cmu-argus-2/Avionics-JetsonCarrier/jetson-orin-baseboard.kicad_pcb

## KiCad design jetson-orin-baseboard.kicad_pcb (2026-10-01)

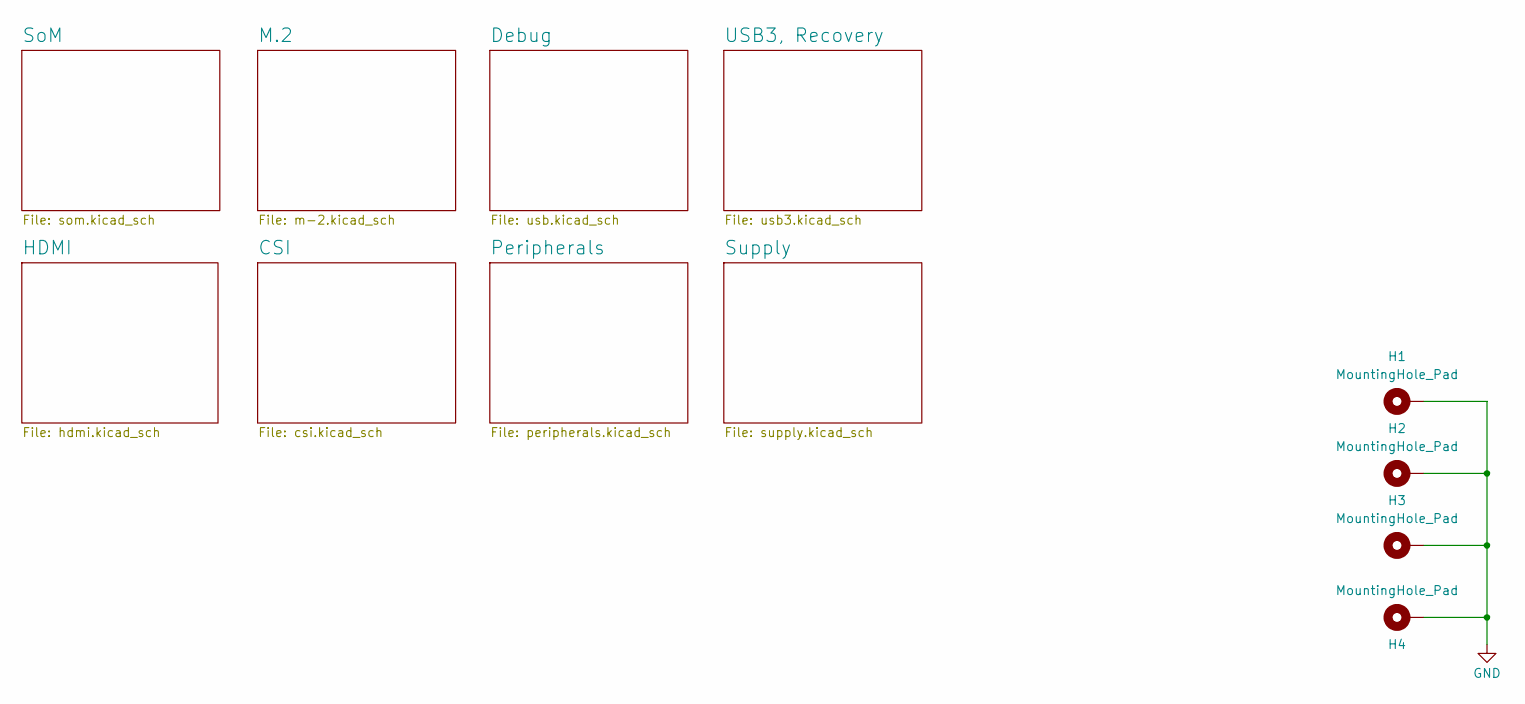
[picture p1: schematic jetson-orin-baseboard.kicad_sch, Argus Carrierboard]

Parts:
H1, H2, H3, H4: MountingHole_Pad; MountingHole_3.2mm_M3_Pad_Via

Connections:
GND: H1.1 (1_1), H2.1 (1_1), H3.1 (1_1), H4.1 (1_1); also elsewhere on the board

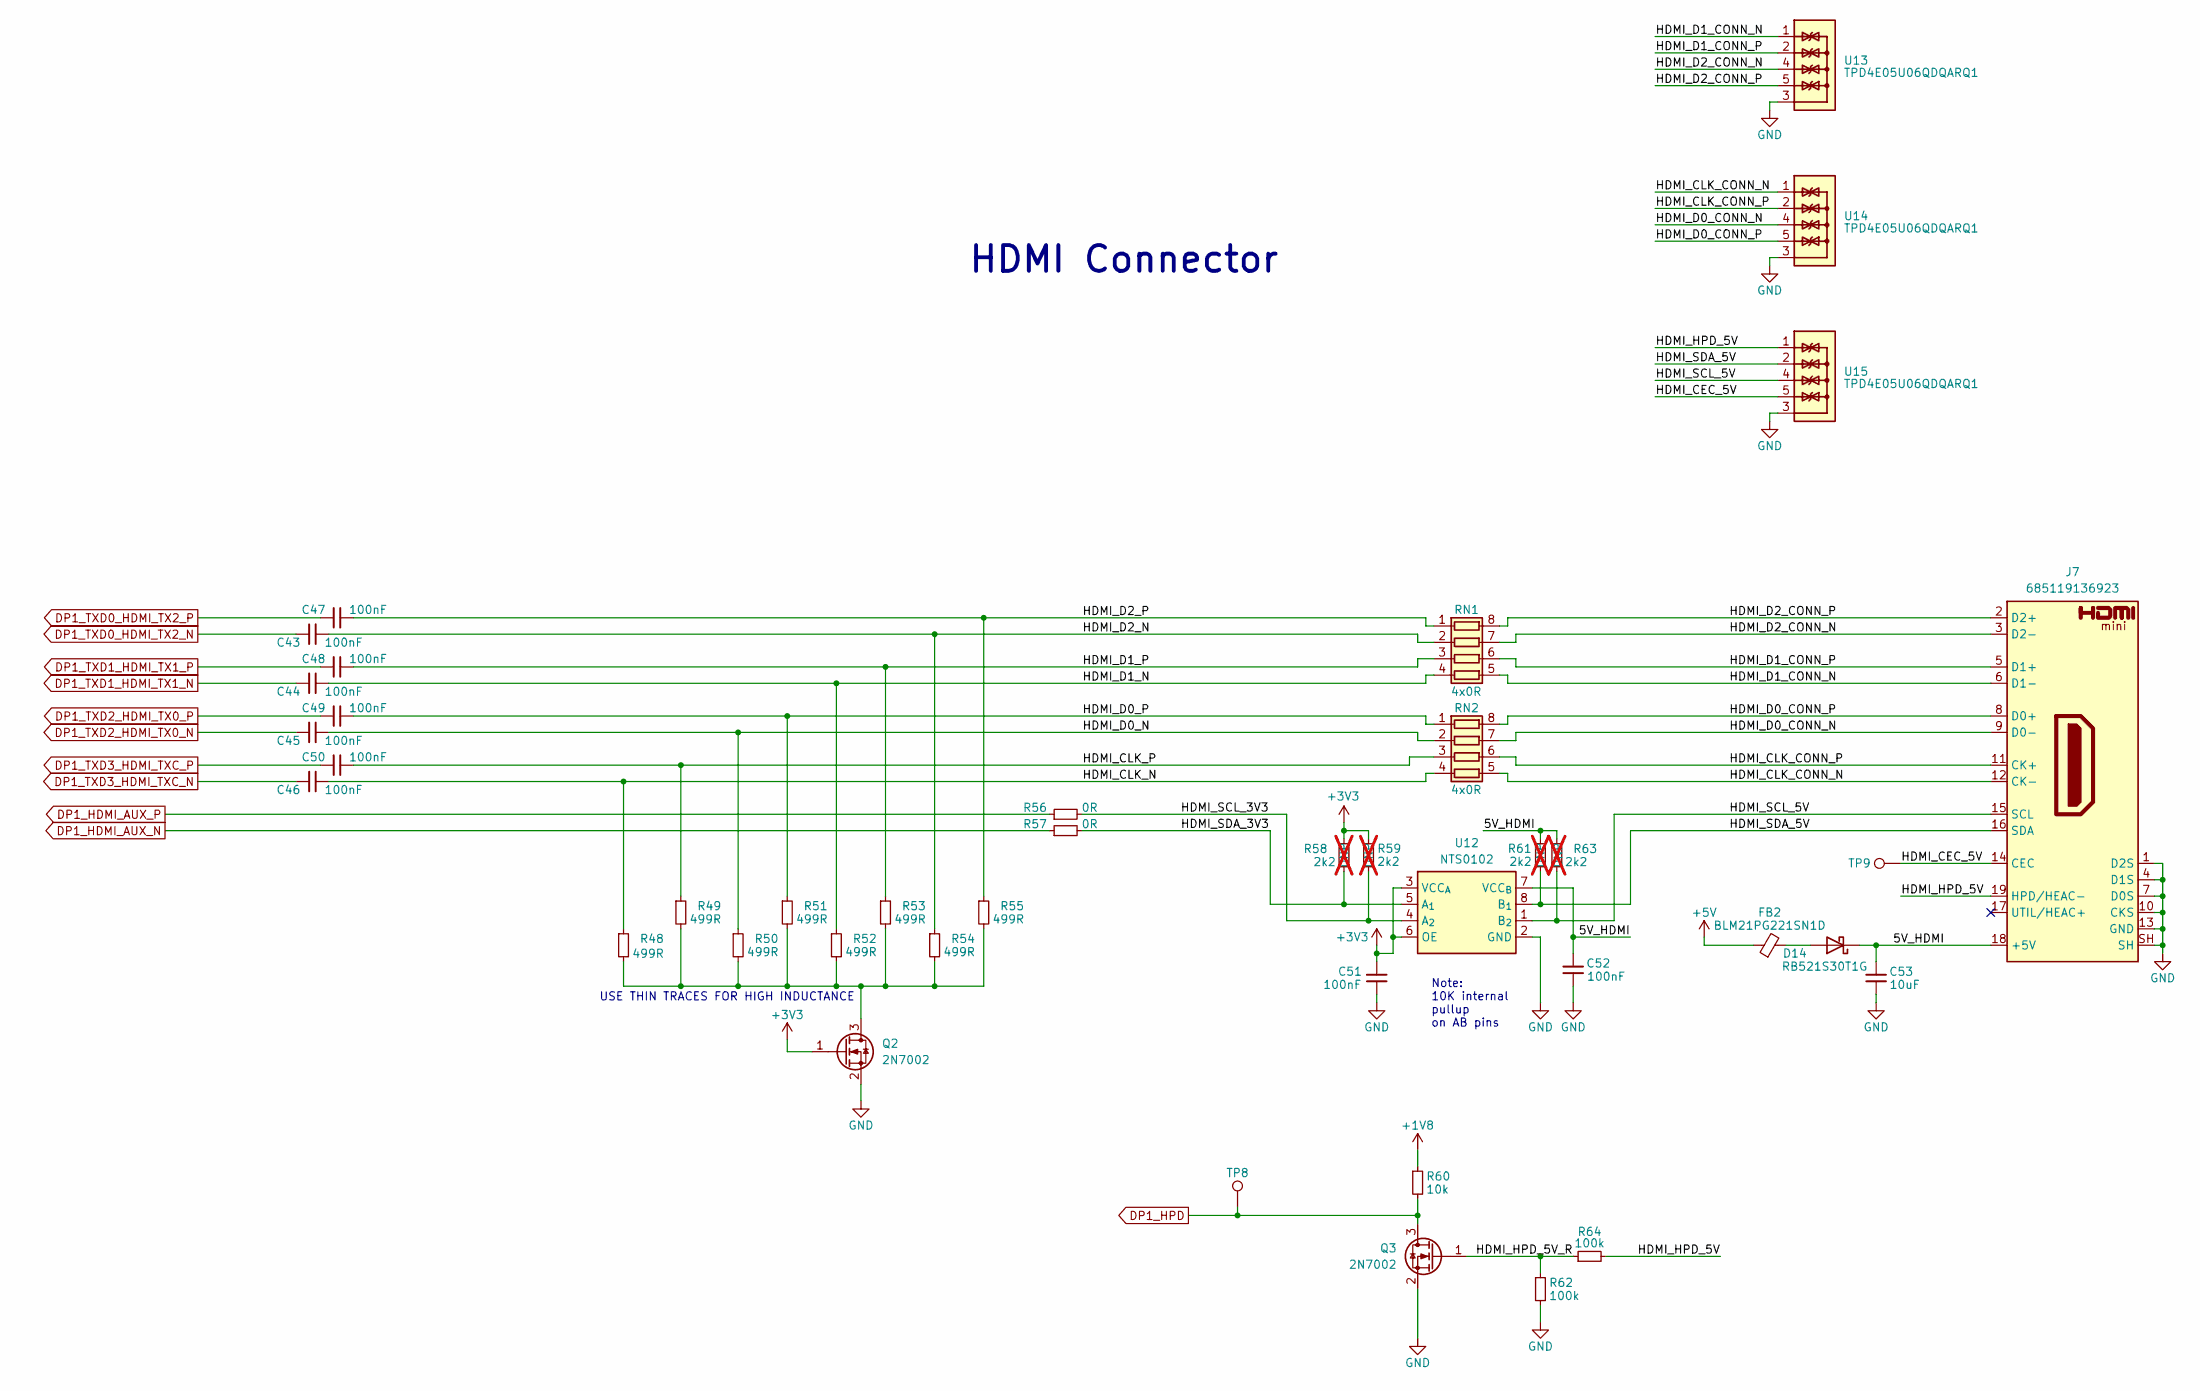
[picture p2: schematic hdmi.kicad_sch, Argus Carrierboard]

Parts:
C43, C44, C45, C46, C47, C48, C49, C50: 100nF; C_0402_1005Metric; MPN C85858; LCSC C307331
C51, C52: 100nF; C_0603_1608Metric; MPN C307348; LCSC C14663
C53: 10uF; C_0603_1608Metric; MPN C697423; LCSC C96446
D14: RB521S30T1G; D_SOD-523; MPN RB521S30T1G; LCSC C145179
FB2: BLM21PG221SN1D; L_0805_2012Metric; MPN C85840; LCSC C85840
J7: 685119136923; HDMI-Mini-C_Receptacle_WE_685119136923; MPN 685119136923; LCSC C2961651
Q2, Q3: 2N7002; SOT-23; LCSC C8545
R48, R49, R50, R51, R52, R53, R54, R55: 499R; R_0402_1005Metric; MPN C2076754; LCSC C4125
R56, R57: 0R; R_0402_1005Metric; MPN C190119; LCSC C17168
R58, R59, R61, R63: 2k2; R_0402_1005Metric; Tolerance 1%; MPN CR0402-FX-2201GLF; LCSC C25879; not fitted
R60: 10k; R_0603_1608Metric; MPN C2479067; LCSC C25804
R62, R64: 100k; R_0603_1608Metric; MPN C237792; LCSC C25803
RN1, RN2: 4x0R; R_Array_Concave_4x0402; MPN EXB-18VR000X; LCSC C2001
TP8, TP9: TP_0.75mm_SMD; TestPoint_Pad_D1.0mm
U12: NTS0102; NXP_XSON-8; MPN NTS0102GT; LCSC C2687851
U13, U14, U15: TPD4E05U06QDQARQ1; USON-10_TEX; MPN C81353; LCSC C81353

Connections:
+1V8: R60.1; also elsewhere on the board
+3V3: C51.1, Q2.1 (G), R58.1, R59.2, U12.3 (VCC_{A}), U12.6 (OE); also elsewhere on the board
+5V: FB2.1; also elsewhere on the board
/HDMI/5V_HDMI: C52.1, C53.1, D14.1 (K), J7.18 (+5V), R61.2, R63.1, U12.7 (VCC_{B})
/HDMI/HDMI_CEC_5V: J7.14 (CEC), TP9.1 (1_1), U15.5, U15.6
/HDMI/HDMI_CLK_CONN_N: J7.12 (CK-), RN2.5 (R4.2), U14.1, U14.10
/HDMI/HDMI_CLK_CONN_P: J7.11 (CK+), RN2.6 (R3.2), U14.2, U14.9
/HDMI/HDMI_CLK_N: C46.2, R48.1, RN2.4 (R4.1)
/HDMI/HDMI_CLK_P: C50.2, R49.1, RN2.3 (R3.1)
/HDMI/HDMI_D0_CONN_N: J7.9 (D0-), RN2.7 (R2.2), U14.4, U14.7
/HDMI/HDMI_D0_CONN_P: J7.8 (D0+), RN2.8 (R1.2), U14.5, U14.6
/HDMI/HDMI_D0_N: C45.2, R50.1, RN2.2 (R2.1)
/HDMI/HDMI_D0_P: C49.2, R51.1, RN2.1 (R1.1)
/HDMI/HDMI_D1_CONN_N: J7.6 (D1-), RN1.5 (R4.2), U13.1, U13.10
/HDMI/HDMI_D1_CONN_P: J7.5 (D1+), RN1.6 (R3.2), U13.2, U13.9
/HDMI/HDMI_D1_N: C44.2, R52.1, RN1.4 (R4.1)
/HDMI/HDMI_D1_P: C48.2, R53.1, RN1.3 (R3.1)
/HDMI/HDMI_D2_CONN_N: J7.3 (D2-), RN1.7 (R2.2), U13.4, U13.7
/HDMI/HDMI_D2_CONN_P: J7.2 (D2+), RN1.8 (R1.2), U13.5, U13.6
/HDMI/HDMI_D2_N: C43.2, R54.1, RN1.2 (R2.1)
/HDMI/HDMI_D2_P: C47.2, R55.1, RN1.1 (R1.1)
/HDMI/HDMI_HPD_5V: J7.19 (HPD/HEAC-), R64.2, U15.1, U15.10
/HDMI/HDMI_HPD_5V_R: Q3.1 (G), R62.1, R64.1
/HDMI/HDMI_SCL_3V3: R56.2, R59.1, U12.4 (A_{2})
/HDMI/HDMI_SCL_5V: J7.15 (SCL), R63.2, U12.1 (B_{2}), U15.4, U15.7
/HDMI/HDMI_SDA_3V3: R57.2, R58.2, U12.5 (A_{1})
/HDMI/HDMI_SDA_5V: J7.16 (SDA), R61.1, U12.8 (B_{1}), U15.2, U15.9
DP1_HDMI_AUX_N: R57.1; also elsewhere on the board
DP1_HDMI_AUX_P: R56.1; also elsewhere on the board
DP1_HPD: Q3.3 (D), R60.2, TP8.1 (1_1); also elsewhere on the board
DP1_TXD0_HDMI_TX2_N: C43.1; also elsewhere on the board
DP1_TXD0_HDMI_TX2_P: C47.1; also elsewhere on the board
DP1_TXD1_HDMI_TX1_N: C44.1; also elsewhere on the board
DP1_TXD1_HDMI_TX1_P: C48.1; also elsewhere on the board
DP1_TXD2_HDMI_TX0_N: C45.1; also elsewhere on the board
DP1_TXD2_HDMI_TX0_P: C49.1; also elsewhere on the board
DP1_TXD3_HDMI_TXC_N: C46.1; also elsewhere on the board
DP1_TXD3_HDMI_TXC_P: C50.1; also elsewhere on the board
GND: C51.2, C52.2, C53.2, J7.1 (D2S), J7.4 (D1S), J7.7 (D0S), J7.10 (CKS), J7.13 (GND), J7.SH, Q2.2 (S), Q3.2 (S), R62.2, U12.2 (GND), U13.3, U13.8, U14.3, U14.8, U15.3, U15.8; also elsewhere on the board
unnamed: D14.2 (A), FB2.2
unnamed: Q2.3 (D), R48.2, R49.2, R50.2, R51.2, R52.2, R53.2, R54.2, R55.2

Notes on the sheet:
USE THIN TRACES FOR HIGH INDUCTANCE
Note: 10K internal pullup on AB pins
HDMI Connector

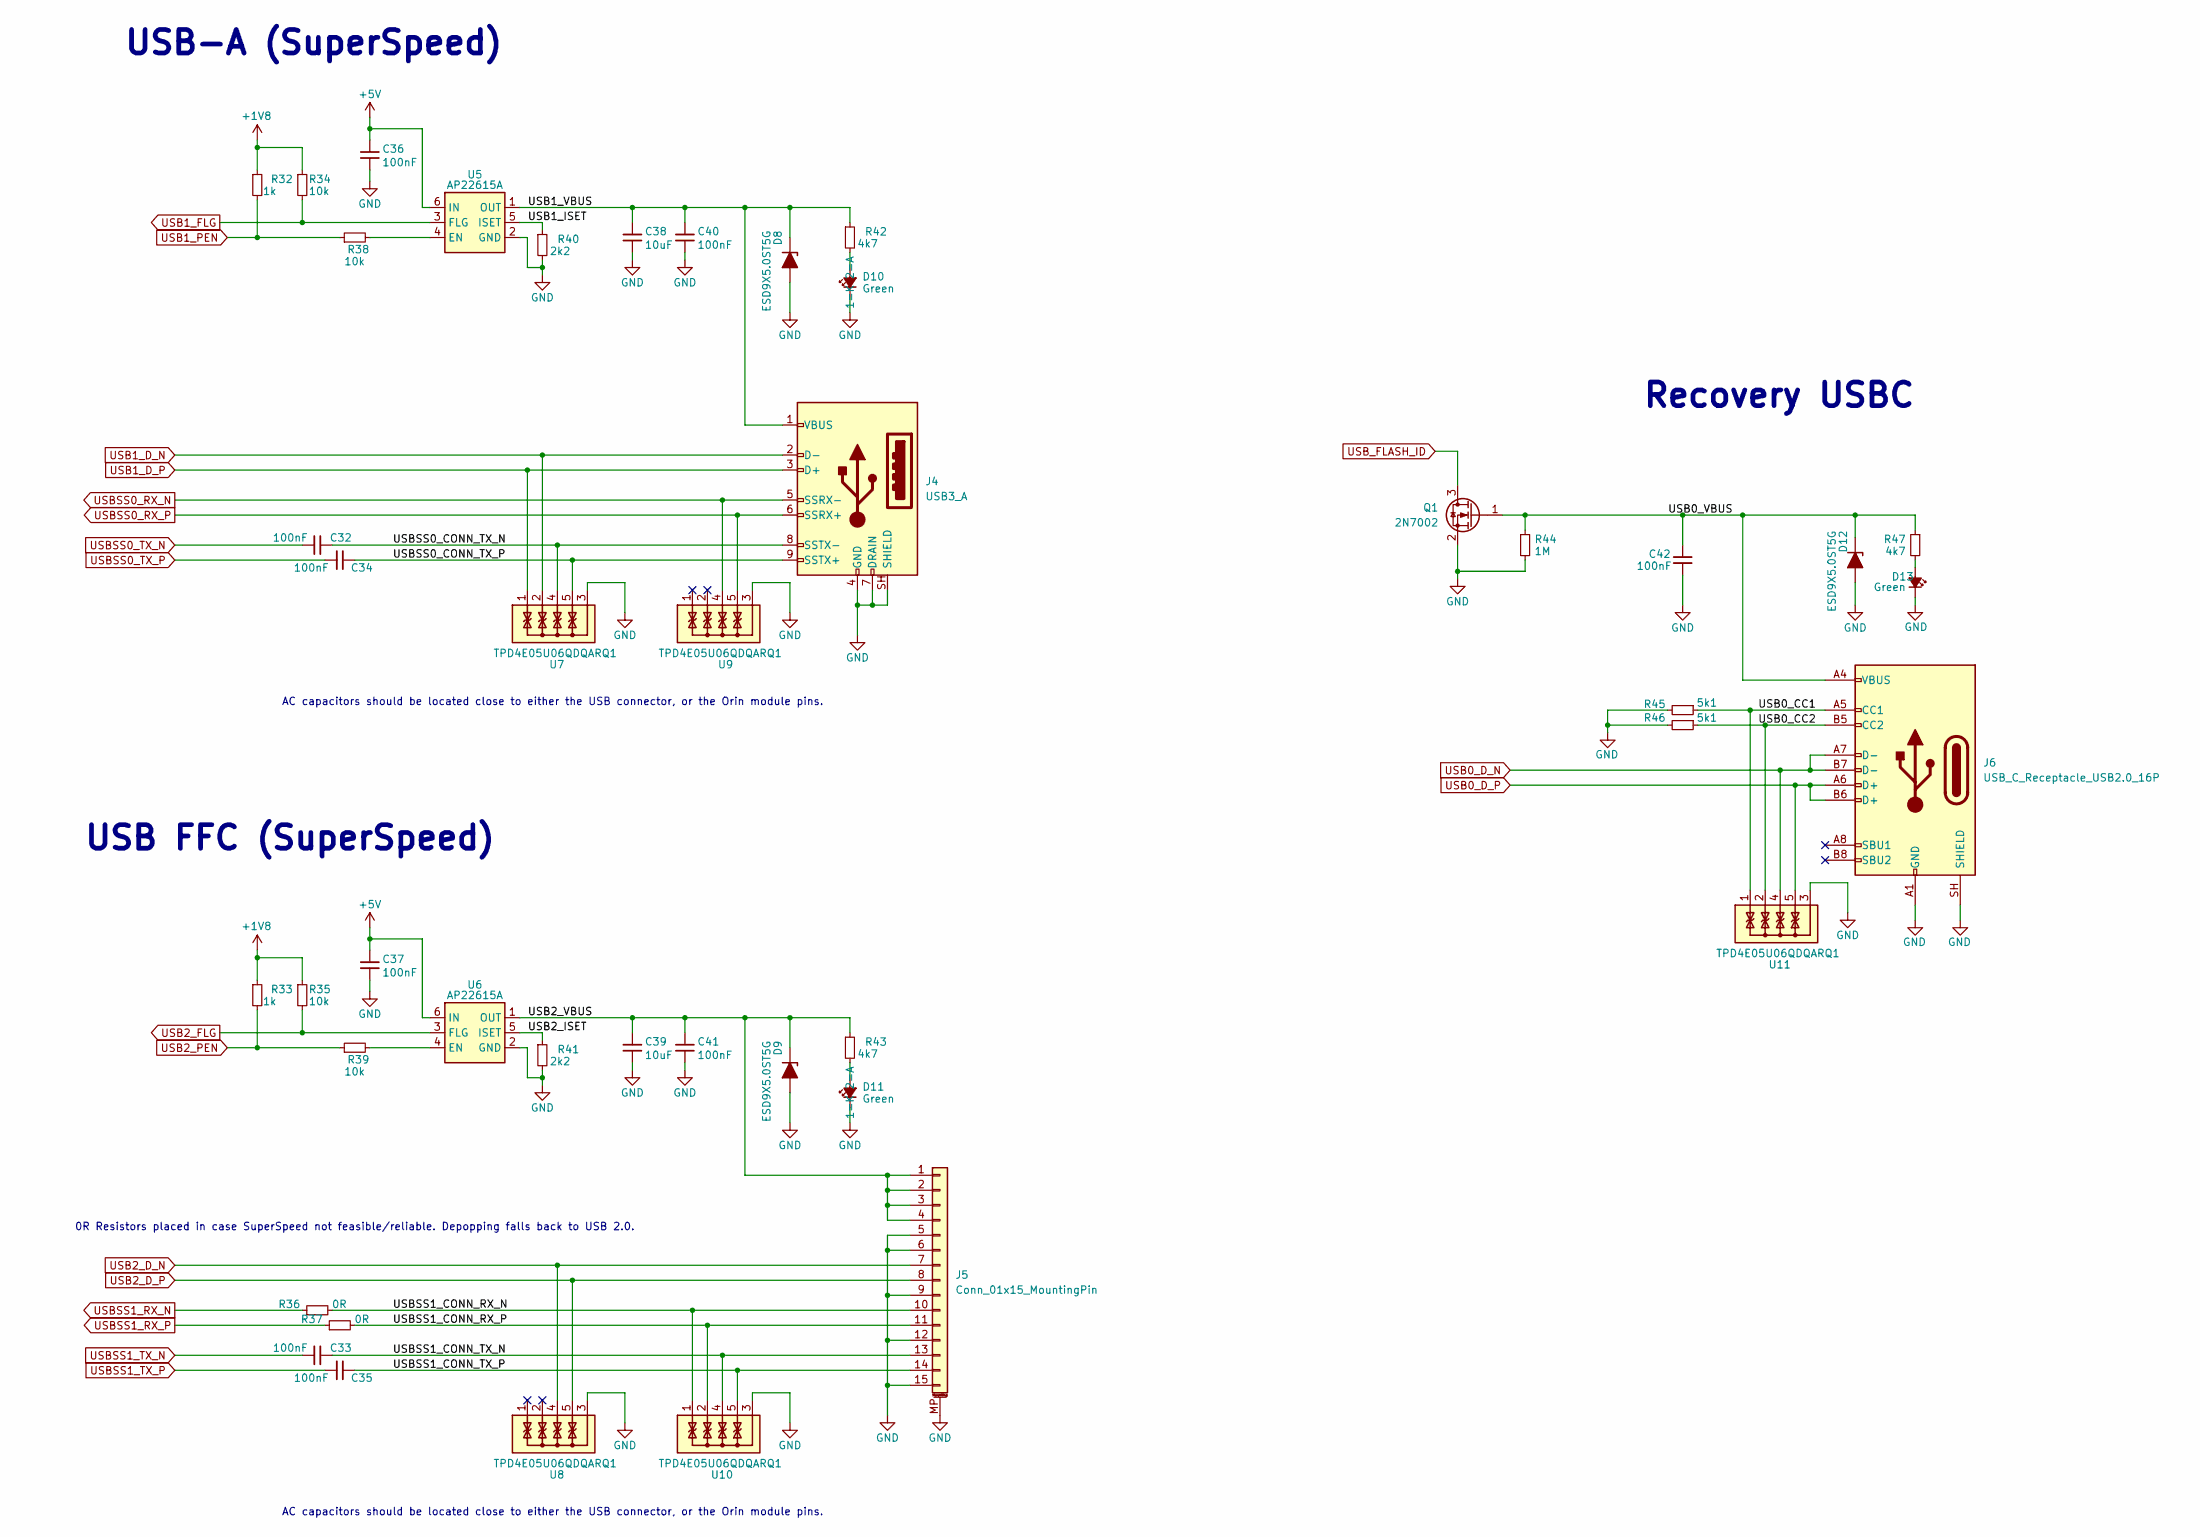
[picture p3: schematic usb3.kicad_sch, Argus Carrierboard]

Parts:
C32, C33, C34, C35: 100nF; C_0402_1005Metric; MPN C85858; LCSC C307331
C36, C37, C40, C41, C42: 100nF; C_0603_1608Metric; MPN C307348; LCSC C14663
C38, C39: 10uF; C_0603_1608Metric; MPN C697423; LCSC C96446
D8, D9, D12: ESD9X5.0ST5G; D_SOD-923; MPN C87910; LCSC C87910
D10, D11, D13: LED_G_0603_LTST-C190GKT; LED_0603_1608Metric; MPN C2909774; LCSC C12065
J4: USB3_A; USB-A_3.0_GSB311131HR; LCSC C473057
J5: Conn_01x15_MountingPin; Amphenol_F32Q-1A7x1-11015_1x15-1MP_P0.5mm_Horizontal
J6: USB_C_Receptacle_USB2.0_16P; USB_C_Receptacle_GCT_USB4105-xx-A_16P_TopMnt_Horizontal; LCSC C3020560
Q1: 2N7002; SOT-23; LCSC C8545
R32, R33: 1k; R_0603_1608Metric; MPN C71623; LCSC C21190
R34, R35, R38, R39: 10k; R_0603_1608Metric; MPN C71617; LCSC C25804
R36, R37: 0R; R_0402_1005Metric; MPN C190119; LCSC C17168
R40, R41: 2k2; R_0603_1608Metric; MPN C2076947; LCSC C4190
R42, R43: 4k7; R_0603_1608Metric; MPN C482193; LCSC C23162
R44: 1M; R_0603_1608Metric; MPN C844931; LCSC C22935
R45, R46: 5k1; R_0603_1608Metric; MPN C490833; LCSC C23186
R47: 4k7; R_0603_1608Metric; MPN C844931; LCSC C23162
U5, U6: AP22615A; TSOT-23-6; MPN C2680357; LCSC C2680357
U7, U8, U9, U10, U11: TPD4E05U06QDQARQ1; USON-10_TEX; MPN C81353; LCSC C81353

Connections:
+1V8: R32.1, R33.1, R34.1, R35.1; also elsewhere on the board
+5V: C36.2, C37.2, U5.6 (IN), U6.6 (IN); also elsewhere on the board
/USB3, Recovery/USB0_CC1: J6.A5 (CC1), R45.1, U11.1, U11.10
/USB3, Recovery/USB0_CC2: J6.B5 (CC2), R46.1, U11.2, U11.9
/USB3, Recovery/USB0_VBUS: C42.2, D12.1 (K), J6.A4 (VBUS), J6.A9 (VBUS), J6.B4 (VBUS), J6.B9 (VBUS), Q1.1 (G), R44.1, R47.1
/USB3, Recovery/USB1_ISET: R40.1, U5.5 (ISET)
/USB3, Recovery/USB1_VBUS: C38.2, C40.2, D8.1 (K), J4.1 (VBUS), R42.1, U5.1 (OUT)
/USB3, Recovery/USB2_ISET: R41.1, U6.5 (ISET)
/USB3, Recovery/USB2_VBUS: C39.2, C41.2, D9.1 (K), J5.1, J5.2, J5.3, J5.4, R43.1, U6.1 (OUT)
/USB3, Recovery/USBSS0_CONN_TX_N: C32.1, J4.8 (SSTX-), U7.4, U7.7
/USB3, Recovery/USBSS0_CONN_TX_P: C34.1, J4.9 (SSTX+), U7.5, U7.6
/USB3, Recovery/USBSS1_CONN_RX_N: J5.10, R36.2, U10.1, U10.10
/USB3, Recovery/USBSS1_CONN_RX_P: J5.11, R37.2, U10.2, U10.9
/USB3, Recovery/USBSS1_CONN_TX_N: C33.1, J5.13, U10.4, U10.7
/USB3, Recovery/USBSS1_CONN_TX_P: C35.1, J5.14, U10.5, U10.6
GND: C36.1, C37.1, C38.1, C39.1, C40.1, C41.1, C42.1, D8.2 (A), D9.2 (A), D10.1 (K), D11.1 (K), D12.2 (A), D13.1 (K), J4.4 (GND), J4.7 (DRAIN), J4.SH (SHIELD), J5.5, J5.6, J5.9, J5.12, J5.15, J5.MP (MountPin), J6.A1 (GND), J6.A12 (GND), J6.B1 (GND), J6.B12 (GND), J6.SH (SHIELD), Q1.2 (S), R40.2, R41.2, R44.2, R45.2, R46.2, U5.2 (GND), U6.2 (GND), U7.3, U7.8, U8.3, U8.8, U9.3, U9.8, U10.3, U10.8, U11.3, U11.8; also elsewhere on the board
unnamed: D10.2 (A), R42.2
unnamed: D11.2 (A), R43.2
unnamed: D13.2 (A), R47.2
unnamed: R38.2, U5.4 (EN)
unnamed: R39.2, U6.4 (EN)
USB0_D_N: J6.A7 (D-), J6.B7 (D-), U11.4, U11.7; also elsewhere on the board
USB0_D_P: J6.A6 (D+), J6.B6 (D+), U11.5, U11.6; also elsewhere on the board
USB1_D_N: J4.2 (D-), U7.2, U7.9; also elsewhere on the board
USB1_D_P: J4.3 (D+), U7.1, U7.10; also elsewhere on the board
USB1_FLG: R34.2, U5.3 (FLG); also elsewhere on the board
USB1_PEN: R32.2, R38.1; also elsewhere on the board
USB2_D_N: J5.7, U8.4, U8.7; also elsewhere on the board
USB2_D_P: J5.8, U8.5, U8.6; also elsewhere on the board
USB2_FLG: R35.2, U6.3 (FLG); also elsewhere on the board
USB2_PEN: R33.2, R39.1; also elsewhere on the board
USBSS0_RX_N: J4.5 (SSRX-), U9.4, U9.7; also elsewhere on the board
USBSS0_RX_P: J4.6 (SSRX+), U9.5, U9.6; also elsewhere on the board
USBSS0_TX_N: C32.2; also elsewhere on the board
USBSS0_TX_P: C34.2; also elsewhere on the board
USBSS1_RX_N: R36.1; also elsewhere on the board
USBSS1_RX_P: R37.1; also elsewhere on the board
USBSS1_TX_N: C33.2; also elsewhere on the board
USBSS1_TX_P: C35.2; also elsewhere on the board
USB_FLASH_ID: Q1.3 (D); also elsewhere on the board

Notes on the sheet:
0R Resistors placed in case SuperSpeed not feasible/reliable. Depopping falls back to USB 2.0.
USB-A (SuperSpeed)
AC capacitors should be located close to either the USB connector, or the Orin module pins.
USB FFC (SuperSpeed)
Recovery USBC

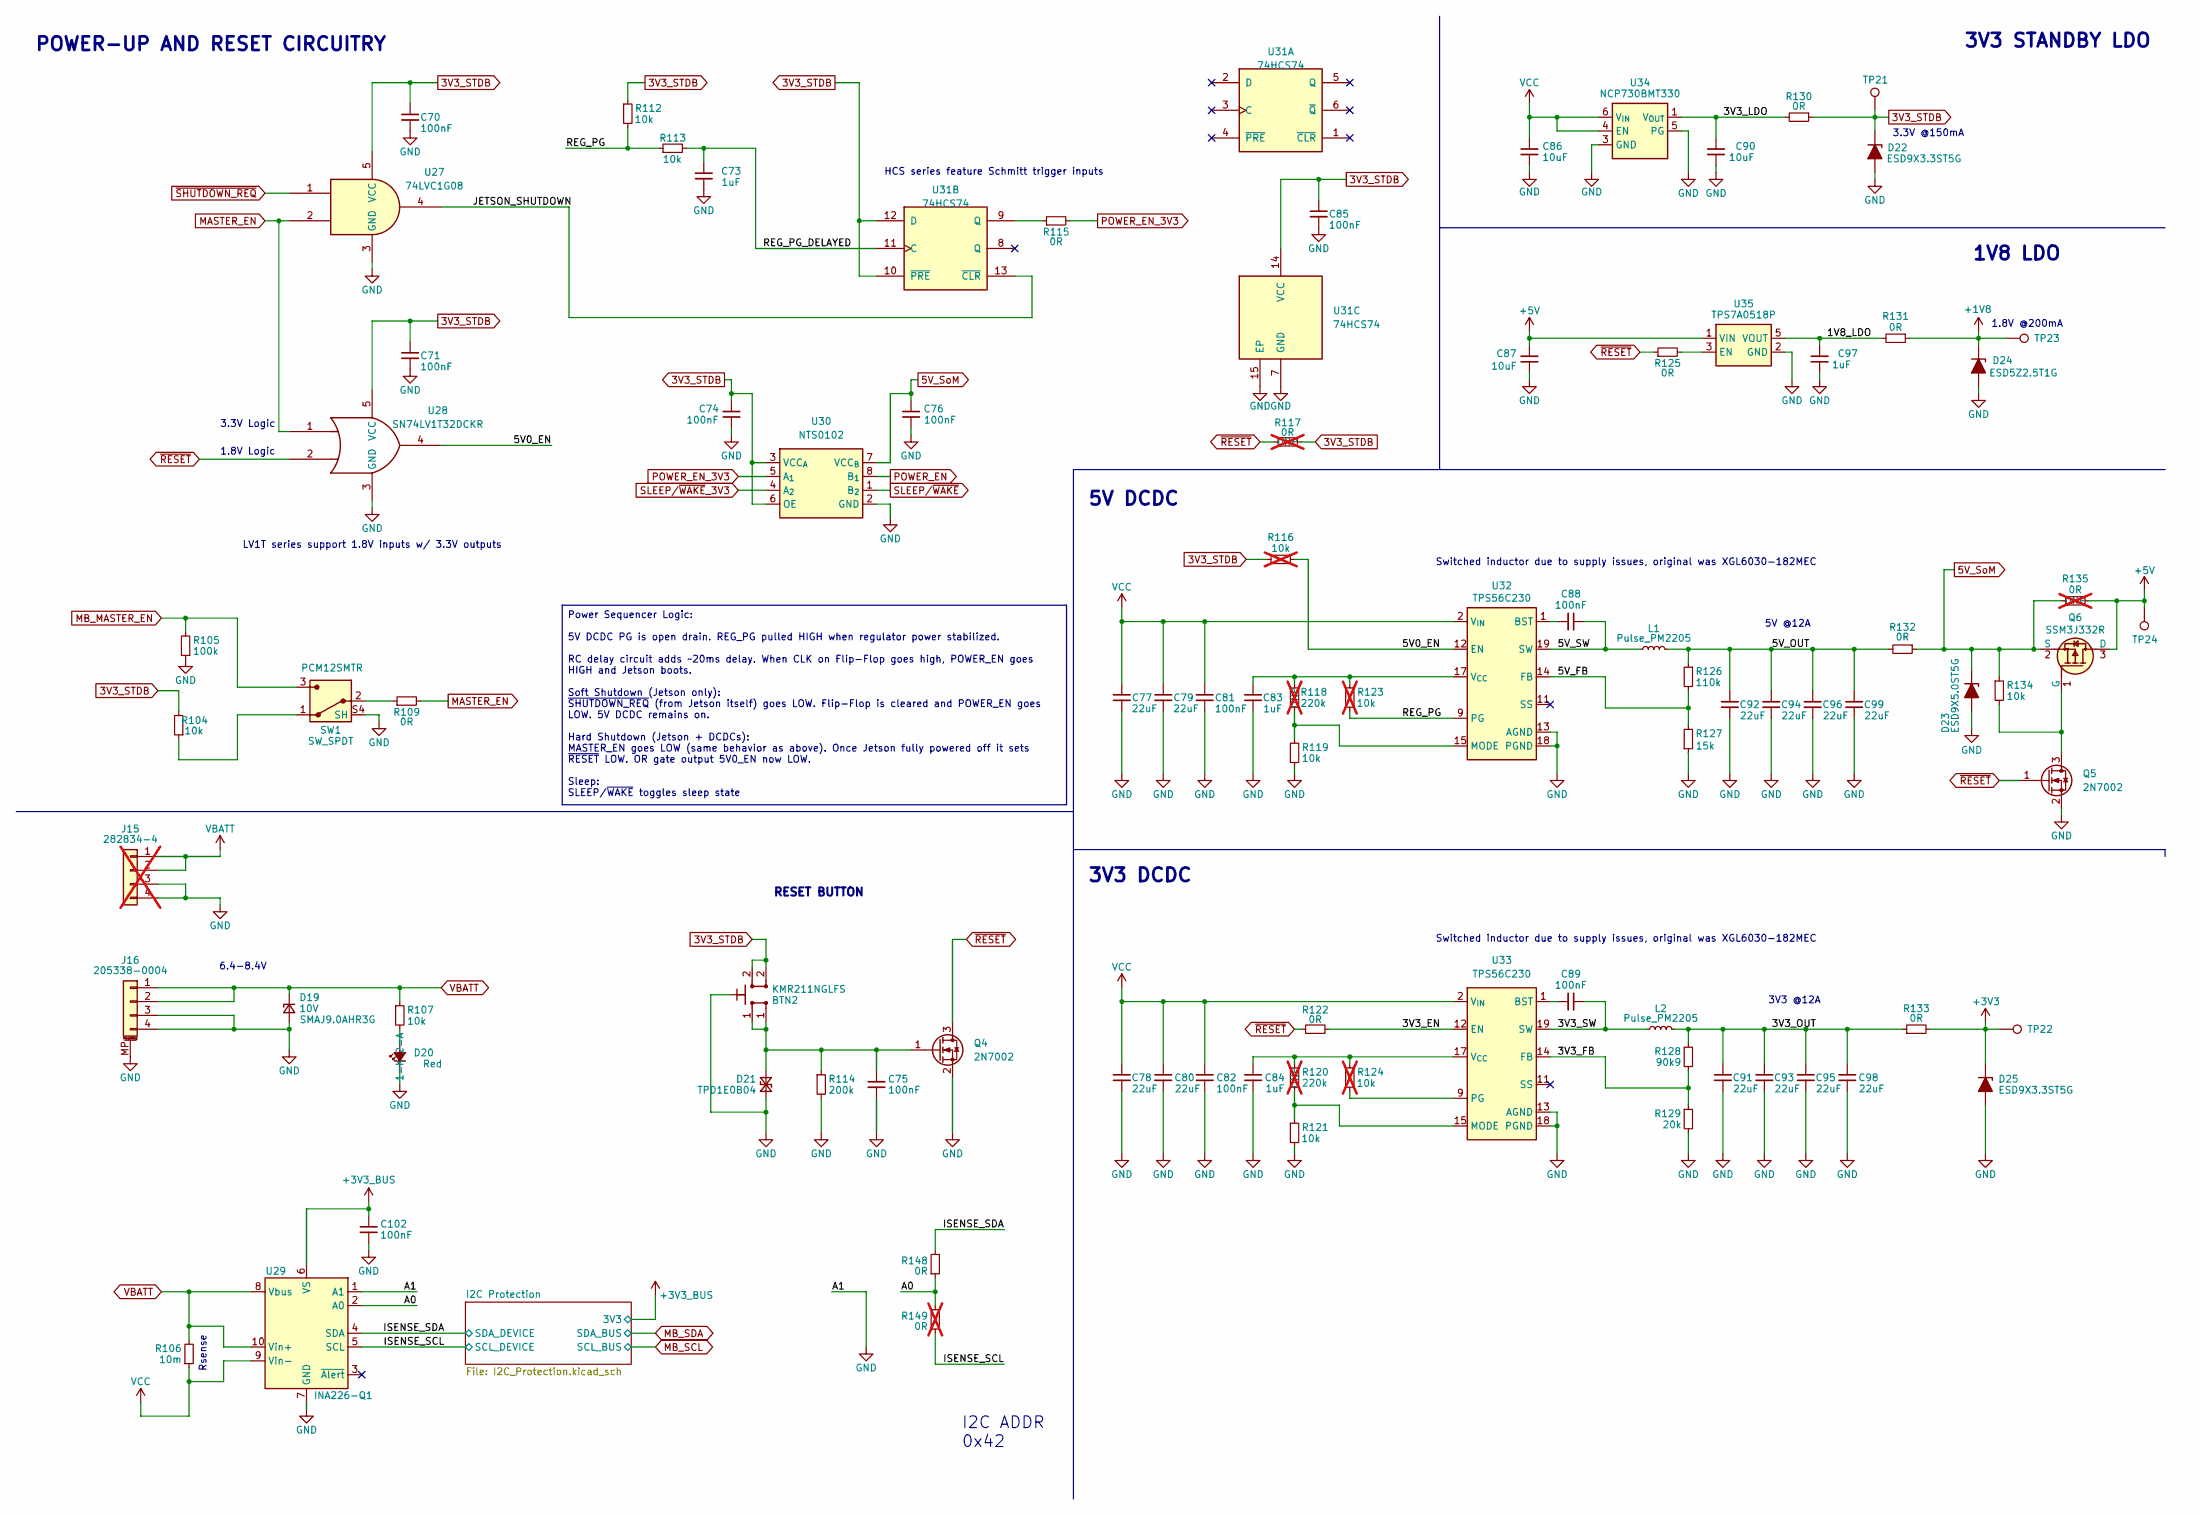
[picture p4: schematic supply.kicad_sch, Argus Carrierboard]

Parts:
BTN2: KMR211NGLFS; SW_Push_1P1T-SH_NO_CK_KMR2xxG; MPN C221676; LCSC C221676
C70, C71, C74, C75, C76, C81, C82, C85, C88, C89: 100nF; C_0603_1608Metric; MPN C307348; LCSC C14663
C73, C83, C84, C97: 1uF; C_0603_1608Metric; MPN C2214844; LCSC C15849
C77, C78, C79, C80: 22uF; C_0805_2012Metric; Voltage 25V; MPN CL21A226MAYNNNE; LCSC C45783
C86, C87, C90: 10uF; C_0603_1608Metric; MPN C697423; LCSC C96446
C91, C92, C93, C94, C95, C96, C98, C99: 22uF; C_0603_1608Metric; MPN C2762594; LCSC C84419
C102: 100nF; C_0603_1608Metric; MPN C2803395; LCSC C14663
D19: 10V; D_SMA; Part SMAJ9.0AHR3G; LCSC C3720382
D20: LED_G_0603_LTST-C190GKT; LED_0603_1608Metric; MPN C2909774; LCSC C2286
D21: TPD1E0B04; Texas_DPY0002A_0.6x1mm_P0.65mm; MPN C1975594; LCSC C1975594
D22, D25: ESD9X3.3ST5G; D_SOD-923; MPN C130456; LCSC C130456
D23: ESD9X5.0ST5G; D_SOD-923; MPN C87910; LCSC C87910
D24: ESD5Z2.5T1G; D_SOD-523; MPN ESD9X5.0ST5G; LCSC C890620
J15: 282834-4; TE_282834-4; not fitted
J16: 205338-0004; Molex_Pico-Lock_205338-0004_1x04-1MP_P2.00mm_Horizontal; MPN C916325; LCSC C916325
L1, L2: Pulse_PM2205; MPN XAL6030-182MEC; LCSC C2638799
Q4, Q5: 2N7002; SOT-23; LCSC C8545
Q6: SSM3J332R; SOT-23-3; MPN SSM3J332R,LF; LCSC C146367
R104, R107, R112, R113, R119, R121, R134: 10k; R_0603_1608Metric; MPN C2479067; LCSC C25804
R105: 100k; R_0603_1608Metric; MPN C2479067; LCSC C25803
R106: 10m; R_2512_6332Metric; MPN C840621; LCSC C108943
R109, R115: 0R; R_0603_1608Metric; MPN C190119; LCSC C21189
R114: 200k; R_0603_1608Metric; MPN C118142; LCSC C25811
R116, R123, R124: 10k; R_0603_1608Metric; MPN C2479067; LCSC C25804; not fitted
R117: 0R; R_0402_1005Metric; MPN ERJ2GE0R00X; LCSC C17168; not fitted
R118, R120: 220k; R_0603_1608Metric; Tolerance 1%; MPN CR0402-FX-2203GLF; LCSC C22961; not fitted
R122, R125, R130, R131, R148: 0R; R_0603_1608Metric; MPN C844915; LCSC C21189
R126: 110k; R_0603_1608Metric; MPN C473255; LCSC C25574
R127: 15k; R_0603_1608Metric; MPN C844742; LCSC C22809
R128: 90k9; R_0603_1608Metric; MPN C403390; LCSC C23129
R129: 20k; R_0603_1608Metric; MPN C844923; LCSC C4184
R132, R133: 0R; R_0805_2012Metric; MPN C844934; LCSC C17477
R135: 0R; R_0805_2012Metric; MPN PMR03EZPJ000; LCSC C17477; not fitted
R149: 0R; R_0603_1608Metric; MPN C844915; LCSC C21189; not fitted
SW1: SW_SPDT; SW_SPDT_PCM12; MPN PCM12SMTR; LCSC C221841
TP21, TP22, TP23, TP24: TP_0.75mm_SMD; TestPoint_Pad_D1.0mm
U27: 74LVC1G08; SOT-353_SC-70-5; LCSC C7832
U28: SN74LV1T32DCKR; SOT-353_SC-70-5; LCSC C470953
U29: INA226-Q1; TSSOP-10_3x3mm_P0.5mm; LCSC C2653835
U30: NTS0102; NXP_XSON-8; MPN NTS0102GT; LCSC C2687851
U31: 74HCS74; DHWQFN-14-1EP_2.5x3mm_P0.5mm_EP1x1.5mm; LCSC C2916506
U32, U33: TPS56C230; QFN-20-1EP_3x3mm_P0.45mm; MPN C1849534; LCSC C1849534
U34: NCP730BMT330; WSON-6-1EP_2x2mm_P0.65mm; MPN C892821; LCSC C892821
U35: TPS7A0518P; SOT-23-5; MPN C2862322; LCSC C2862322

Connections:
3V3_STDB: BTN2.2, C70.1, C71.1, C74.1, C85.1, D22.1 (K), R104.2, R112.1, R116.2, R117.2, R130.1, TP21.1 (1_1), U27.5 (VCC), U28.5 (VCC), U30.3 (VCC_{A}), U30.6 (OE), U31.10 (~PRE), U31.12 (D), U31.14 (VCC); also elsewhere on the board
5V_SoM: C76.1, D23.1 (K), Q6.2 (S), R132.1, R134.1, R135.1, U30.7 (VCC_{B}); also elsewhere on the board
+1V8: D24.1 (K), R131.1, TP23.1 (1_1); also elsewhere on the board
+3V3: D25.1 (K), R133.2, TP22.1 (1_1); also elsewhere on the board
+3V3_BUS: C102.2, U29.6 (VS); also elsewhere on the board
+5V: C87.1, Q6.3 (D), R135.2, TP24.1 (1_1), U35.1 (VIN); also elsewhere on the board
/Supply/1V8_LDO: C97.1, R131.2, U35.5 (VOUT)
/Supply/3V3_EN: R122.2, U33.12 (EN)
/Supply/3V3_FB: R128.1, R129.1, U33.14 (FB)
/Supply/3V3_LDO: C90.1, R130.2, U34.1 (V_{OUT})
/Supply/3V3_OUT: C91.1, C93.1, C95.1, C98.1, L2.2, R128.2, R133.1
/Supply/3V3_SW: C89.1, L2.1, U33.6 (SW), U33.19 (SW), U33.20 (SW)
/Supply/5V0_EN: R116.1, U28.4, U32.12 (EN)
/Supply/5V_FB: R126.2, R127.2, U32.14 (FB)
/Supply/5V_OUT: C92.1, C94.1, C96.1, C99.1, L1.2, R126.1, R132.2
/Supply/5V_SW: C88.1, L1.1, U32.6 (SW), U32.19 (SW), U32.20 (SW)
/Supply/A0: R148.1, R149.2, U29.2 (A0)
/Supply/ISENSE_SCL: R149.1, U29.5 (SCL); also elsewhere on the board
/Supply/ISENSE_SDA: R148.2, U29.4 (SDA); also elsewhere on the board
/Supply/JETSON_SHUTDOWN: U27.4, U31.13 (~CLR)
/Supply/REG_PG: R112.2, R113.1, R123.2, U32.9 (PG)
/Supply/REG_PG_DELAYED: C73.1, R113.2, U31.11 (C)
GND: BTN2.SH, C70.2, C71.2, C73.2, C74.2, C75.1, C76.2, C77.1, C78.2, C79.1, C80.2, C81.2, C82.2, C83.2, C84.1, C85.2, C86.2, C87.2, C90.2, C91.2, C92.2, C93.2, C94.2, C95.2, C96.2, C97.2, C98.2, C99.2, C102.1, D19.2 (A), D20.1 (K), D21.1 (A1), D22.2 (A), D23.2 (A), D24.2 (A), D25.2 (A), J15.3, J15.4, J16.3, J16.4, J16.MP (MountPin), Q4.2 (S), Q5.2 (S), R105.1, R114.2, R119.1, R121.2, R127.1, R129.2, SW1.S1 (SH), SW1.S2 (SH), SW1.S3 (SH), SW1.S4 (SH_S4), U27.3 (GND), U28.3 (GND), U29.1 (A1), U29.7 (GND), U30.2 (GND), U31.7 (GND), U31.15 (EP), U32.7 (PGND), U32.8 (PGND), U32.13 (AGND), U32.18 (PGND), U32.21 (PGND), U33.7 (PGND), U33.8 (PGND), U33.13 (AGND), U33.18 (PGND), U33.21 (PGND), U34.3 (GND), U34.5 (PG), U34.7 (GND), U35.2 (GND); also elsewhere on the board
MASTER_EN: R109.2, U27.2, U28.1
MB_MASTER_EN: R105.2, SW1.3; also elsewhere on the board
unnamed: D20.2 (A), R107.2
unnamed: BTN2.1, C75.2, D21.2 (A2), Q4.1 (G), R114.1
unnamed: Q5.3 (D), Q6.1 (G), R134.2
unnamed: R104.1, SW1.1
unnamed: R109.1, SW1.2
unnamed: R115.1, U31.9 (Q)
unnamed: C88.2, U32.1 (BST)
unnamed: R118.2, R119.2, U32.15 (MODE)
unnamed: C83.1, R118.1, R123.1, U32.17 (V_{CC})
unnamed: C89.2, U33.1 (BST)
unnamed: R120.1, R121.1, U33.15 (MODE)
unnamed: R124.2, U33.9 (PG)
unnamed: C84.2, R120.2, R124.1, U33.17 (V_{CC})
unnamed: R125.2, U35.3 (EN)
POWER_EN: U30.8 (B_{1}); also elsewhere on the board
POWER_EN_3V3: R115.2, U30.5 (A_{1})
SLEEP/~WAKE: U30.1 (B_{2}); also elsewhere on the board
SLEEP/~WAKE_3V3: U30.4 (A_{2}); also elsewhere on the board
VBATT: D19.1 (K), J15.1, J15.2, J16.1, J16.2, R106.2, R107.1, U29.8 (Vbus), U29.10 (Vin+); also elsewhere on the board
VCC: C77.2, C78.1, C79.2, C80.1, C81.1, C82.1, C86.1, R106.1, U29.9 (Vin-), U32.2 (V_{IN}), U32.3 (V_{IN}), U32.4 (V_{IN}), U32.5 (V_{IN}), U33.2 (V_{IN}), U33.3 (V_{IN}), U33.4 (V_{IN}), U33.5 (V_{IN}), U34.4 (EN), U34.6 (V_{IN})
~RESET: Q4.3 (D), Q5.1 (G), R117.1, R122.1, R125.1, U28.2; also elsewhere on the board
~SHUTDOWN_REQ: U27.1; also elsewhere on the board

Notes on the sheet:
5V @12A
Switched inductor due to supply issues, original was XGL6030-182MEC
3.3V Logic
3V3 STANDBY LDO
3.3V @150mA
LV1T series support 1.8V inputs w/ 3.3V outputs
1V8 LDO
5V DCDC
POWER-UP AND RESET CIRCUITRY
3V3 @12A
6.4-8.4V
3V3 DCDC
1.8V Logic
1.8V @200mA
HCS series feature Schmitt trigger inputs
Rsense
RESET BUTTON
I2C ADDR 0x42
Power Sequencer Logic: 5V DCDC PG is open drain. REG_PG pulled HIGH when regulator power stabilized. RC delay circuit adds ~20ms delay. When CLK on Flip-Flop goes high, POWER_EN goes HIGH and Jetson boots. Soft Shutdown (Jetson only): ~{SHUTDOWN_REQ} (from Jetson itself) goes LOW. Flip-Flop is clea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
