cmu-argus-2/Avionics-JetsonCarrier/jetson-orin-baseboard.kicad_pcb

## KiCad design jetson-orin-baseboard.kicad_pcb (continued)

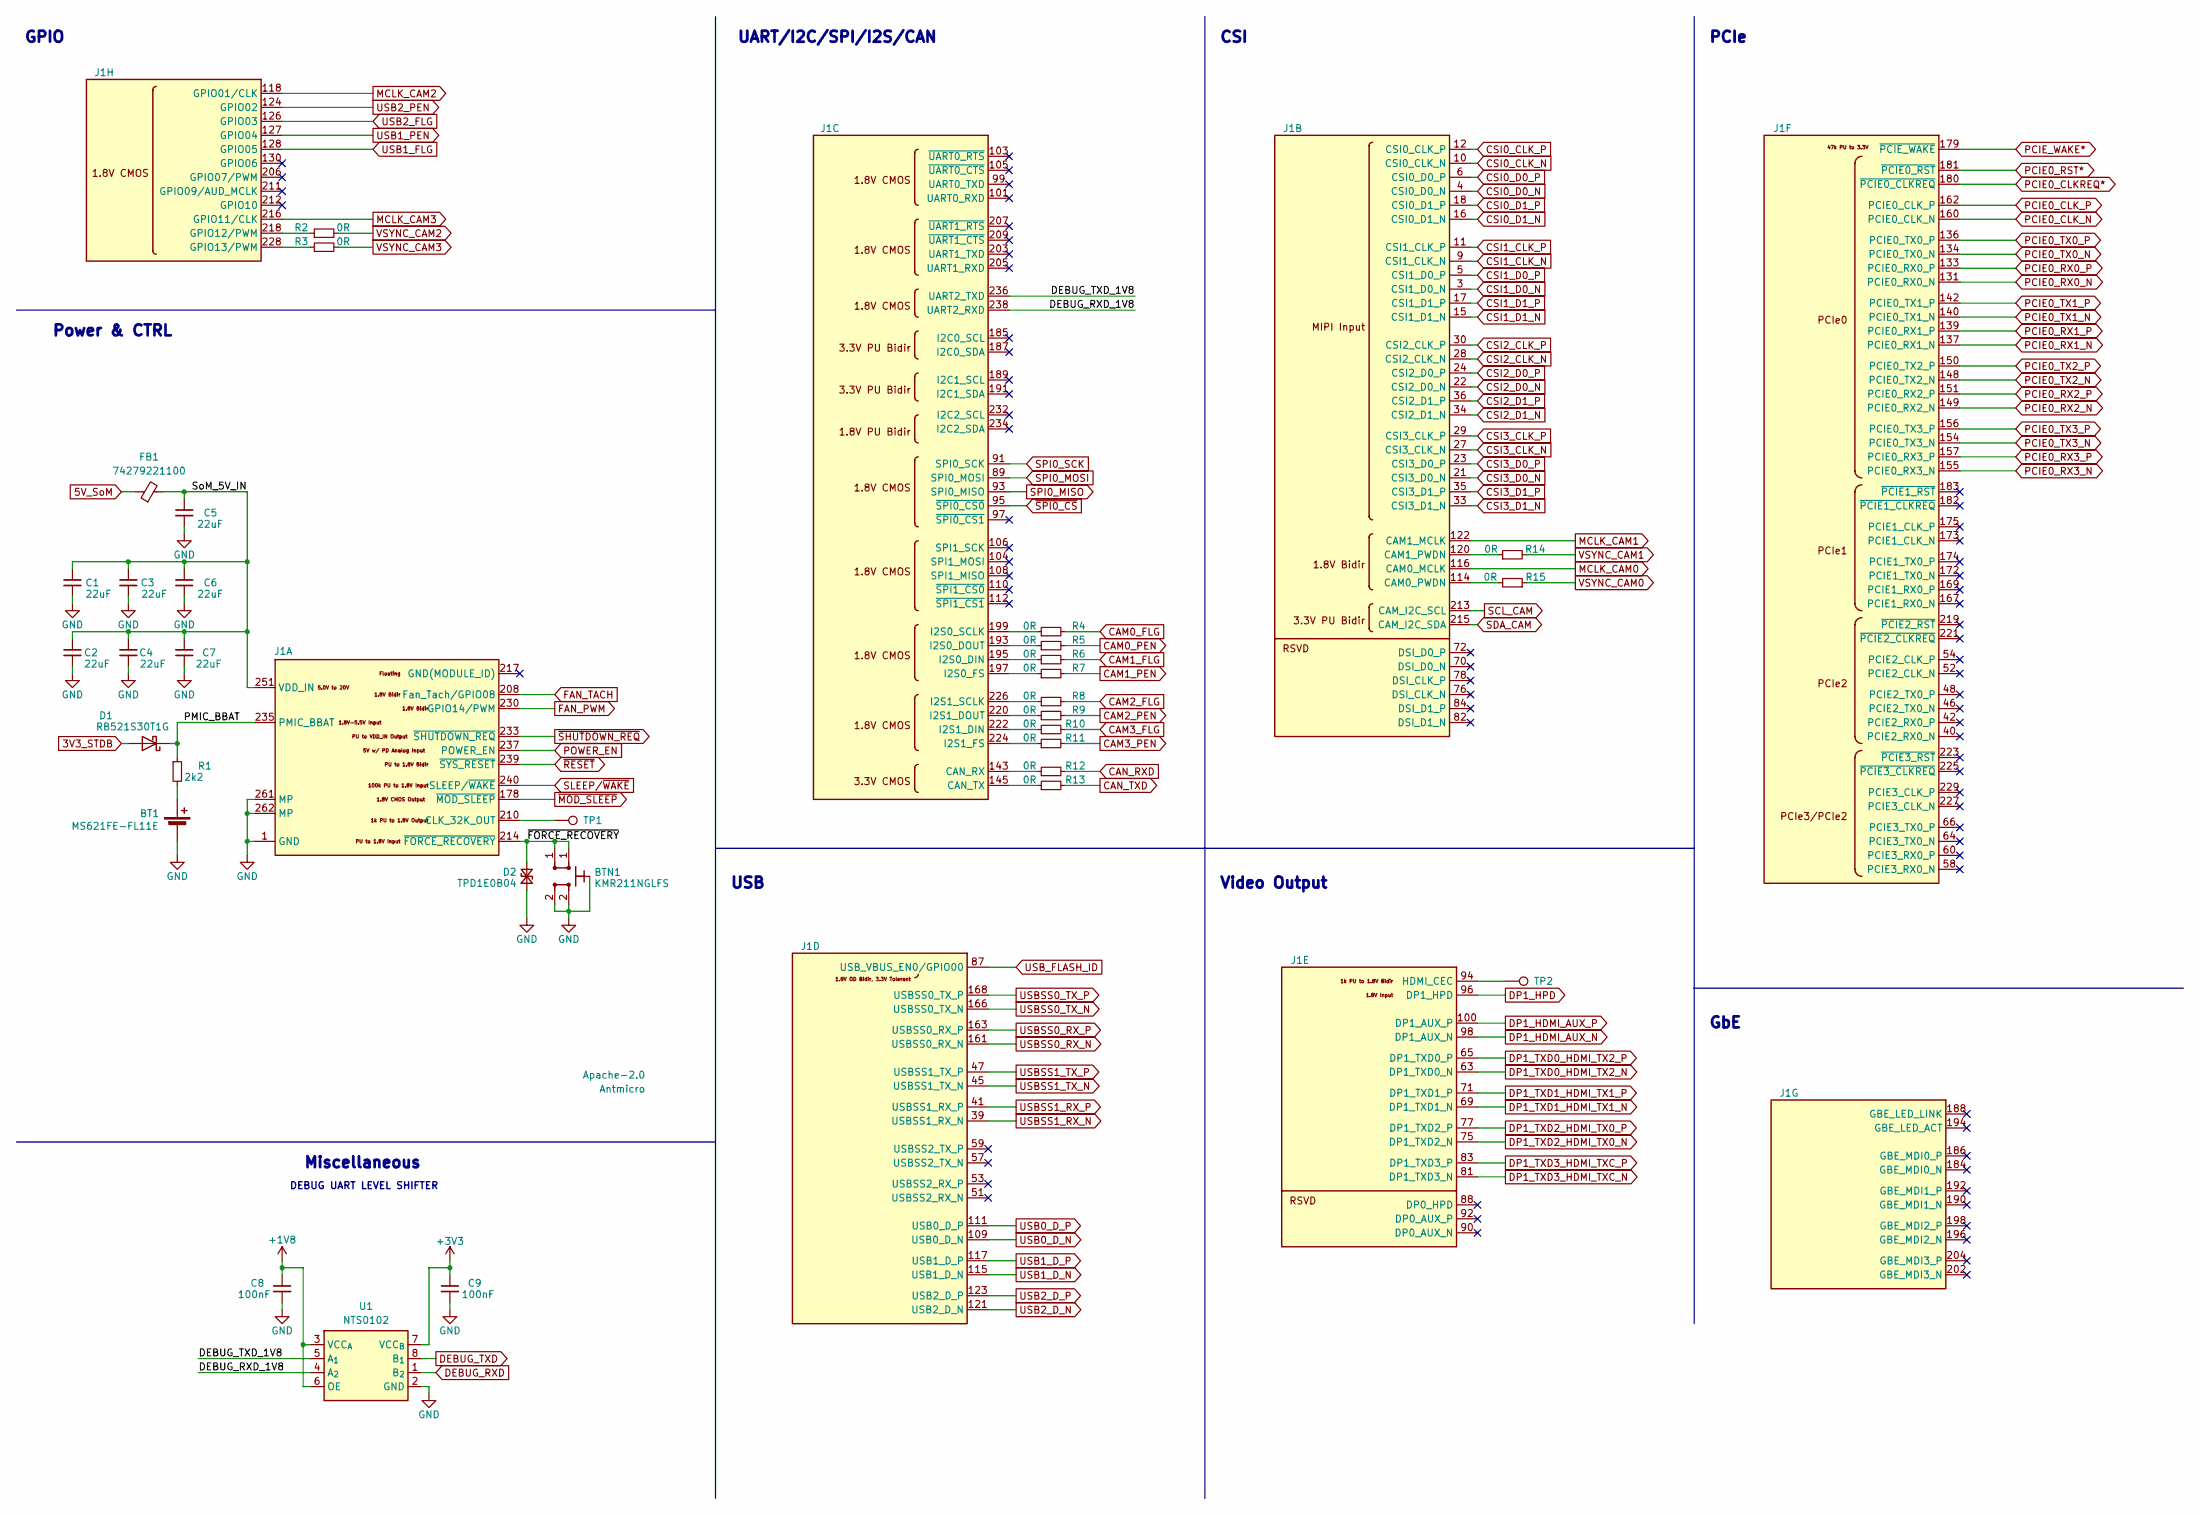
[picture p5: schematic som.kicad_sch, Argus Carrierboard]

Parts:
BT1: MS621FE-FL11E; MPN MS621FE-FL11E
BTN1: KMR211NGLFS; SW_Push_1P1T-SH_NO_CK_KMR2xxG; MPN C221676; LCSC C221676
C1, C2, C3, C4, C5, C6, C7: 22uF; C_0603_1608Metric; MPN C2762594; LCSC C84419
C8, C9: 100nF; C_0603_1608Metric; MPN C307348; LCSC C14663
D1: RB521S30T1G; D_SOD-523; MPN RB521S30T1G; LCSC C145179
D2: TPD1E0B04; Texas_DPY0002A_0.6x1mm_P0.65mm; MPN C1975594; LCSC C1975594
FB1: 74279221100; L_1206_3216Metric; MPN C5355985; LCSC C5355985
J1: Bus_DDR4_SODIMM_CUSTOM_Jetson-Orin-H9.2mm-socket; Jetson_Module_TE_2309409-1; MPN 2309413-1; LCSC C5164025
R1: 2k2; R_0603_1608Metric; MPN C2076947; LCSC C4190
R2, R3, R4, R5, R6, R7, R8, R9, R10, R11, R12, R13, R14, R15: 0R; R_0402_1005Metric; MPN C190119; LCSC C17168
TP1, TP2: TP_0.75mm_SMD; TestPoint_Pad_D1.0mm
U1: NTS0102; NXP_XSON-8; MPN NTS0102GT; LCSC C2687851

Connections:
3V3_STDB: D1.2 (A); also elsewhere on the board
5V_SoM: FB1.1; also elsewhere on the board
+1V8: C8.1, U1.3 (VCC_{A}), U1.6 (OE); also elsewhere on the board
+3V3: C9.1, U1.7 (VCC_{B}); also elsewhere on the board
/SoM/DEBUG_RXD_1V8: J1.238 (UART2_RXD), U1.4 (A_{2})
/SoM/DEBUG_TXD_1V8: J1.236 (UART2_TXD), U1.5 (A_{1})
/SoM/PMIC_BBAT: D1.1 (K), J1.235 (PMIC_BBAT), R1.1
/SoM/SoM_5V_IN: C1.1, C2.1, C3.1, C4.1, C5.1, C6.1, C7.1, FB1.2, J1.251 (VDD_IN), J1.252 (VDD_IN), J1.253 (VDD_IN), J1.254 (VDD_IN), J1.255 (VDD_IN), J1.256 (VDD_IN), J1.257 (VDD_IN), J1.258 (VDD_IN), J1.259 (VDD_IN), J1.260 (VDD_IN)
/SoM/~FORCE_RECOVERY: BTN1.1, D2.2 (A2), J1.214 (~FORCE_RECOVERY)
CAM0_FLG: R4.2; also elsewhere on the board
CAM0_PEN: R5.2; also elsewhere on the board
CAM1_FLG: R6.2; also elsewhere on the board
CAM1_PEN: R7.2; also elsewhere on the board
CAM2_FLG: R8.2; also elsewhere on the board
CAM2_PEN: R9.2; also elsewhere on the board
CAM3_FLG: R10.2; also elsewhere on the board
CAM3_PEN: R11.2; also elsewhere on the board
CAN_RXD: R12.2; also elsewhere on the board
CAN_TXD: R13.2; also elsewhere on the board
CSI0_CLK_N: J1.10 (CSI0_CLK_N); also elsewhere on the board
CSI0_CLK_P: J1.12 (CSI0_CLK_P); also elsewhere on the board
CSI0_D0_N: J1.4 (CSI0_D0_N); also elsewhere on the board
CSI0_D0_P: J1.6 (CSI0_D0_P); also elsewhere on the board
CSI0_D1_N: J1.16 (CSI0_D1_N); also elsewhere on the board
CSI0_D1_P: J1.18 (CSI0_D1_P); also elsewhere on the board
CSI1_CLK_N: J1.9 (CSI1_CLK_N); also elsewhere on the board
CSI1_CLK_P: J1.11 (CSI1_CLK_P); also elsewhere on the board
CSI1_D0_N: J1.3 (CSI1_D0_N); also elsewhere on the board
CSI1_D0_P: J1.5 (CSI1_D0_P); also elsewhere on the board
CSI1_D1_N: J1.15 (CSI1_D1_N); also elsewhere on the board
CSI1_D1_P: J1.17 (CSI1_D1_P); also elsewhere on the board
CSI2_CLK_N: J1.28 (CSI2_CLK_N); also elsewhere on the board
CSI2_CLK_P: J1.30 (CSI2_CLK_P); also elsewhere on the board
CSI2_D0_N: J1.22 (CSI2_D0_N); also elsewhere on the board
CSI2_D0_P: J1.24 (CSI2_D0_P); also elsewhere on the board
CSI2_D1_N: J1.34 (CSI2_D1_N); also elsewhere on the board
CSI2_D1_P: J1.36 (CSI2_D1_P); also elsewhere on the board
CSI3_CLK_N: J1.27 (CSI3_CLK_N); also elsewhere on the board
CSI3_CLK_P: J1.29 (CSI3_CLK_P); also elsewhere on the board
CSI3_D0_N: J1.21 (CSI3_D0_N); also elsewhere on the board
CSI3_D0_P: J1.23 (CSI3_D0_P); also elsewhere on the board
CSI3_D1_N: J1.33 (CSI3_D1_N); also elsewhere on the board
CSI3_D1_P: J1.35 (CSI3_D1_P); also elsewhere on the board
DEBUG_RXD: U1.1 (B_{2}); also elsewhere on the board
DEBUG_TXD: U1.8 (B_{1}); also elsewhere on the board
DP1_HDMI_AUX_N: J1.98 (DP1_AUX_N); also elsewhere on the board
DP1_HDMI_AUX_P: J1.100 (DP1_AUX_P); also elsewhere on the board
DP1_HPD: J1.96 (DP1_HPD); also elsewhere on the board
DP1_TXD0_HDMI_TX2_N: J1.63 (DP1_TXD0_N); also elsewhere on the board
DP1_TXD0_HDMI_TX2_P: J1.65 (DP1_TXD0_P); also elsewhere on the board
DP1_TXD1_HDMI_TX1_N: J1.69 (DP1_TXD1_N); also elsewhere on the board
DP1_TXD1_HDMI_TX1_P: J1.71 (DP1_TXD1_P); also elsewhere on the board
DP1_TXD2_HDMI_TX0_N: J1.75 (DP1_TXD2_N); also elsewhere on the board
DP1_TXD2_HDMI_TX0_P: J1.77 (DP1_TXD2_P); also elsewhere on the board
DP1_TXD3_HDMI_TXC_N: J1.81 (DP1_TXD3_N); also elsewhere on the board
DP1_TXD3_HDMI_TXC_P: J1.83 (DP1_TXD3_P); also elsewhere on the board
FAN_PWM: J1.230 (GPIO14/PWM); also elsewhere on the board
FAN_TACH: J1.208 (Fan_Tach/GPIO08); also elsewhere on the board
GND: BT1.2 (-), BTN1.2, BTN1.SH, C1.2, C2.2, C3.2, C4.2, C5.2, C6.2, C7.2, C8.2, C9.2, D2.1 (A1), J1.1 (GND), J1.2 (GND), J1.7 (GND), J1.8 (GND), J1.13 (GND), J1.14 (GND), J1.19 (GND), J1.20 (GND), J1.25 (GND), J1.26 (GND), J1.31 (GND), J1.32 (GND), J1.37 (GND), J1.38 (GND), J1.43 (GND), J1.44 (GND), J1.49 (GND), J1.50 (GND), J1.55 (GND), J1.56 (GND), J1.61 (GND), J1.62 (GND), J1.67 (GND), J1.68 (GND), J1.73 (GND), J1.74 (GND), J1.79 (GND), J1.80 (GND), J1.85 (GND), J1.86 (GND), J1.102 (GND), J1.107 (GND), J1.113 (GND), J1.119 (GND), J1.125 (GND), J1.129 (GND), J1.132 (GND), J1.135 (GND), J1.138 (GND), J1.141 (GND), J1.144 (GND), J1.146 (GND), J1.147 (GND), J1.152 (GND), J1.153 (GND), J1.158 (GND), J1.159 (GND), J1.164 (GND), J1.165 (GND), J1.170 (GND), J1.171 (GND), J1.176 (GND), J1.177 (GND), J1.200 (GND), J1.201 (GND), J1.231 (GND), J1.241 (GND), J1.242 (GND), J1.243 (GND), J1.244 (GND), J1.245 (GND), J1.246 (GND), J1.247 (GND), J1.248 (GND), J1.249 (GND), J1.250 (GND), J1.261 (MP), J1.262 (MP), U1.2 (GND); also elsewhere on the board
MCLK_CAM0: J1.116 (CAM0_MCLK); also elsewhere on the board
MCLK_CAM1: J1.122 (CAM1_MCLK); also elsewhere on the board
MCLK_CAM2: J1.118 (GPIO01/CLK); also elsewhere on the board
MCLK_CAM3: J1.216 (GPIO11/CLK); also elsewhere on the board
unnamed: BT1.1 (+), R1.2
unnamed: J1.210 (CLK_32K_OUT), TP1.1 (1_1)
unnamed: J1.114 (CAM0_PWDN), R15.2
unnamed: J1.120 (CAM1_PWDN), R14.1
unnamed: J1.143 (CAN_RX), R12.1
unnamed: J1.145 (CAN_TX), R13.1
unnamed: J1.195 (I2S0_DIN), R6.1
unnamed: J1.193 (I2S0_DOUT), R5.1
unnamed: J1.197 (I2S0_FS), R7.1
unnamed: J1.199 (I2S0_SCLK), R4.1
unnamed: J1.222 (I2S1_DIN), R10.1
unnamed: J1.220 (I2S1_DOUT), R9.1
unnamed: J1.224 (I2S1_FS), R11.1
unnamed: J1.226 (I2S1_SCLK), R8.1
unnamed: J1.94 (HDMI_CEC), TP2.1 (1_1)
unnamed: J1.218 (GPIO12/PWM), R2.1
unnamed: J1.228 (GPIO13/PWM), R3.1
PCIE0_CLKREQ*: J1.180 (~PCIE0_CLKREQ); also elsewhere on the board
PCIE0_CLK_N: J1.160 (PCIE0_CLK_N); also elsewhere on the board
PCIE0_CLK_P: J1.162 (PCIE0_CLK_P); also elsewhere on the board
PCIE0_RST*: J1.181 (~PCIE0_RST); also elsewhere on the board
PCIE0_RX0_N: J1.131 (PCIE0_RX0_N); also elsewhere on the board
PCIE0_RX0_P: J1.133 (PCIE0_RX0_P); also elsewhere on the board
PCIE0_RX1_N: J1.137 (PCIE0_RX1_N); also elsewhere on the board
PCIE0_RX1_P: J1.139 (PCIE0_RX1_P); also elsewhere on the board
PCIE0_RX2_N: J1.149 (PCIE0_RX2_N); also elsewhere on the board
PCIE0_RX2_P: J1.151 (PCIE0_RX2_P); also elsewhere on the board
PCIE0_RX3_N: J1.155 (PCIE0_RX3_N); also elsewhere on the board
PCIE0_RX3_P: J1.157 (PCIE0_RX3_P); also elsewhere on the board
PCIE0_TX0_N: J1.134 (PCIE0_TX0_N); also elsewhere on the board
PCIE0_TX0_P: J1.136 (PCIE0_TX0_P); also elsewhere on the board
PCIE0_TX1_N: J1.140 (PCIE0_TX1_N); also elsewhere on the board
PCIE0_TX1_P: J1.142 (PCIE0_TX1_P); also elsewhere on the board
PCIE0_TX2_N: J1.148 (PCIE0_TX2_N); also elsewhere on the board
PCIE0_TX2_P: J1.150 (PCIE0_TX2_P); also elsewhere on the board
PCIE0_TX3_N: J1.154 (PCIE0_TX3_N); also elsewhere on the board
PCIE0_TX3_P: J1.156 (PCIE0_TX3_P); also elsewhere on the board
PCIE_WAKE*: J1.179 (~PCIE_WAKE); also elsewhere on the board
POWER_EN: J1.237 (POWER_EN); also elsewhere on the board
SCL_CAM: J1.213 (CAM_I2C_SCL); also elsewhere on the board
SDA_CAM: J1.215 (CAM_I2C_SDA); also elsewhere on the board
SLEEP/~WAKE: J1.240 (SLEEP/~WAKE); also elsewhere on the board
SPI0_MISO: J1.93 (SPI0_MISO); also elsewhere on the board
SPI0_MOSI: J1.89 (SPI0_MOSI); also elsewhere on the board
SPI0_SCK: J1.91 (SPI0_SCK); also elsewhere on the board
USB0_D_N: J1.109 (USB0_D_N); also elsewhere on the board
USB0_D_P: J1.111 (USB0_D_P); also elsewhere on the board
USB1_D_N: J1.115 (USB1_D_N); also elsewhere on the board
USB1_D_P: J1.117 (USB1_D_P); also elsewhere on the board
USB1_FLG: J1.128 (GPIO05); also elsewhere on the board
USB1_PEN: J1.127 (GPIO04); also elsewhere on the board
USB2_D_N: J1.121 (USB2_D_N); also elsewhere on the board
USB2_D_P: J1.123 (USB2_D_P); also elsewhere on the board
USB2_FLG: J1.126 (GPIO03); also elsewhere on the board
USB2_PEN: J1.124 (GPIO02); also elsewhere on the board
USBSS0_RX_N: J1.161 (USBSS0_RX_N); also elsewhere on the board
USBSS0_RX_P: J1.163 (USBSS0_RX_P); also elsewhere on the board
USBSS0_TX_N: J1.166 (USBSS0_TX_N); also elsewhere on the board
USBSS0_TX_P: J1.168 (USBSS0_TX_P); also elsewhere on the board
USBSS1_RX_N: J1.39 (USBSS1_RX_N); also elsewhere on the board
USBSS1_RX_P: J1.41 (USBSS1_RX_P); also elsewhere on the board
USBSS1_TX_N: J1.45 (USBSS1_TX_N); also elsewhere on the board
USBSS1_TX_P: J1.47 (USBSS1_TX_P); also elsewhere on the board
USB_FLASH_ID: J1.87 (USB_VBUS_EN0/GPIO00); also elsewhere on the board
VSYNC_CAM0: R15.1; also elsewhere on the board
VSYNC_CAM1: R14.2; also elsewhere on the board
VSYNC_CAM2: R2.2; also elsewhere on the board
VSYNC_CAM3: R3.2; also elsewhere on the board
~MOD_SLEEP: J1.178 (~MOD_SLEEP); also elsewhere on the board
~RESET: J1.239 (~SYS_RESET); also elsewhere on the board
~SHUTDOWN_REQ: J1.233 (~SHUTDOWN_REQ); also elsewhere on the board
~SPI0_CS: J1.95 (~SPI0_CS0); also elsewhere on the board

Notes on the sheet:
DEBUG UART LEVEL SHIFTER
CSI
Video Output
Power & CTRL
UART/I2C/SPI/I2S/CAN
PCIe
GbE
USB
GPIO
Miscellaneous

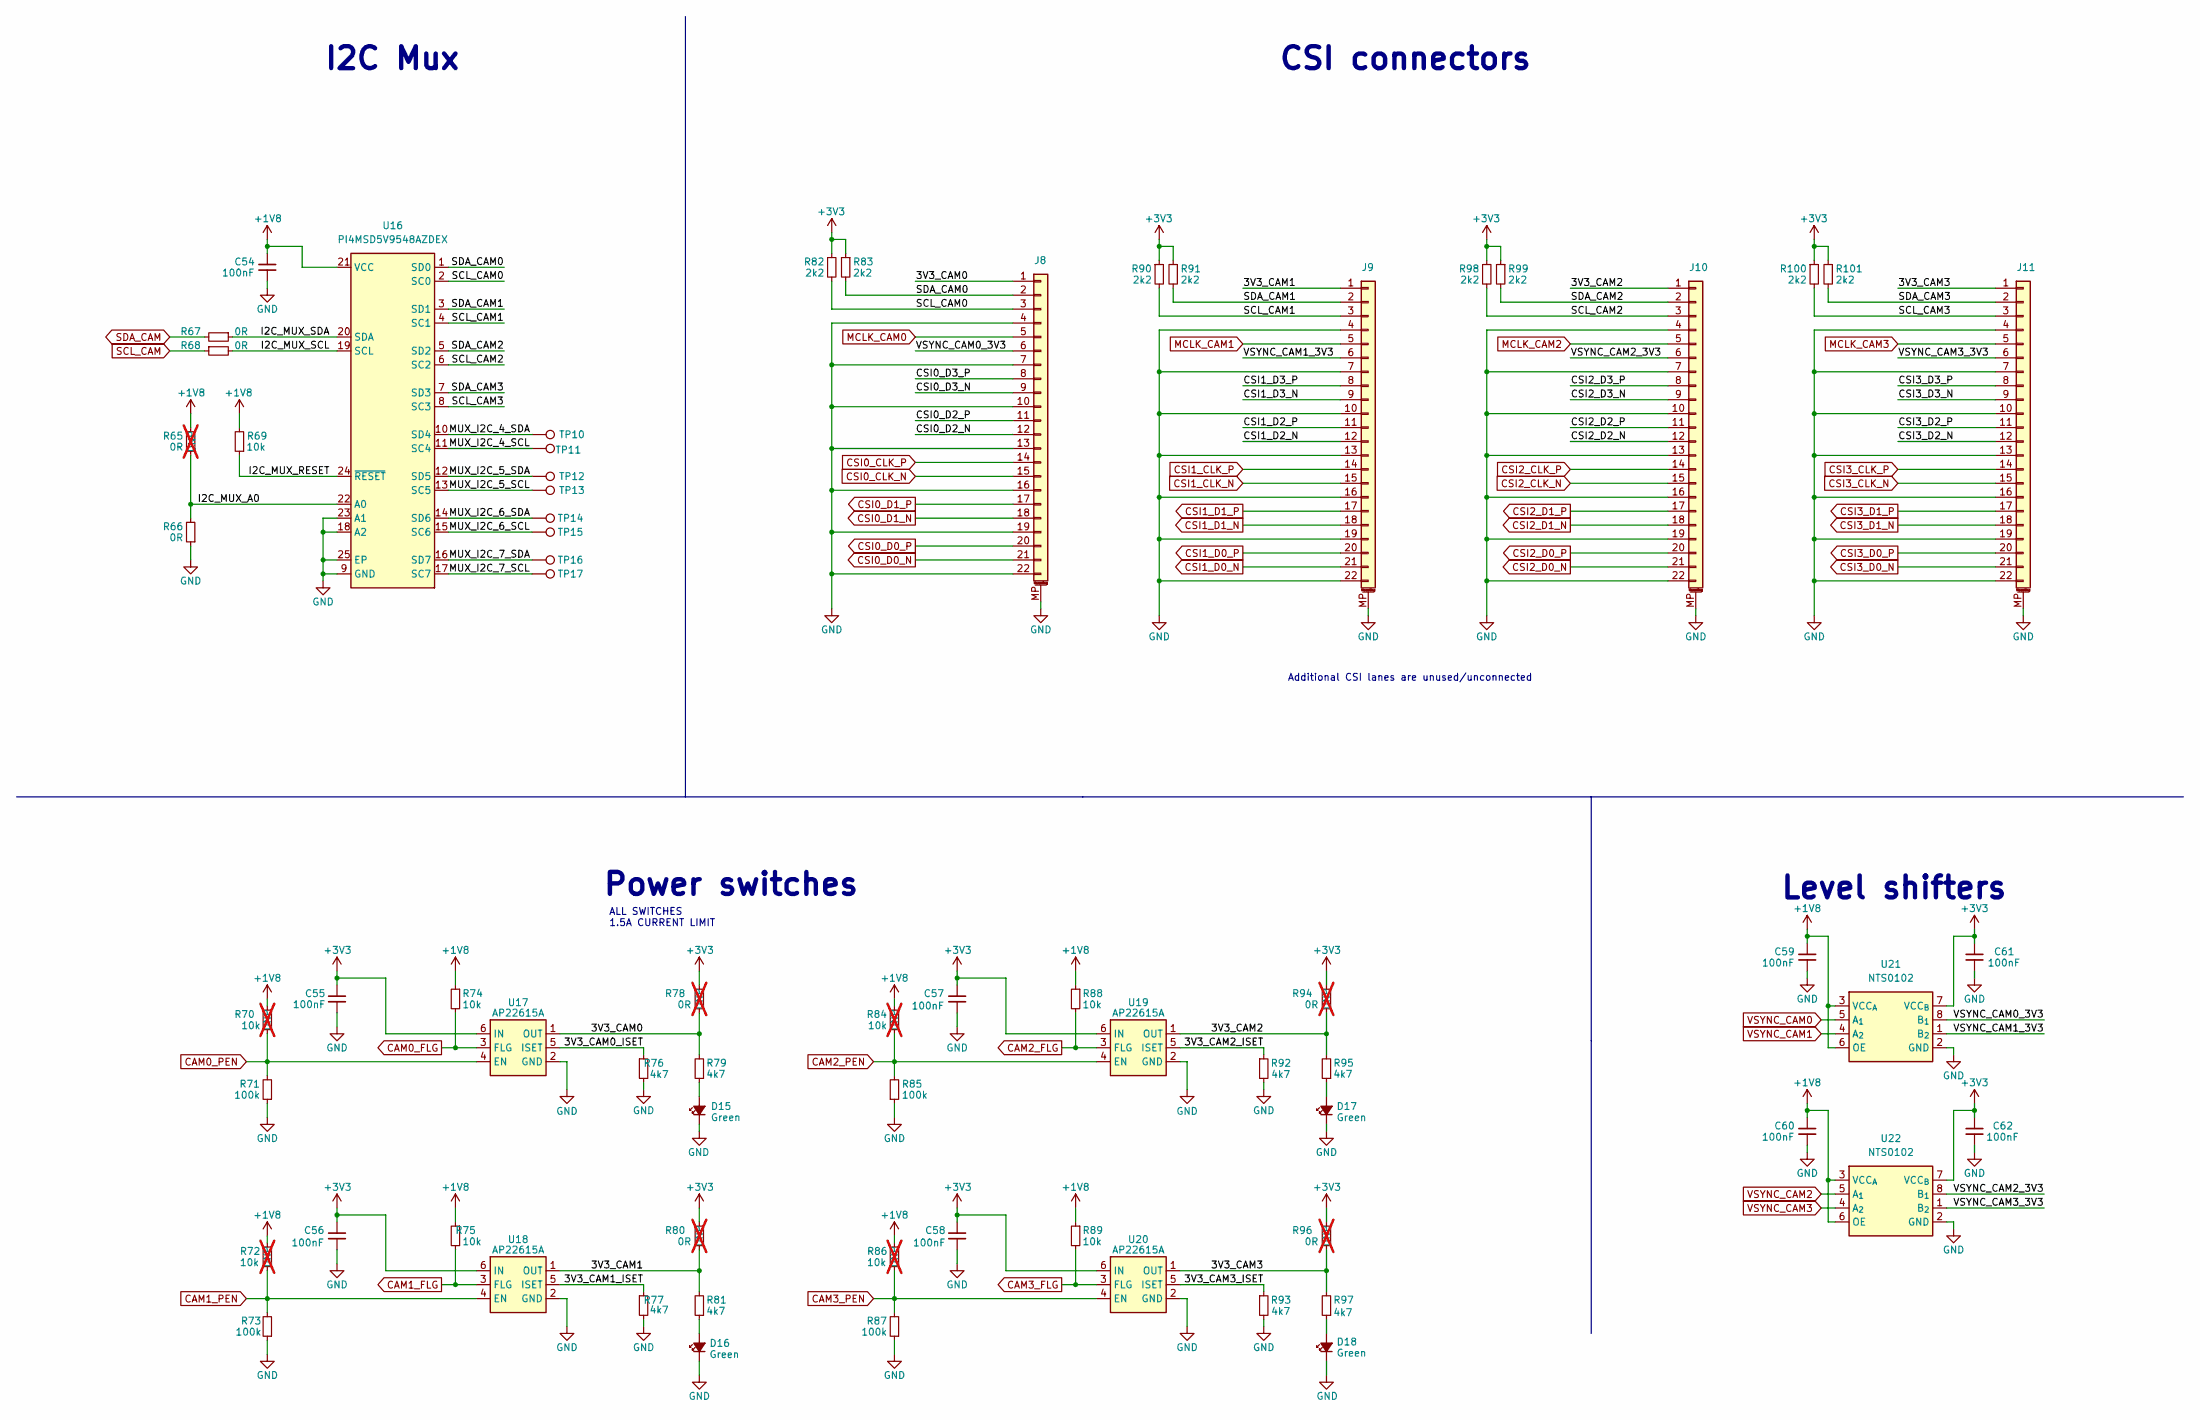
[picture p6: schematic csi.kicad_sch, Argus Carrierboard]

Parts:
C54, C55, C56, C57, C58, C59, C60, C61, C62: 100nF; C_0603_1608Metric; MPN C307348; LCSC C14663
D15, D16, D17, D18: LED_G_0603_LTST-C190GKT; LED_0603_1608Metric; MPN C2909774; LCSC C12065
J8, J9, J10, J11: Conn_01x22_MountingPin; Amphenol_F32Q-1A7x1-11022_1x22-1MP_P0.5mm_Horizontal
R65: 0R; R_0402_1005Metric; MPN ERJ2GE0R00X; LCSC C17168; not fitted
R66, R67, R68: 0R; R_0402_1005Metric; MPN C190119; LCSC C17168
R69, R74, R75, R88, R89: 10k; R_0603_1608Metric; MPN C2479067; LCSC C25804
R70, R72, R84, R86: 10k; R_0603_1608Metric; Tolerance 1%; MPN CR0402-FX-1002GLF; LCSC C25804; not fitted
R71, R73, R85, R87: 100k; R_0603_1608Metric; MPN C237792; LCSC C25803
R76, R77, R79, R81, R92, R93, R95, R97: 4k7; R_0603_1608Metric; MPN C844931; LCSC C23162
R78, R80, R94, R96: 0R; R_0603_1608Metric; Tolerance 1%; MPN CR0402-FX-1002GLF; LCSC C21189; not fitted
R82, R83, R90, R91, R98, R99, R100, R101: 2k2; R_0603_1608Metric; MPN C2076947; LCSC C4190
TP10, TP11, TP12, TP13, TP14, TP15, TP16, TP17: TP_0.75mm_SMD; TestPoint_Pad_D1.0mm
U16: PI4MSD5V9548AZDEX; TQFN-24-1EP_4x4mm_P0.5mm_EP2.3x2.3mm; MPN PI4MSD5V9548AZDEX; LCSC C2674581
U17, U18, U19, U20: AP22615A; TSOT-23-6; MPN C2680357; LCSC C2680357
U21, U22: NTS0102; NXP_XSON-8; MPN NTS0102GT; LCSC C2687851

Connections:
+1V8: C54.2, C59.1, C60.1, R65.2, R69.2, R70.1, R72.1, R74.1, R75.1, R84.1, R86.1, R88.1, R89.1, U16.21 (VCC), U21.3 (VCC_{A}), U21.6 (OE), U22.3 (VCC_{A}), U22.6 (OE); also elsewhere on the board
+3V3: C55.2, C56.2, C57.2, C58.2, C61.1, C62.1, R78.1, R80.1, R82.1, R83.1, R90.1, R91.1, R94.1, R96.1, R98.1, R99.1, R100.1, R101.1, U17.6 (IN), U18.6 (IN), U19.6 (IN), U20.6 (IN), U21.7 (VCC_{B}), U22.7 (VCC_{B}); also elsewhere on the board
/CSI/3V3_CAM0: J8.1, R78.2, R79.2, U17.1 (OUT)
/CSI/3V3_CAM0_ISET: R76.1, U17.5 (ISET)
/CSI/3V3_CAM1: J9.1, R80.2, R81.2, U18.1 (OUT)
/CSI/3V3_CAM1_ISET: R77.1, U18.5 (ISET)
/CSI/3V3_CAM2: J10.1, R94.2, R95.2, U19.1 (OUT)
/CSI/3V3_CAM2_ISET: R92.1, U19.5 (ISET)
/CSI/3V3_CAM3: J11.1, R96.2, R97.2, U20.1 (OUT)
/CSI/3V3_CAM3_ISET: R93.1, U20.5 (ISET)
/CSI/CSI0_D2_N: J8.12
/CSI/CSI0_D2_P: J8.11
/CSI/CSI0_D3_N: J8.9
/CSI/CSI0_D3_P: J8.8
/CSI/CSI1_D2_N: J9.12
/CSI/CSI1_D2_P: J9.11
/CSI/CSI1_D3_N: J9.9
/CSI/CSI1_D3_P: J9.8
/CSI/CSI2_D2_N: J10.12
/CSI/CSI2_D2_P: J10.11
/CSI/CSI2_D3_N: J10.9
/CSI/CSI2_D3_P: J10.8
/CSI/CSI3_D2_N: J11.12
/CSI/CSI3_D2_P: J11.11
/CSI/CSI3_D3_N: J11.9
/CSI/CSI3_D3_P: J11.8
/CSI/I2C_MUX_A0: R65.1, R66.2, U16.22 (A0)
/CSI/I2C_MUX_RESET: R69.1, U16.24 (~RESET)
/CSI/I2C_MUX_SCL: R68.2, U16.19 (SCL)
/CSI/I2C_MUX_SDA: R67.1, U16.20 (SDA)
/CSI/MUX_I2C_4_SCL: TP11.1 (1_1), U16.11 (SC4)
/CSI/MUX_I2C_4_SDA: TP10.1 (1_1), U16.10 (SD4)
/CSI/MUX_I2C_5_SCL: TP13.1 (1_1), U16.13 (SC5)
/CSI/MUX_I2C_5_SDA: TP12.1 (1_1), U16.12 (SD5)
/CSI/MUX_I2C_6_SCL: TP15.1 (1_1), U16.15 (SC6)
/CSI/MUX_I2C_6_SDA: TP14.1 (1_1), U16.14 (SD6)
/CSI/MUX_I2C_7_SCL: TP17.1 (1_1), U16.17 (SC7)
/CSI/MUX_I2C_7_SDA: TP16.1 (1_1), U16.16 (SD7)
/CSI/SCL_CAM0: J8.3, R82.2, U16.2 (SC0)
/CSI/SCL_CAM1: J9.3, R90.2, U16.4 (SC1)
/CSI/SCL_CAM2: J10.3, R98.2, U16.6 (SC2)
/CSI/SCL_CAM3: J11.3, R100.2, U16.8 (SC3)
/CSI/SDA_CAM0: J8.2, R83.2, U16.1 (SD0)
/CSI/SDA_CAM1: J9.2, R91.2, U16.3 (SD1)
/CSI/SDA_CAM2: J10.2, R99.2, U16.5 (SD2)
/CSI/SDA_CAM3: J11.2, R101.2, U16.7 (SD3)
/CSI/VSYNC_CAM0_3V3: J8.6, U21.8 (B_{1})
/CSI/VSYNC_CAM1_3V3: J9.6, U21.1 (B_{2})
/CSI/VSYNC_CAM2_3V3: J10.6, U22.8 (B_{1})
/CSI/VSYNC_CAM3_3V3: J11.6, U22.1 (B_{2})
CAM0_FLG: R74.2, U17.3 (FLG); also elsewhere on the board
CAM0_PEN: R70.2, R71.2, U17.4 (EN); also elsewhere on the board
CAM1_FLG: R75.2, U18.3 (FLG); also elsewhere on the board
CAM1_PEN: R72.2, R73.2, U18.4 (EN); also elsewhere on the board
CAM2_FLG: R88.2, U19.3 (FLG); also elsewhere on the board
CAM2_PEN: R84.2, R85.2, U19.4 (EN); also elsewhere on the board
CAM3_FLG: R89.2, U20.3 (FLG); also elsewhere on the board
CAM3_PEN: R86.2, R87.2, U20.4 (EN); also elsewhere on the board
CSI0_CLK_N: J8.15; also elsewhere on the board
CSI0_CLK_P: J8.14; also elsewhere on the board
CSI0_D0_N: J8.21; also elsewhere on the board
CSI0_D0_P: J8.20; also elsewhere on the board
CSI0_D1_N: J8.18; also elsewhere on the board
CSI0_D1_P: J8.17; also elsewhere on the board
CSI1_CLK_N: J9.15; also elsewhere on the board
CSI1_CLK_P: J9.14; also elsewhere on the board
CSI1_D0_N: J9.21; also elsewhere on the board
CSI1_D0_P: J9.20; also elsewhere on the board
CSI1_D1_N: J9.18; also elsewhere on the board
CSI1_D1_P: J9.17; also elsewhere on the board
CSI2_CLK_N: J10.15; also elsewhere on the board
CSI2_CLK_P: J10.14; also elsewhere on the board
CSI2_D0_N: J10.21; also elsewhere on the board
CSI2_D0_P: J10.20; also elsewhere on the board
CSI2_D1_N: J10.18; also elsewhere on the board
CSI2_D1_P: J10.17; also elsewhere on the board
CSI3_CLK_N: J11.15; also elsewhere on the board
CSI3_CLK_P: J11.14; also elsewhere on the board
CSI3_D0_N: J11.21; also elsewhere on the board
CSI3_D0_P: J11.20; also elsewhere on the board
CSI3_D1_N: J11.18; also elsewhere on the board
CSI3_D1_P: J11.17; also elsewhere on the board
GND: C54.1, C55.1, C56.1, C57.1, C58.1, C59.2, C60.2, C61.2, C62.2, D15.1 (K), D16.1 (K), D17.1 (K), D18.1 (K), J8.4, J8.7, J8.10, J8.13, J8.16, J8.19, J8.22, J8.MP (MountPin), J9.4, J9.7, J9.10, J9.13, J9.16, J9.19, J9.22, J9.MP (MountPin), J10.4, J10.7, J10.10, J10.13, J10.16, J10.19, J10.22, J10.MP (MountPin), J11.4, J11.7, J11.10, J11.13, J11.16, J11.19, J11.22, J11.MP (MountPin), R66.1, R71.1, R73.1, R76.2, R77.2, R85.1, R87.1, R92.2, R93.2, U16.9 (GND), U16.18 (A2), U16.23 (A1), U16.25 (EP), U17.2 (GND), U18.2 (GND), U19.2 (GND), U20.2 (GND), U21.2 (GND), U22.2 (GND); also elsewhere on the board
MCLK_CAM0: J8.5; also elsewhere on the board
MCLK_CAM1: J9.5; also elsewhere on the board
MCLK_CAM2: J10.5; also elsewhere on the board
MCLK_CAM3: J11.5; also elsewhere on the board
unnamed: D15.2 (A), R79.1
unnamed: D16.2 (A), R81.1
unnamed: D17.2 (A), R95.1
unnamed: D18.2 (A), R97.1
SCL_CAM: R68.1; also elsewhere on the board
SDA_CAM: R67.2; also elsewhere on the board
VSYNC_CAM0: U21.5 (A_{1}); also elsewhere on the board
VSYNC_CAM1: U21.4 (A_{2}); also elsewhere on the board
VSYNC_CAM2: U22.5 (A_{1}); also elsewhere on the board
VSYNC_CAM3: U22.4 (A_{2}); also elsewhere on the board

Notes on the sheet:
Power switches
CSI connectors
Additional CSI lanes are unused/unconnected
I2C Mux
ALL SWITCHES 1.5A CURRENT LIMIT
Level shifters

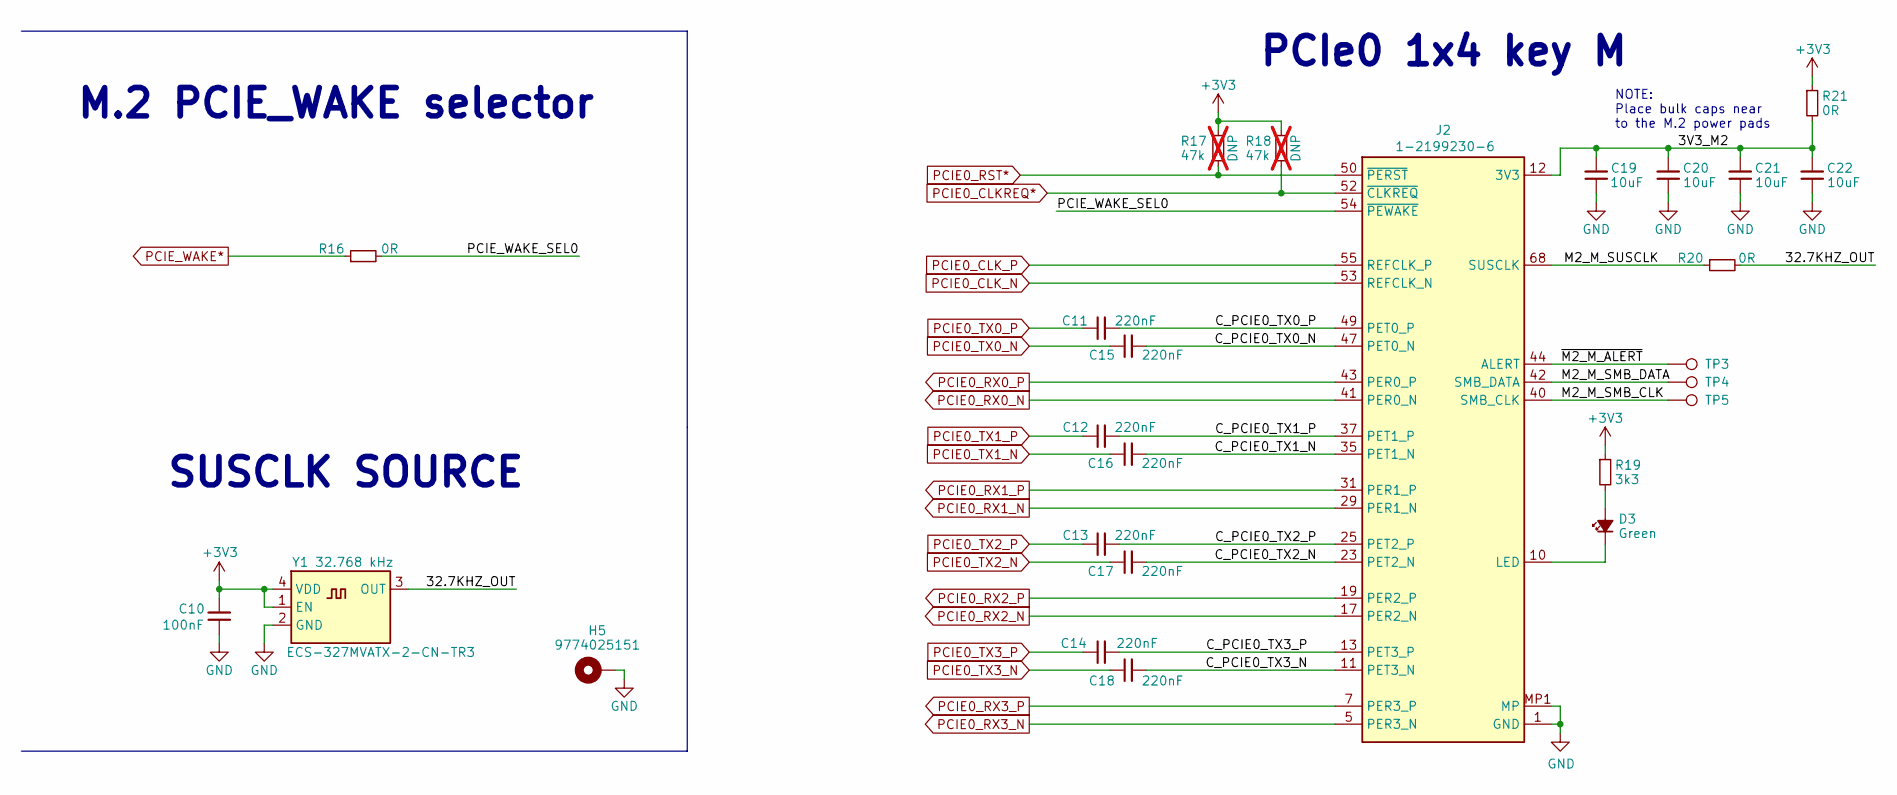
[picture p7: schematic m-2.kicad_sch, Argus Carrierboard]

Parts:
C10: 100nF; C_0603_1608Metric; MPN C307348; LCSC C14663
C11, C12, C13, C14, C15, C16, C17, C18: 220nF; C_0402_1005Metric; MPN C126623; LCSC C16772
C19, C20, C21, C22: 10uF; C_0603_1608Metric; MPN C697423; LCSC C96446
D3: LED_G_0603_LTST-C190GKT; LED_0603_1608Metric; MPN C2909774; LCSC C12065
H5: 9774025151; MountingHole_2.7mm_M2.5_DIN965_Pad_TopBottom; MPN 9774025151R
J2: 1-2199230-6; Bus_M.2_Socket_Key_M_TE_1-2199230-6; MPN C4710843; LCSC C4710843
R16, R20: 0R; R_0402_1005Metric; MPN C190119; LCSC C17168
R17, R18: 47k; R_0402_1005Metric; Tolerance 1%; MPN CR0402-FX-4702GLF; LCSC C25792; not fitted
R19: 3k3; R_0603_1608Metric; MPN C844928; LCSC C22978
R21: 0R; R_0603_1608Metric; MPN C844915; LCSC C21189
TP3, TP4, TP5: TP_0.75mm_SMD; TestPoint_Pad_D1.0mm
Y1: ECS-327MVATX-2-CN-TR3; Oscillator_SMD_ECS_2520MV_2.5x2mm; MPN ECS-327MVATX-2-CN-TR3; LCSC C5375606

Connections:
+3V3: C10.2, R17.1, R18.1, R19.1, R21.1, Y1.1 (EN), Y1.4 (VDD); also elsewhere on the board
/M.2/3V3_M2: C19.1, C20.1, C21.1, C22.1, J2.2 (3V3), J2.4 (3V3), J2.12 (3V3), J2.14 (3V3), J2.16 (3V3), J2.18 (3V3), J2.70 (3V3), J2.72 (3V3), J2.74 (3V3), R21.2
/M.2/32.7KHZ_OUT: R20.2, Y1.3 (OUT)
/M.2/C_PCIE0_TX0_N: C15.2, J2.47 (PET0_N)
/M.2/C_PCIE0_TX0_P: C11.2, J2.49 (PET0_P)
/M.2/C_PCIE0_TX1_N: C16.1, J2.35 (PET1_N)
/M.2/C_PCIE0_TX1_P: C12.1, J2.37 (PET1_P)
/M.2/C_PCIE0_TX2_N: C17.1, J2.23 (PET2_N)
/M.2/C_PCIE0_TX2_P: C13.1, J2.25 (PET2_P)
/M.2/C_PCIE0_TX3_N: C18.2, J2.11 (PET3_N)
/M.2/C_PCIE0_TX3_P: C14.1, J2.13 (PET3_P)
/M.2/M2_M_SMB_CLK: J2.40 (SMB_CLK), TP5.1 (1_1)
/M.2/M2_M_SMB_DATA: J2.42 (SMB_DATA), TP4.1 (1_1)
/M.2/M2_M_SUSCLK: J2.68 (SUSCLK), R20.1
/M.2/PCIE_WAKE_SEL0: J2.54 (~PEWAKE), R16.2
/M.2/~M2_M_ALERT: J2.44 (ALERT), TP3.1 (1_1)
GND: C10.1, C19.2, C20.2, C21.2, C22.2, H5.1 (1_1), J2.1 (GND), J2.3 (GND), J2.9 (GND), J2.15 (GND), J2.21 (GND), J2.27 (GND), J2.33 (GND), J2.39 (GND), J2.45 (GND), J2.51 (GND), J2.57 (GND), J2.71 (GND), J2.73 (GND), J2.75 (GND), J2.MP1 (MP), J2.MP2 (MP), Y1.2 (GND); also elsewhere on the board
unnamed: D3.2 (A), R19.2
unnamed: D3.1 (K), J2.10 (LED)
PCIE0_CLKREQ*: J2.52 (~CLKREQ), R18.2; also elsewhere on the board
PCIE0_CLK_N: J2.53 (REFCLK_N); also elsewhere on the board
PCIE0_CLK_P: J2.55 (REFCLK_P); also elsewhere on the board
PCIE0_RST*: J2.50 (~PERST), R17.2; also elsewhere on the board
PCIE0_RX0_N: J2.41 (PER0_N); also elsewhere on the board
PCIE0_RX0_P: J2.43 (PER0_P); also elsewhere on the board
PCIE0_RX1_N: J2.29 (PER1_N); also elsewhere on the board
PCIE0_RX1_P: J2.31 (PER1_P); also elsewhere on the board
PCIE0_RX2_N: J2.17 (PER2_N); also elsewhere on the board
PCIE0_RX2_P: J2.19 (PER2_P); also elsewhere on the board
PCIE0_RX3_N: J2.5 (PER3_N); also elsewhere on the board
PCIE0_RX3_P: J2.7 (PER3_P); also elsewhere on the board
PCIE0_TX0_N: C15.1; also elsewhere on the board
PCIE0_TX0_P: C11.1; also elsewhere on the board
PCIE0_TX1_N: C16.2; also elsewhere on the board
PCIE0_TX1_P: C12.2; also elsewhere on the board
PCIE0_TX2_N: C17.2; also elsewhere on the board
PCIE0_TX2_P: C13.2; also elsewhere on the board
PCIE0_TX3_N: C18.1; also elsewhere on the board
PCIE0_TX3_P: C14.2; also elsewhere on the board
PCIE_WAKE*: R16.1; also elsewhere on the board

Notes on the sheet:
M.2 PCIE_WAKE selector
PCIe0 1x4 key M
NOTE: Place bulk caps near to the M.2 power pads
SUSCLK SOURCE
