cmu-argus-2/Avionics-JetsonCarrier/jetson-orin-baseboard.kicad_pcb

## KiCad design jetson-orin-baseboard.kicad_pcb (continued)

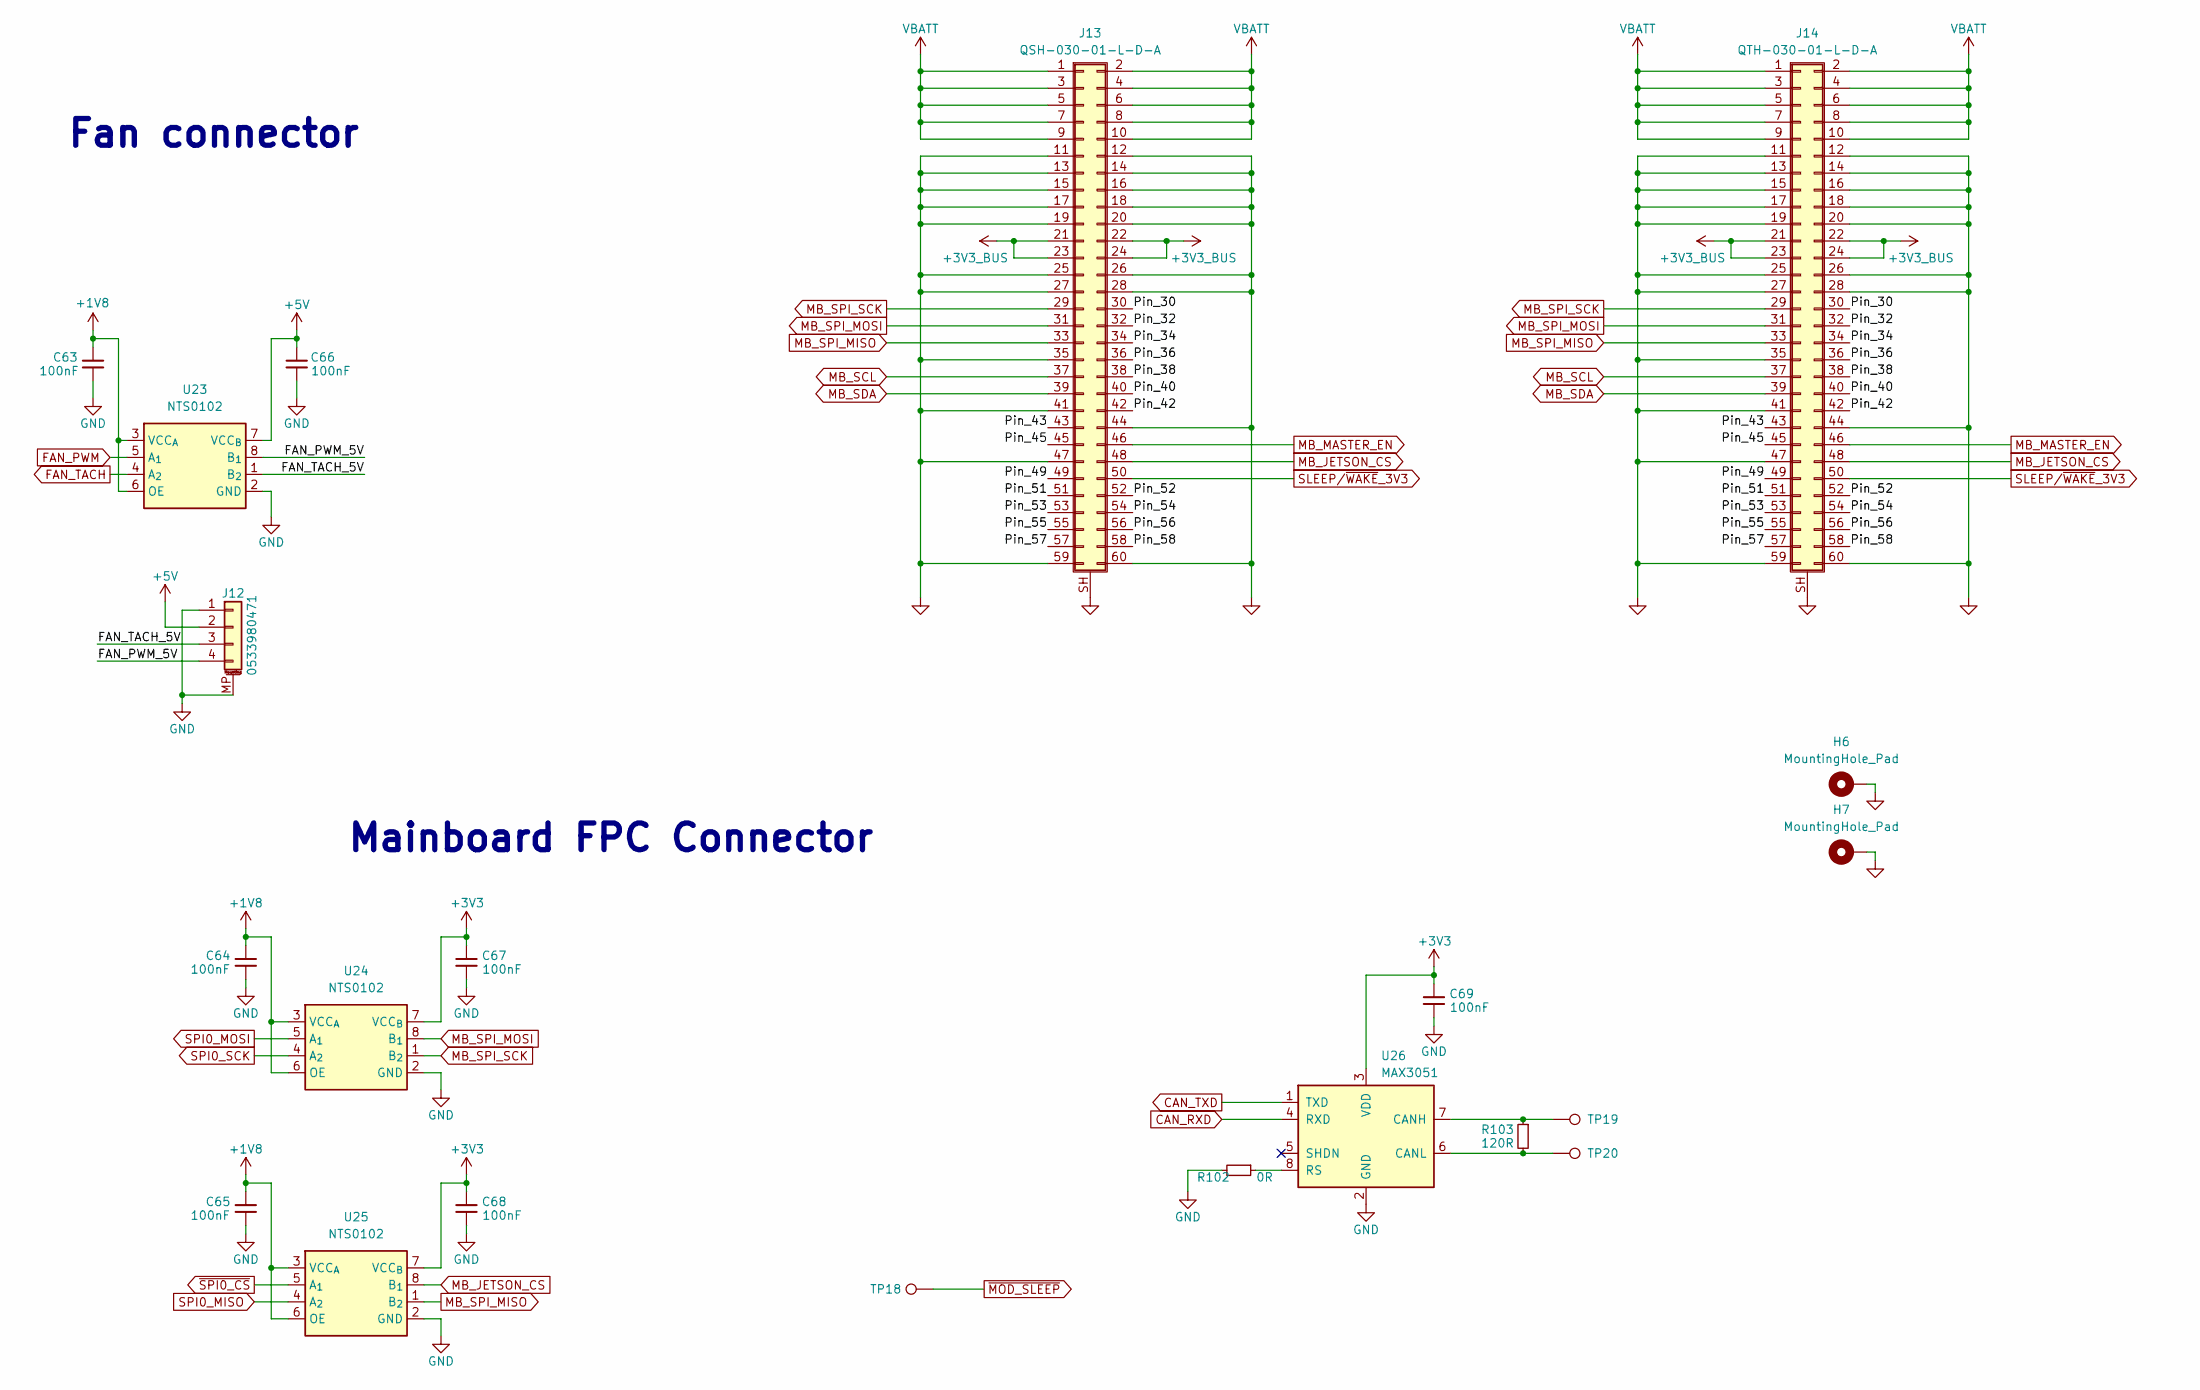
[picture p8: schematic peripherals.kicad_sch, Argus Carrierboard]

Parts:
C63, C64, C65, C66, C67, C68, C69: 100nF; C_0603_1608Metric; MPN C307348; LCSC C14663
H6, H7: MountingHole_Pad; MountingHole_2.5mm_Pad_Via
J12: 0533980471; Molex_PicoBlade_53398-0471_1x04-1MP_P1.25mm_Vertical; MPN C225106; LCSC C17617036
J13: QSH-030-01-L-D-A; SAMTEC_QSH-030-01-L-D-A; LCSC C2909821
J14: QTH-030-01-L-D-A; SAMTEC-QTH-030-01-X-D-A; LCSC C2843756
R102: 0R; R_0603_1608Metric; MPN C190119; LCSC C21189
R103: 120R; R_0603_1608Metric; MPN C71617; LCSC C22787
TP18, TP19, TP20: TP_0.75mm_SMD; TestPoint_Pad_D1.0mm
U23, U24, U25: NTS0102; NXP_XSON-8; MPN NTS0102GT; LCSC C2687851
U26: MAX3051; SOT-23-8; LCSC C112005

Connections:
+1V8: C63.1, C64.1, C65.1, U23.3 (VCC_{A}), U23.6 (OE), U24.3 (VCC_{A}), U24.6 (OE), U25.3 (VCC_{A}), U25.6 (OE); also elsewhere on the board
+3V3: C67.1, C68.1, C69.1, U24.7 (VCC_{B}), U25.7 (VCC_{B}), U26.3 (VDD); also elsewhere on the board
+3V3_BUS: J13.21, J13.22, J13.23, J13.24, J14.21, J14.22, J14.23, J14.24; also elsewhere on the board
+5V: C66.1, J12.2, U23.7 (VCC_{B}); also elsewhere on the board
/Peripherals/FAN_PWM_5V: J12.4, U23.8 (B_{1})
/Peripherals/FAN_TACH_5V: J12.3, U23.1 (B_{2})
/Peripherals/Pin_30: J13.30, J14.30
/Peripherals/Pin_32: J13.32, J14.32
/Peripherals/Pin_34: J13.34, J14.34
/Peripherals/Pin_36: J13.36, J14.36
/Peripherals/Pin_38: J13.38, J14.38
/Peripherals/Pin_40: J13.40, J14.40
/Peripherals/Pin_42: J13.42, J14.42
/Peripherals/Pin_43: J13.43, J14.43
/Peripherals/Pin_45: J13.45, J14.45
/Peripherals/Pin_49: J13.49, J14.49
/Peripherals/Pin_51: J13.51, J14.51
/Peripherals/Pin_52: J13.52, J14.52
/Peripherals/Pin_53: J13.53, J14.53
/Peripherals/Pin_54: J13.54, J14.54
/Peripherals/Pin_55: J13.55, J14.55
/Peripherals/Pin_56: J13.56, J14.56
/Peripherals/Pin_57: J13.57, J14.57
/Peripherals/Pin_58: J13.58, J14.58
CAN_RXD: U26.4 (RXD); also elsewhere on the board
CAN_TXD: U26.1 (TXD); also elsewhere on the board
FAN_PWM: U23.5 (A_{1}); also elsewhere on the board
FAN_TACH: U23.4 (A_{2}); also elsewhere on the board
GND: C63.2, C64.2, C65.2, C66.2, C67.2, C68.2, C69.2, H6.1 (1_1), H7.1 (1_1), J12.1, J12.MP (MountPin), J13.11, J13.12, J13.13, J13.14, J13.15, J13.16, J13.17, J13.18, J13.19, J13.20, J13.25, J13.26, J13.27, J13.28, J13.35, J13.41, J13.44, J13.47, J13.59, J13.60, J13.SH (Shield), J14.11, J14.12, J14.13, J14.14, J14.15, J14.16, J14.17, J14.18, J14.19, J14.20, J14.25, J14.26, J14.27, J14.28, J14.35, J14.41, J14.44, J14.47, J14.59, J14.60, J14.SH (Shield), R102.2, U23.2 (GND), U24.2 (GND), U25.2 (GND), U26.2 (GND); also elsewhere on the board
MB_JETSON_CS: J13.48, J14.48, U25.8 (B_{1})
MB_MASTER_EN: J13.46, J14.46; also elsewhere on the board
MB_SCL: J13.37, J14.37; also elsewhere on the board
MB_SDA: J13.39, J14.39; also elsewhere on the board
MB_SPI_MISO: J13.33, J14.33, U25.1 (B_{2})
MB_SPI_MOSI: J13.31, J14.31, U24.8 (B_{1})
MB_SPI_SCK: J13.29, J14.29, U24.1 (B_{2})
unnamed: R103.1, TP19.1 (1_1), U26.7 (CANH)
unnamed: R103.2, TP20.1 (1_1), U26.6 (CANL)
unnamed: R102.1, U26.8 (RS)
SLEEP/~WAKE_3V3: J13.50, J14.50; also elsewhere on the board
SPI0_MISO: U25.4 (A_{2}); also elsewhere on the board
SPI0_MOSI: U24.5 (A_{1}); also elsewhere on the board
SPI0_SCK: U24.4 (A_{2}); also elsewhere on the board
VBATT: J13.1, J13.2, J13.3, J13.4, J13.5, J13.6, J13.7, J13.8, J13.9, J13.10, J14.1, J14.2, J14.3, J14.4, J14.5, J14.6, J14.7, J14.8, J14.9, J14.10; also elsewhere on the board
~MOD_SLEEP: TP18.1 (1_1); also elsewhere on the board
~SPI0_CS: U25.5 (A_{1}); also elsewhere on the board

Notes on the sheet:
Fan connector
Mainboard FPC Connector

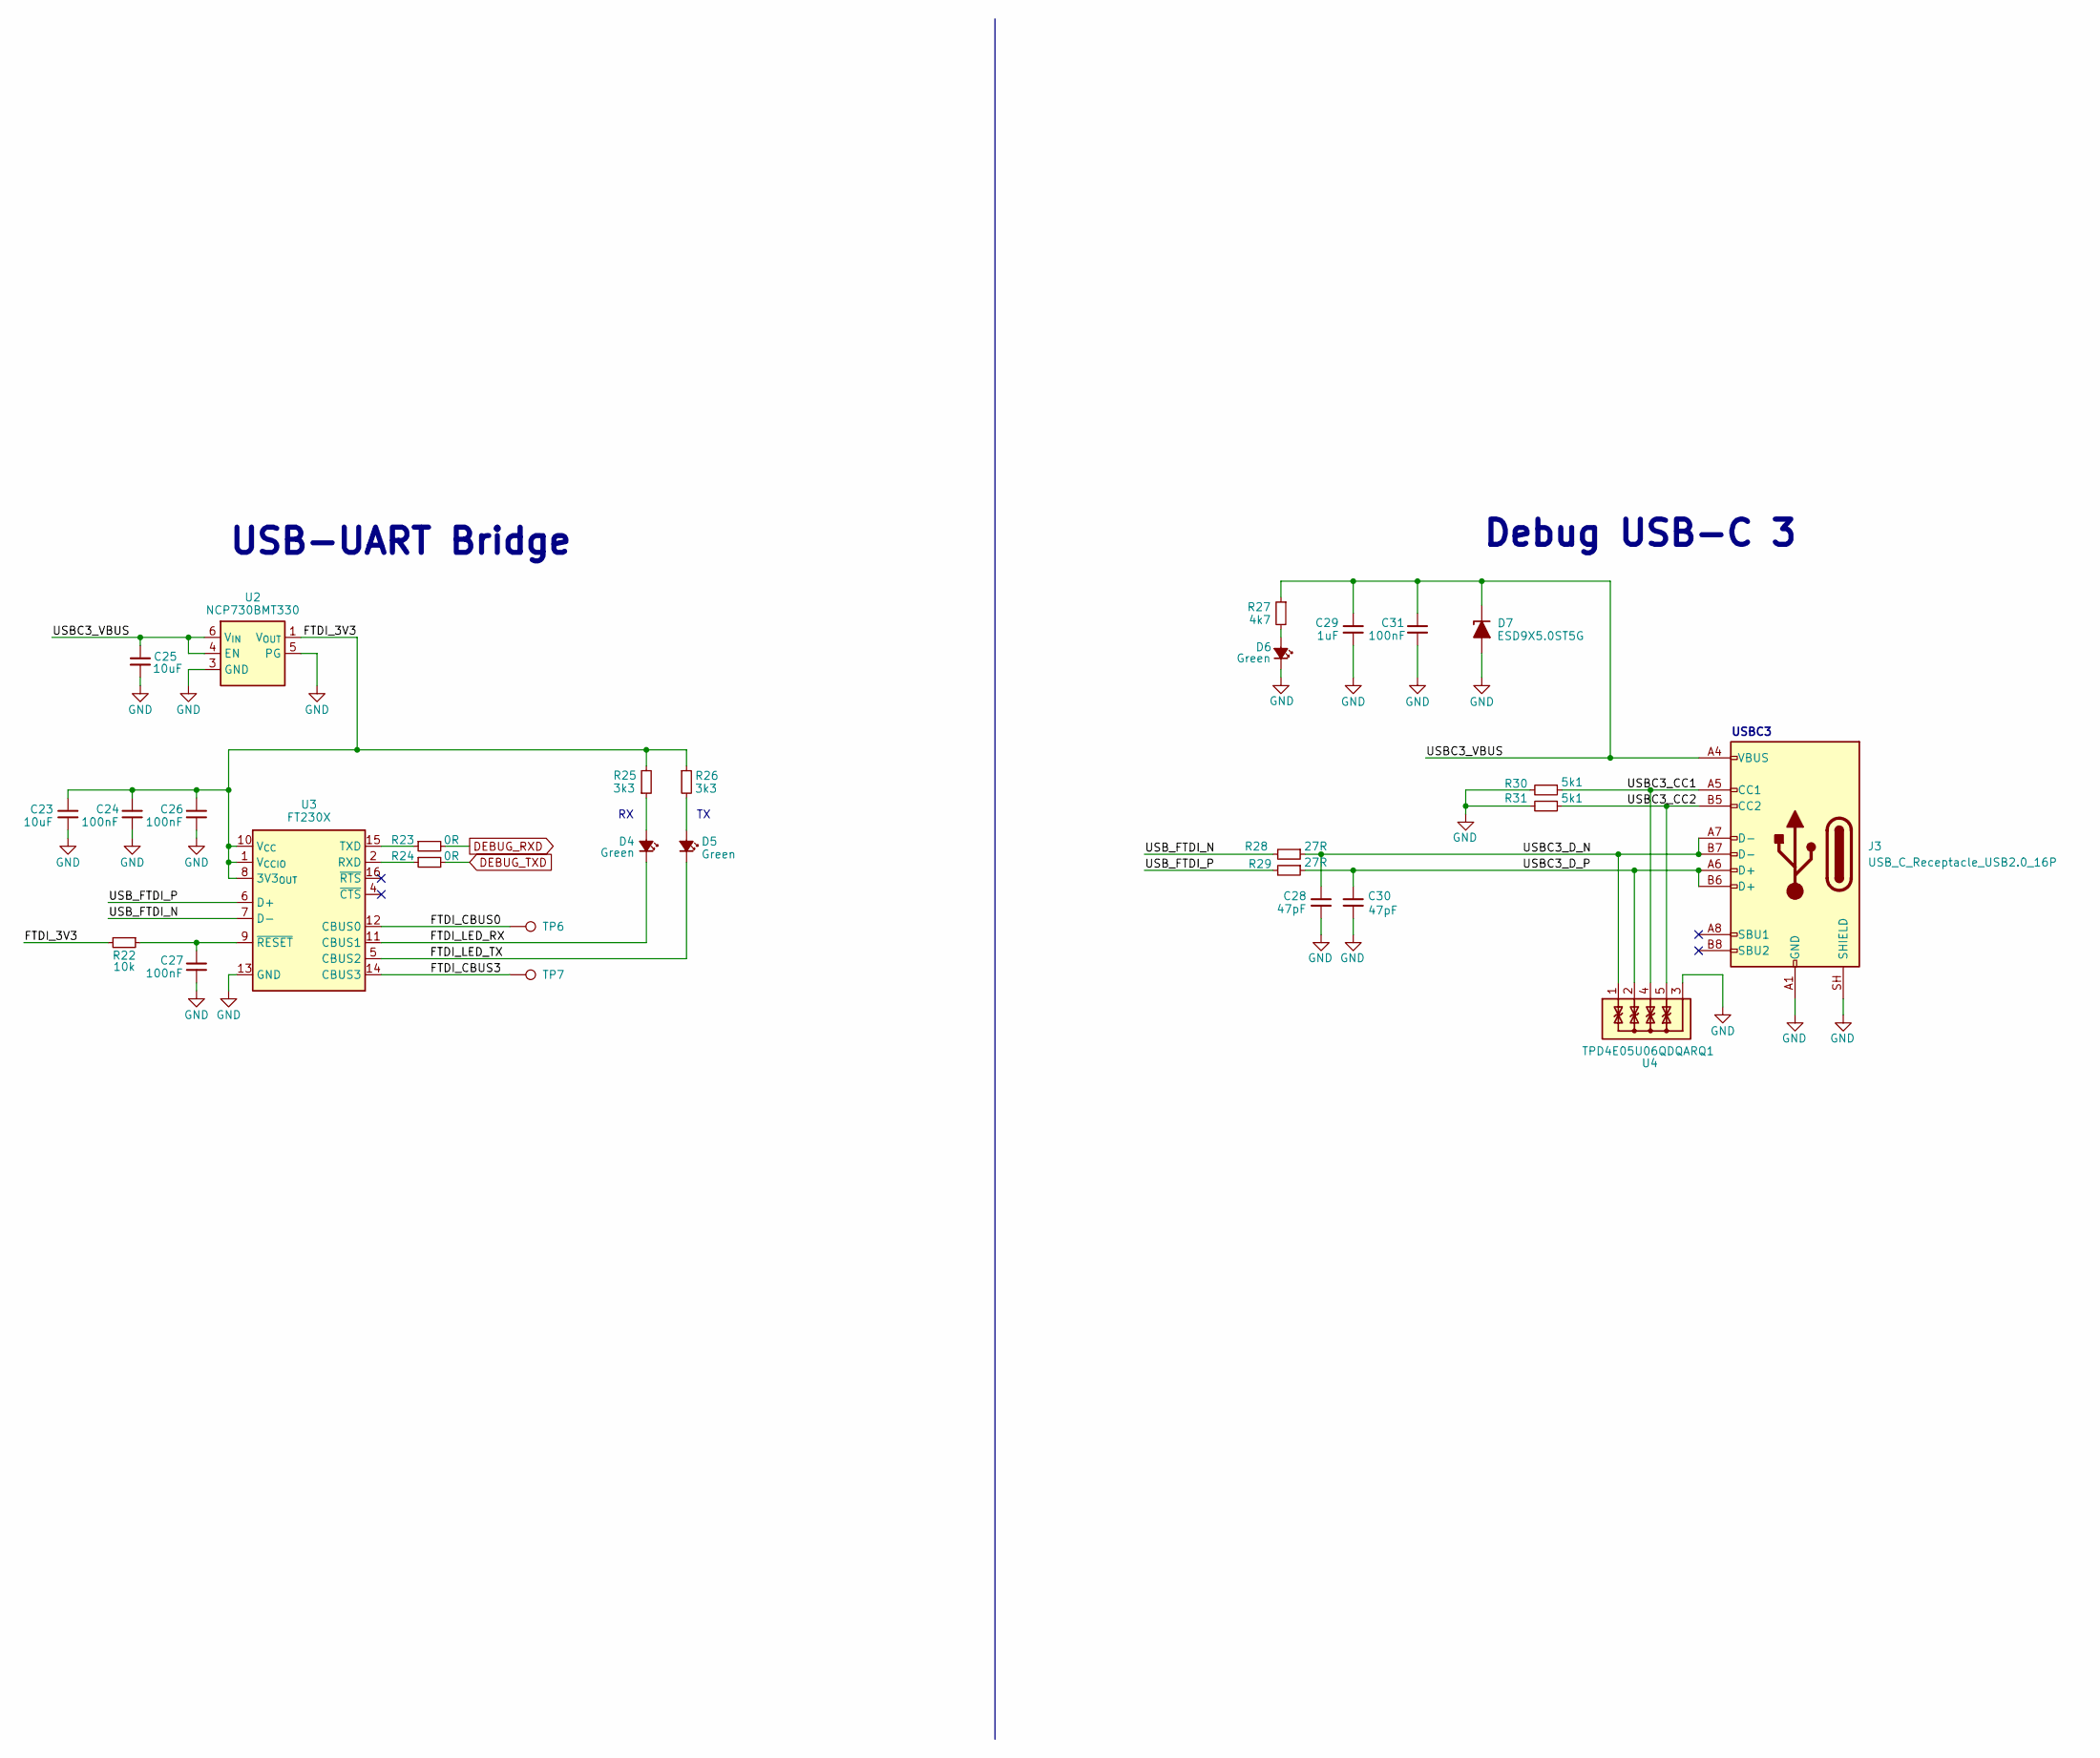
[picture p9: schematic usb.kicad_sch, Argus Carrierboard]

Parts:
C23, C25: 10uF; C_0603_1608Metric; MPN C697423; LCSC C96446
C24, C26, C27, C31: 100nF; C_0603_1608Metric; MPN C307348; LCSC C14663
C28, C30: 47pF; C_0402_1005Metric; MPN C126511; LCSC C1567
C29: 1uF; C_0603_1608Metric; MPN C2214844; LCSC C15849
D4, D5: LED_G_0603_LTST-C190GKT; LED_0603_1608Metric; MPN C2909774; LCSC C2290
D6: LED_G_0603_LTST-C190GKT; LED_0603_1608Metric; MPN C2909774; LCSC C12065
D7: ESD9X5.0ST5G; D_SOD-923; MPN C87910; LCSC C87910
J3: USB_C_Receptacle_USB2.0_16P; USB_C_Receptacle_GCT_USB4105-xx-A_16P_TopMnt_Horizontal; LCSC C3020560
R22: 10k; R_0603_1608Metric; MPN C2479067; LCSC C25804
R23, R24: 0R; R_0402_1005Metric; MPN C190119; LCSC C17168
R25, R26: 3k3; R_0603_1608Metric; MPN C844928; LCSC C22978
R27: 4k7; R_0603_1608Metric; MPN C844931; LCSC C23162
R28, R29: 27R; R_0603_1608Metric; MPN C844545; LCSC C227752
R30, R31: 5k1; R_0603_1608Metric; MPN C490833; LCSC C23186
TP6, TP7: TP_0.75mm_SMD; TestPoint_Pad_D1.0mm
U2: NCP730BMT330; WSON-6-1EP_2x2mm_P0.65mm; MPN C892821; LCSC C892821
U3: FT230X; QFN-16-1EP_4x4mm_P0.65mm_EP2.1x2.1mm; MPN C128629; LCSC C128629
U4: TPD4E05U06QDQARQ1; USON-10_TEX; MPN C81353; LCSC C81353

Connections:
/Debug/FTDI_3V3: C23.2, C24.2, C26.2, R22.2, R25.2, R26.1, U2.1 (V_{OUT}), U3.1 (V_{CCIO}), U3.8 (3V3_{OUT}), U3.10 (V_{CC})
/Debug/FTDI_CBUS0: TP6.1 (1_1), U3.12 (CBUS0)
/Debug/FTDI_CBUS3: TP7.1 (1_1), U3.14 (CBUS3)
/Debug/FTDI_LED_RX: D4.1 (K), U3.11 (CBUS1)
/Debug/FTDI_LED_TX: D5.1 (K), U3.5 (CBUS2)
/Debug/USBC3_CC1: J3.A5 (CC1), R30.1, U4.4, U4.7
/Debug/USBC3_CC2: J3.B5 (CC2), R31.1, U4.5, U4.6
/Debug/USBC3_D_N: C28.1, J3.A7 (D-), J3.B7 (D-), R28.1, U4.1, U4.10
/Debug/USBC3_D_P: C30.2, J3.A6 (D+), J3.B6 (D+), R29.1, U4.2, U4.9
/Debug/USBC3_VBUS: C25.2, C29.2, C31.2, D7.1 (K), J3.A4 (VBUS), J3.A9 (VBUS), J3.B4 (VBUS), J3.B9 (VBUS), R27.1, U2.4 (EN), U2.6 (V_{IN})
/Debug/USB_FTDI_N: R28.2, U3.7 (D-)
/Debug/USB_FTDI_P: R29.2, U3.6 (D+)
DEBUG_RXD: R23.2; also elsewhere on the board
DEBUG_TXD: R24.2; also elsewhere on the board
GND: C23.1, C24.1, C25.1, C26.1, C27.2, C28.2, C29.1, C30.1, C31.1, D6.1 (K), D7.2 (A), J3.A1 (GND), J3.A12 (GND), J3.B1 (GND), J3.B12 (GND), J3.SH (SHIELD), R30.2, R31.2, U2.3 (GND), U2.5 (PG), U2.7 (GND), U3.3 (GND), U3.13 (GND), U3.17 (GND), U4.3, U4.8; also elsewhere on the board
unnamed: D4.2 (A), R25.1
unnamed: D5.2 (A), R26.2
unnamed: D6.2 (A), R27.2
unnamed: R24.1, U3.2 (RXD)
unnamed: R23.1, U3.15 (TXD)
unnamed: C27.1, R22.1, U3.9 (~RESET)

Notes on the sheet:
USBC3
USB-UART Bridge
Debug USB-C 3

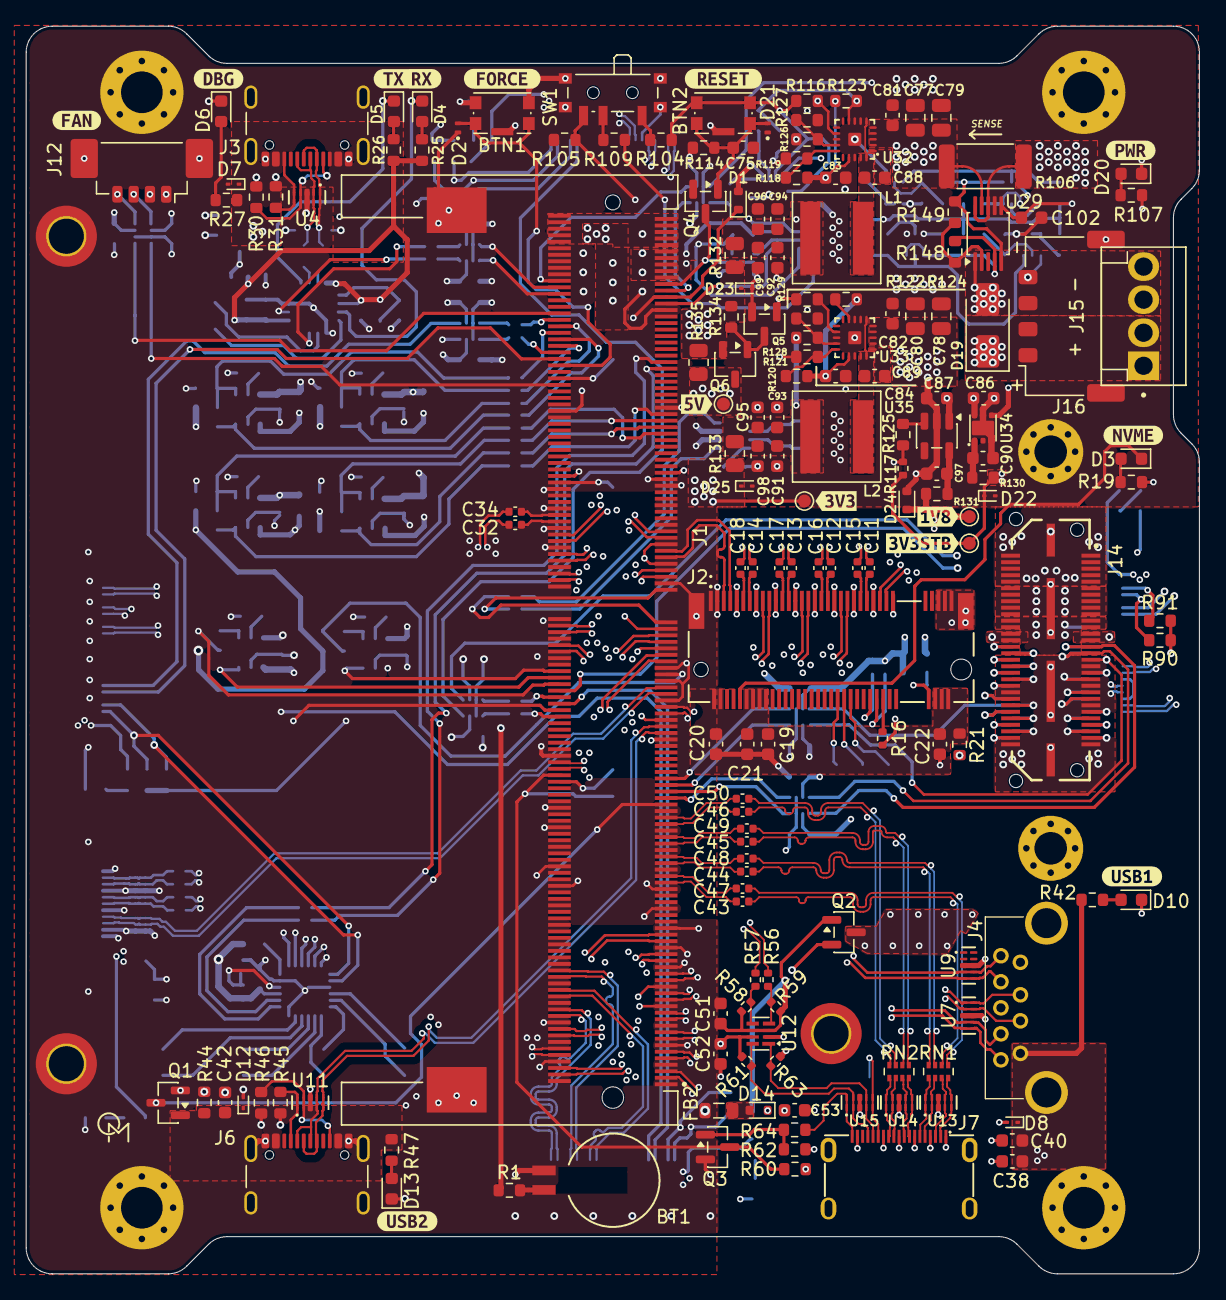
[picture p10: board jetson-orin-baseboard.kicad_pcb from above]

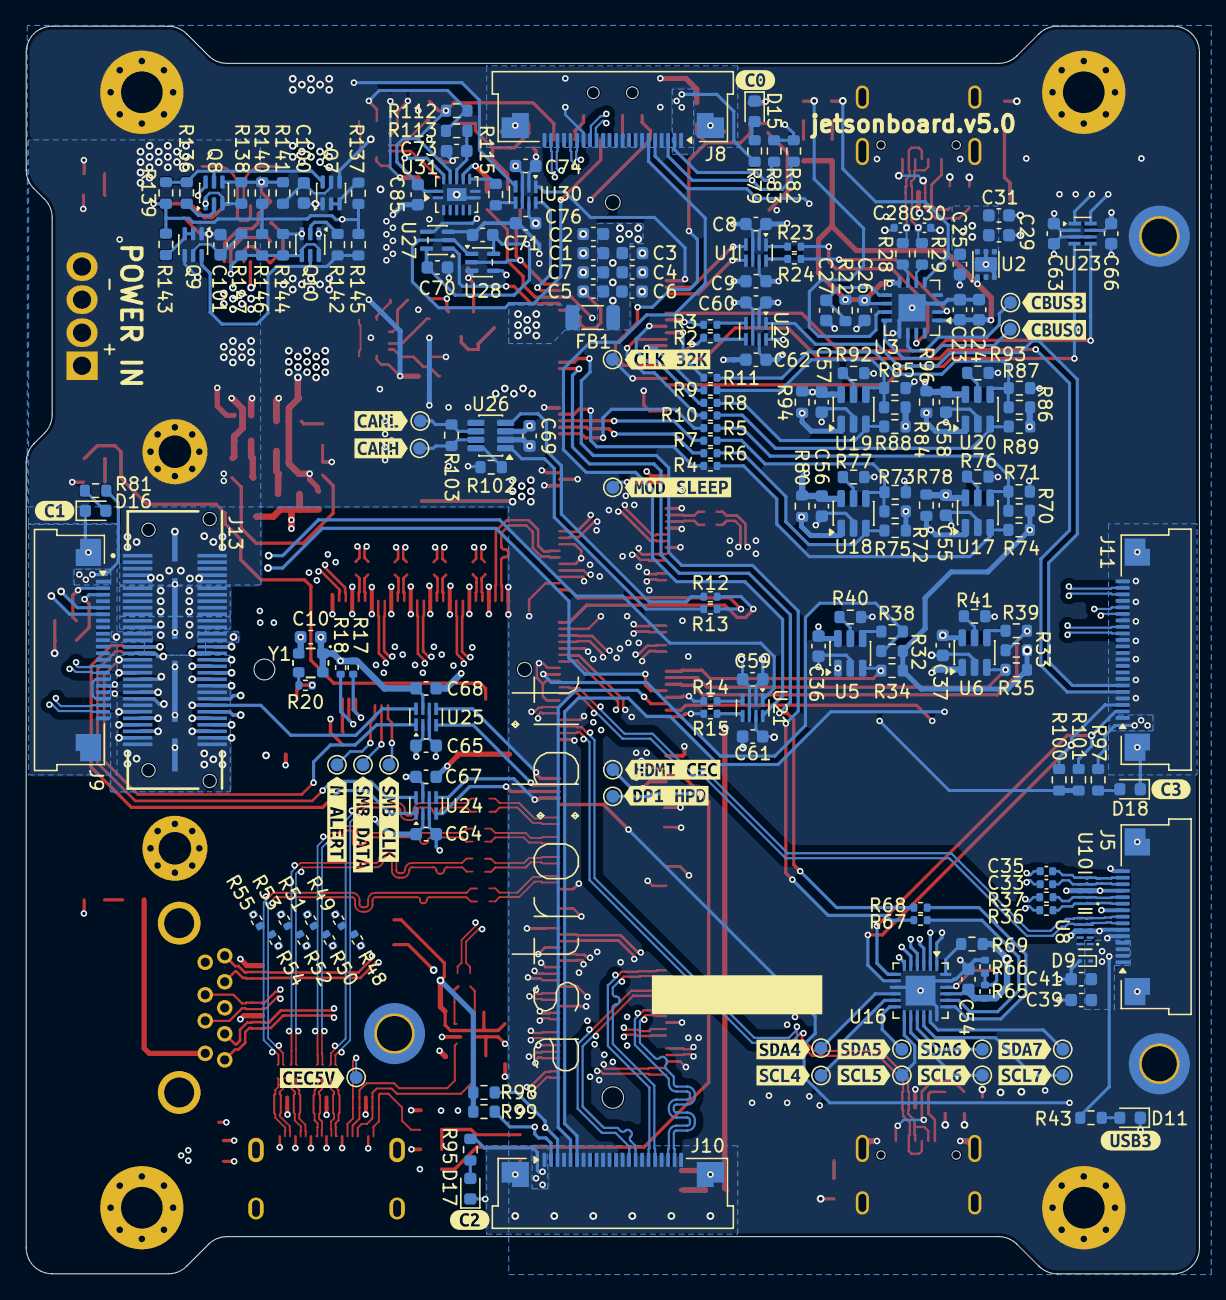
[picture p11: board jetson-orin-baseboard.kicad_pcb from below]

Board: 8 copper layers, 90.2 x 95.9 mm, 414 parts (227 on the bottom side), 325 nets.

Other parts of the board:
C100, C101: 10n; C_0603_1608Metric
Q7, Q9: NX3008NBKS; SOT-363_SC-70-6
Q8, Q10: MBT2222ADW1T1; SOT-363_SC-70-6
R136, R142: 680R; R_0603_1608Metric
R137, R143: 100k; R_0603_1608Metric
R138, R144: 0R; R_0603_1608Metric
R139, R140, R145, R146: 10k; R_0603_1608Metric
R141, R147: 200k; R_0603_1608Metric
kibuzzard-6AA4CB0A: G***; kibuzzard-6AA4CB0A
kibuzzard-6AA4CB7C: G***; kibuzzard-6AA4CB7C
kibuzzard-6AA4CB93: G***; kibuzzard-6AA4CB93
kibuzzard-6AA4CBA6: G***; kibuzzard-6AA4CBA6
kibuzzard-6AA4CCDD: G***; kibuzzard-6AA4CCDD
kibuzzard-6AA4CCE8: G***; kibuzzard-6AA4CCE8
kibuzzard-6AA4CCF3: G***; kibuzzard-6AA4CCF3
kibuzzard-6AA4CCFD: G***; kibuzzard-6AA4CCFD
kibuzzard-6AA4D0D5: G***; kibuzzard-6AA4D0D5
kibuzzard-6AA4D0E1: G***; kibuzzard-6AA4D0E1
kibuzzard-6AA4D3A3: G***; kibuzzard-6AA4D3A3
kibuzzard-6AA4D3AB: G***; kibuzzard-6AA4D3AB
kibuzzard-6AA4D4B3: G***; kibuzzard-6AA4D4B3
kibuzzard-6AA4D4C2: G***; kibuzzard-6AA4D4C2
kibuzzard-6AA4D4DE: G***; kibuzzard-6AA4D4DE
kibuzzard-6AA4D12B: G***; kibuzzard-6AA4D12B
kibuzzard-6AA4D056: G***; kibuzzard-6AA4D056
kibuzzard-6AA5BAD4: G***; kibuzzard-6AA5BAD4
kibuzzard-6AA5C51C: G***; kibuzzard-6AA5C51C
kibuzzard-6AA5EB39: G***; kibuzzard-6AA5EB39
kibuzzard-6AA5EB57: G***; kibuzzard-6AA5EB57
kibuzzard-6AA5EC14: G***; kibuzzard-6AA5EC14
kibuzzard-6AA5EC48: G***; kibuzzard-6AA5EC48
kibuzzard-6AA615B2: G***; kibuzzard-6AA615B2
kibuzzard-6AA616B5: G***; kibuzzard-6AA616B5
kibuzzard-6AA622B3: G***; kibuzzard-6AA622B3
kibuzzard-6AA6154A: G***; kibuzzard-6AA6154A
kibuzzard-6AA6159C: G***; kibuzzard-6AA6159C
kibuzzard-6AB55D8A: G***; kibuzzard-6AB55D8A
kibuzzard-6AB55D85: G***; kibuzzard-6AB55D85
kibuzzard-6ABE9DBB: G***; kibuzzard-6ABE9DBB
kibuzzard-6ABE9DD8: G***; kibuzzard-6ABE9DD8
kibuzzard-6ABE9DF7: G***; kibuzzard-6ABE9DF7
kibuzzard-6ABE9E40: G***; kibuzzard-6ABE9E40
kibuzzard-6ABE9EA3: G***; kibuzzard-6ABE9EA3
kibuzzard-6ABE9EB3: G***; kibuzzard-6ABE9EB3
kibuzzard-6ABE9F12: G***; kibuzzard-6ABE9F12
kibuzzard-6ABE9F28: G***; kibuzzard-6ABE9F28
kibuzzard-6ABEA036: G***; kibuzzard-6ABEA036

Their connections:
+3V3_BUS: R137.1, R139.1, R140.1, R143.1, R145.1, R146.1; also elsewhere on the board
/Supply/ISENSE_SCL: Q8.4 (E2), Q8.6 (C1), R138.1, R140.2, R141.1; also elsewhere on the board
/Supply/ISENSE_SDA: Q10.4 (E2), Q10.6 (C1), R144.1, R146.2, R147.1; also elsewhere on the board
GND: C100.2, C101.2, Q7.1 (S2), Q7.4 (S1), Q9.1 (S2), Q9.4 (S1); also elsewhere on the board
MB_SCL: Q8.1 (E1), Q8.3 (C2), R138.2; also elsewhere on the board
MB_SDA: Q10.1 (E1), Q10.3 (C2), R144.2; also elsewhere on the board
unnamed: Q7.6 (D1), Q8.5 (B2), R136.2, R139.2
unnamed: Q7.2 (G2), Q7.3 (D2), R137.2
unnamed: C100.1, Q7.5 (G1), R141.2
unnamed: Q8.2 (B1), R136.1
unnamed: Q9.2 (G2), Q9.3 (D2), R143.2
unnamed: C101.1, Q9.5 (G1), R147.2
unnamed: Q10.2 (B1), R142.1
unnamed: Q9.6 (D1), Q10.5 (B2), R142.2, R145.2
