cmu-argus-2/Avionics-JetsonCarrier/_restore_backup_2026-09-04T09-51-43-778/jetson-orin-baseboard.kicad_pcb

## KiCad design _restore_backup_2026-09-04T09-51-43-778/jetson-orin-baseboard.kicad_pcb (2026-09-07)

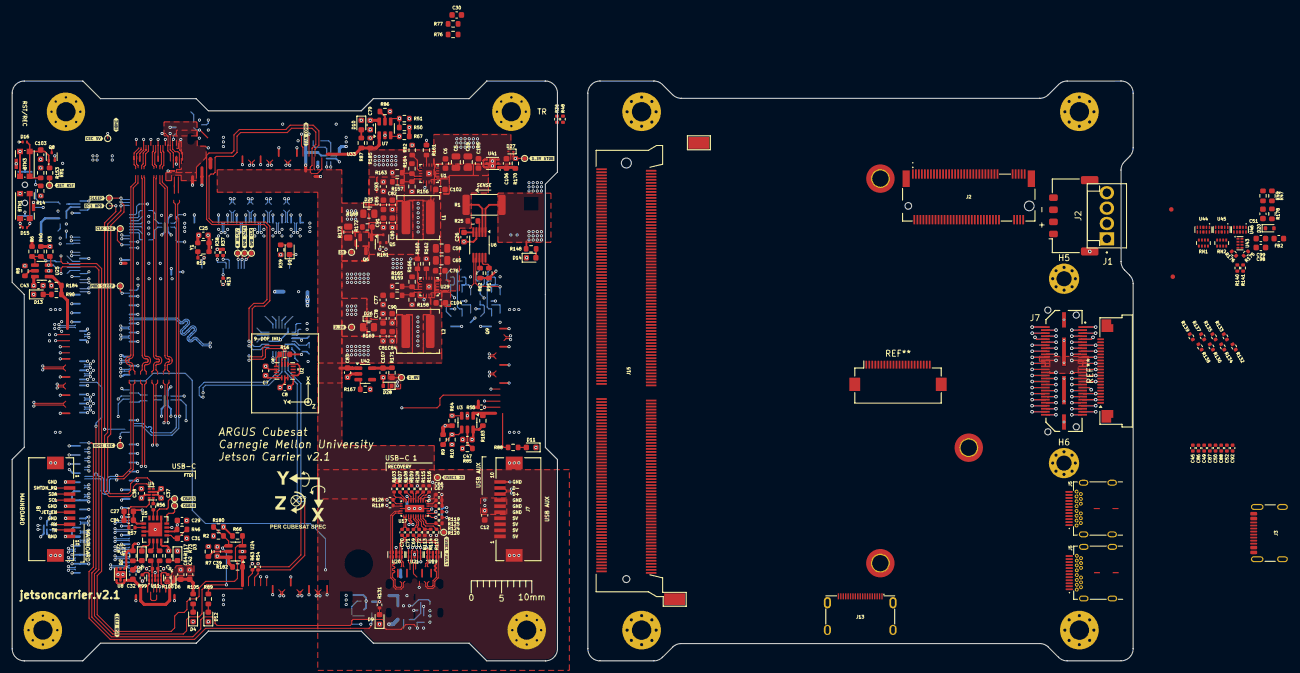
[picture p12: board _restore_backup_2026-09-04T09-51-43-778/jetson-orin-baseboard.kicad_p… from above]

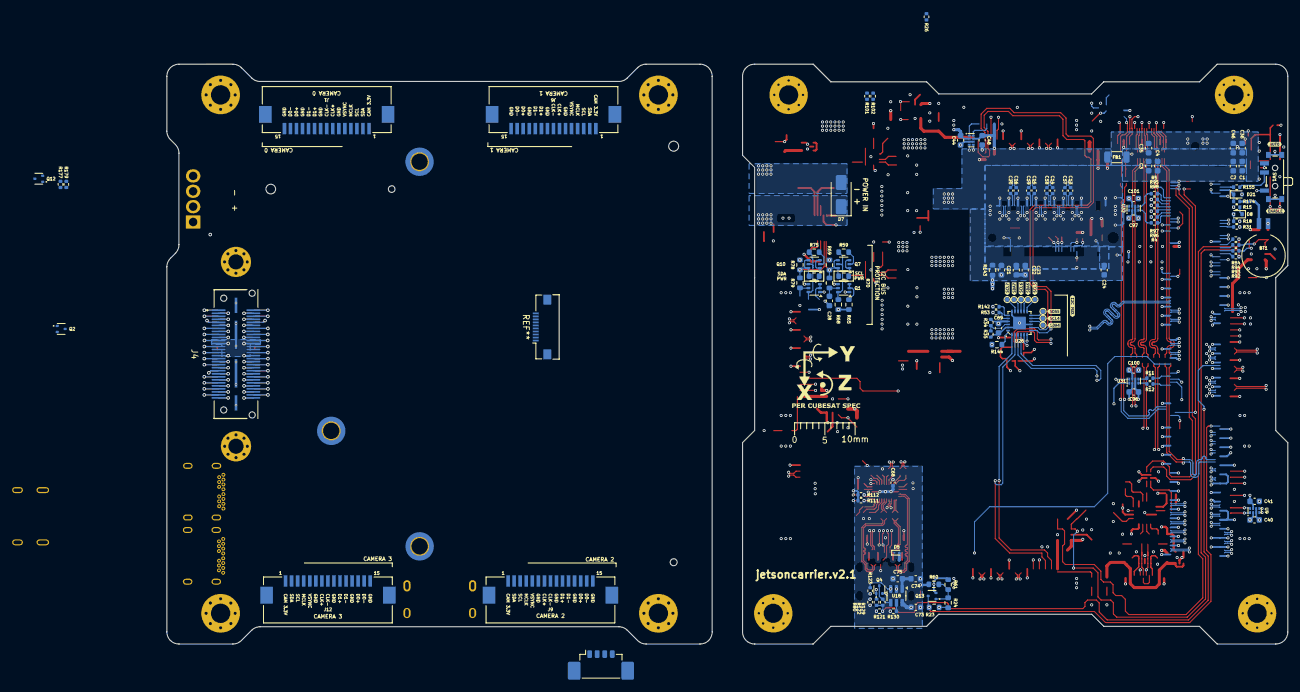
[picture p13: board _restore_backup_2026-09-04T09-51-43-778/jetson-orin-baseboard.kicad_p… from below]

Board: 8 copper layers, 90.2 x 95.9 mm, 411 parts (129 on the bottom side), 312 nets.

Parts:
BT1: MS621FE-FL11E
BTN1, BTN3: KMR211NGLFS; SW_Push_1P1T-SH_NO_CK_KMR2xxG
C1, C2, C3, C4, C35, C36, C46, C78, C80, C81, C82, C84, C85, C90, C91: 22uF; C_0603_1608Metric
C5, C58, C59, C65: 22uF; C_0805_2012Metric
C6, C7, C8, C25, C27, C29, C31, C37, C38, C39, C40, C41, C43, C44, C47, C48, C64, C73, C75, C76, C79, C89, C96, C97, C98, C99, C100, C101, C102, C103, C104: 100nF; C_0603_1608Metric
C12, C42, C77, C93, C107: 1uF; C_0603_1608Metric
C13, C14, C15, C16, C17, C18, C19, C20: 220nF; C_0402_1005Metric
C21, C22, C23, C24, C32, C34, C51, C74, C83, C105, C106: 10uF; C_0603_1608Metric
C26: 3300pF; C_0603_1608Metric
C28, C30: 10nF; C_0603_1608Metric
C45, C49, C50, C52, C67, C68, C69, C70, C71, C72, C86, C87, C88, C92: 100nF; C_0402_1005Metric
C66: 10uF; C_0402_1005Metric
C94, C95: 47pF; C_0402_1005Metric
D1, D2, D3, D4, D9, D10, D11, D12, D13, D14: LED_G_0603_LTST-C190GKT; LED_0603_1608Metric
D5, D6, D25: ESD9X5.0ST5G; D_SOD-923
D7: 10V; D_SMA
D8, D20, D21: RB521S30T1G; D_SOD-523
D15, D16: TPD1E0B04; Texas_DPY0002A_0.6x1mm_P0.65mm
D26, D27: ESD9X3.3ST5G; D_SOD-923
D28: ESD1V8WT; D_SOD-523
FB1: 74279221100; L_1206_3216Metric
FB2: BLM21PG221SN1D; L_0603_1608Metric
H1, H2#2, H3#2, H4#2: MountingHole_Pad; MountingHole2
H1#2, H2, H3, H4: MountingHole_Pad; MountingHole_3.2mm_M3_Pad_Via
H5, H6#2: MountingHole_Pad; MountingHole_2.5mm_Pad_Via
H5#2: 9774025151; MountingHole_2.7mm_M2.5_DIN965_Pad_TopBottom
H6, H7: 9774065151; MountingHole_2.7mm_M2.5_DIN965_Pad_TopBottom
J1: 205338-0004; Molex_Pico-Lock_205338-0004_1x04-1MP_P2.00mm_Horizontal
J1#2, J6, J9, J12: 522071560; CON_522071560_MOL
J2: 282834-4; TE_282834-4
J2#2: 1-2199230-6; Bus_M.2_Socket_Key_M_TE_1-2199230-6
J3: USB4105-GF-A; USB_C_Receptacle_GCT_USB4105-xx-A_16P_TopMnt_Horizontal
J4: QTH-030-01-L-D-A; SAMTEC_QSH-030-01-L-D-A
J5, J5#2: 632723300011; USB-C_Receptacle_WE_632723300011
J7, J8: 522711069; CON_522711069_MOL
J7#2: QTH-030-01-L-D-A; SAMTEC-QTH-030-01-L-D-A
J10: 0533980471; Molex_PicoBlade_53398-0471_1x04-1MP_P1.25mm_Vertical
J13: 685119136923; HDMI-Mini-C_Receptacle_WE_685119136923
J15: Bus_DDR4_SODIMM_CUSTOM_Jetson-Orin-H9.2mm-socket; TE_2309413
L1, L2: XGL6030-182MEC; L_Coilcraft_XAL6030-XXX
Q1, Q9: BSS138DWQ-7; SOT-363_SC-70-6
Q2, Q4, Q5, Q8, Q12, Q13: PJE138K; SOT-523
Q6: SSM3J332R; SOT-23-3
Q7, Q10: MBT2222ADW1T1; SOT-363_SC-70-6
R1: 10m; R_2512_6332Metric
R2, R6, R10, R49, R51, R65, R76, R178: 100k; R_0603_1608Metric
R3, R9, R14, R16, R24, R40, R46, R47, R50, R60, R64, R66, R67, R68, R69, R77, R78, R81, R82, R144, R148, R157, R159, R161, R162, R172, R180: 10k; R_0603_1608Metric
R4, R5, R11, R12, R13, R19, R34, R35, R53, R56, R57, R84, R92, R93, R94, R95, R96, R97, R98, R103, R107, R108, R109, R110, R113, R114, R118, R119, R124, R125, R140, R141, R142, R155, R181: 0R; R_0402_1005Metric
R7, R8, R85, R86, R87, R88, R89, R90, R105: 4k7; R_0603_1608Metric
R15: 200R; R_0402_1005Metric
R18, R115, R116, R120, R122, R123, R129: 10k; R_0402_1005Metric
R23, R62, R71, R74, R143, R160, R167, R170, R171, R182, R183, R184, R185: 0R; R_0603_1608Metric
R25: 1k; R_0603_1608Metric
R26, R36, R48, R54, R55, R63, R101, R102, R130, R174, R175, R176, R177, R179: 2k2; R_0402_1005Metric
R31, R80, R126: 200k; R_0402_1005Metric
R37, R38: 47k; R_0402_1005Metric
R39, R72, R73: 3k3; R_0603_1608Metric
R59, R75: 680R; R_0603_1608Metric
R61, R70, R79, R153: 200k; R_0603_1608Metric
R91: 150k; R_0603_1608Metric
R99, R100: 5k1; R_0402_1005Metric
R111, R112, R131: 4k7; R_0402_1005Metric
R117, R127: 27R; R_0603_1608Metric
R121: 1k; R_0402_1005Metric
R128: 887k; R_0402_1005Metric
R132, R133, R134, R135, R136, R137, R138, R139: 499R; R_0402_1005Metric
R156, R158: 220k; R_0603_1608Metric
R163: 110k; R_0603_1608Metric
R164: 15k; R_0603_1608Metric
R165: 90k9; R_0603_1608Metric
R166: 20k; R_0603_1608Metric
R168, R169, R173: 0R; R_0805_2012Metric
RN1, RN2: 4x0R; R_Array_Concave_4x0402
SW1: SW_SPDT; SW_SPDT_PCM12
TP5, TP7, TP8, TP9, TP10, TP11, TP12, TP13, TP14, TP15, TP16, TP17, TP18, TP19, TP20, TP21, TP22, TP23, TP24, TP25, TP26, TP27, TP28, TP29, TP30, TP31: TP_0.75mm_SMD; TP_SMD_0.75mm
U1, U29: TPS56C230; QFN-20-1EP_3x3mm_P0.45mm
U2: BMX160; BMX160_BOS
U3, U7, U18, U24, U25: AP22615A; TSOT-23-6
U4, U9, U31, U32, U33, U43: NTS0102; XSON-8_1x1.95mm_P0.5mm
U5: FT230X; QFN-16-1EP_4x4mm_P0.65mm
U6: ADM1176-1ARMZ-R7; MSOP-10_3x3mm_P0.5mm
U8, U41: NCP730BMT330; WSON-6-1EP_2x2mm_P0.65mm
U11, U19, U20, U21, U44, U45, U46: TPD4E05U06QDQARQ1; USON-10_2.5x1mm_P0.5mm
U17: HD3SS3220RNH; WQFN-30-1EP_4.6x2.6mm_P0.4mm
U26: PI4MSD5V9548AZDEX; VQFN-24-1EP_3.8x3.8x1.0mm_P0.5mm
U42: TPS7A0518P; SOT-23-5
Y1: ECS-327MVATX-2-CN-TR3; Oscillator_SMD_ECS_2520MV_2.5x2mm
kibuzzard-66A2C7D6: G***; kibuzzard-66A2C7D6
kibuzzard-66A2C813: G***; kibuzzard-66A2C813
kibuzzard-66A2D521: G***; kibuzzard-66A2D521
kibuzzard-66A2D898: G***; kibuzzard-66A2D898
kibuzzard-66A2DAF8: G***; kibuzzard-66A2DAF8
kibuzzard-66A2E1AC: G***; kibuzzard-66A2E1AC
kibuzzard-66A2E3EB: G***; kibuzzard-66A2E3EB
kibuzzard-66A2E22A: G***; kibuzzard-66A2E22A
kibuzzard-66A2E36E: G***; kibuzzard-66A2E36E
kibuzzard-66A2E37A: G***; kibuzzard-66A2E37A
kibuzzard-66A2E38A: G***; kibuzzard-66A2E38A
kibuzzard-66A2E142: G***; kibuzzard-66A2E142
kibuzzard-66A2E367: G***; kibuzzard-66A2E367
kibuzzard-66A2E384: G***; kibuzzard-66A2E384
kibuzzard-66A2E572: G***; kibuzzard-66A2E572
kibuzzard-66A2E636: G***; kibuzzard-66A2E636
kibuzzard-66A2E657: G***; kibuzzard-66A2E657
kibuzzard-66A2EA01: G***; kibuzzard-66A2EA01
kibuzzard-66A2EB4E: G***; kibuzzard-66A2EB4E
kibuzzard-66A2EB73: G***; kibuzzard-66A2EB73
kibuzzard-66A33B7D: G***; kibuzzard-66A33B7D
kibuzzard-66A33EAB: G***; kibuzzard-66A33EAB
kibuzzard-66A33F01: G***; kibuzzard-66A33F01
kibuzzard-66A33FD4: G***; kibuzzard-66A33FD4
kibuzzard-66A3387D: G***; kibuzzard-66A3387D
kibuzzard-66A3395A: G***; kibuzzard-66A3395A
kibuzzard-66A3478C: G***; kibuzzard-66A3478C
kibuzzard-66A33739: G***; kibuzzard-66A33739
kibuzzard-66A34183: G***; kibuzzard-66A34183
kibuzzard-66A43634: G***; kibuzzard-66A43634
kibuzzard-66A43694: G***; kibuzzard-66A43694
kibuzzard-67FEBB22: G***; kibuzzard-67FEBB22

Connections:
3V3_STDB: BTN3.1, D21.2 (A), D27.1 (K), R14.2, R18.1, R65.1, R68.1, R69.1, R76.1, R77.1, R78.1, R82.2, R170.1, R181.2, TP23.1
5V_SoM: D25.1 (K), FB1.1, Q6.2 (S), R168.1, R172.1, R173.1
+1V8: C37.1, C40.1, C44.1, C89.2, C96.1, C97.1, D28.1 (K), R3.1, R9.1, R31.1, R34.2, R40.1, R47.1, R50.1, R64.1, R66.1, R67.1, R80.2, R121.1, R123.1, R144.2, R171.1, R180.1, TP24.1, U4.3 (VCC_{A}), U4.6 (OE), U9.3 (VCC_{A}), U9.6 (OE), U26.21 (VCC), U31.3 (VCC_{A}), U31.6 (OE), U32.3 (VCC_{A}), U32.6 (OE), U33.3 (VCC_{A}), U33.6 (OE)
+3V3: C7.1, C8.2, C25.2, C38.1, C39.2, C41.1, C43.2, C47.2, C68.2, C79.2, C98.1, C100.1, C101.1, D26.1 (K), Q2.1 (G), R26.1, R36.1, R37.1, R38.1, R39.1, R48.1, R54.1, R55.1, R63.1, R101.1, R102.1, R111.1, R112.1, R126.2, R143.1, R169.2, R175.1, R176.2, R182.1, R183.1, R184.1, R185.1, TP21.1, U2.5 (VDDIO), U2.8 (VDD), U2.12 (CSB), U3.6 (IN), U4.7 (VCC_{B}), U7.6 (IN), U9.7 (VCC_{B}), U17.8 (VCC33), U24.6 (IN), U25.6 (IN), U31.7 (VCC_{B}), U32.7 (VCC_{B}), U43.3 (VCC_{A}), U43.6 (OE), Y1.1 (EN), Y1.4 (VDD)
+3V3_BUS: J4.21, J4.22, J4.23, J4.24
+5V: C12.2, C48.1, C66.2, C67.2, C73.2, C83.1, FB2.1, J7.1, J7.2, J7.3, J7.4, J10.2, Q6.3 (D), R113.2, R115.2, R116.1, R120.1, R173.2, TP28.1, U17.30 (VDD5), U18.6 (IN), U33.7 (VCC_{B}), U42.1 (VIN)
/CSI/3V3_CAM0: J1#2.1, R89.2, R182.2, U24.1 (OUT)
/CSI/3V3_CAM0_ISET: R7.1, U24.5 (ISET)
/CSI/3V3_CAM1: J6.1, R90.2, R184.2, U25.1 (OUT)
/CSI/3V3_CAM1_ISET: R8.1, U25.5 (ISET)
/CSI/3V3_CAM2: J9.1, R88.2, R183.2, U3.1 (OUT)
/CSI/3V3_CAM2_ISET: R85.1, U3.5 (ISET)
/CSI/3V3_CAM3: J12.1, R87.2, R185.2, U7.1 (OUT)
/CSI/3V3_CAM3_ISET: R86.1, U7.5 (ISET)
/CSI/I2C_MUX_A0: R34.1, R35.2, U26.22 (A0)
/CSI/I2C_MUX_RESET: R144.1, U26.24 (~RESET)
/CSI/I2C_MUX_SCL: R142.2, U26.19 (SCL)
/CSI/I2C_MUX_SDA: R53.1, U26.20 (SDA)
/CSI/MUX_I2C_4_SCL: TP9.1, U26.11 (SC4)
/CSI/MUX_I2C_4_SDA: TP8.1, U26.10 (SD4)
/CSI/MUX_I2C_5_SCL: TP14.1, U26.13 (SC5)
/CSI/MUX_I2C_5_SDA: TP13.1, U26.12 (SD5)
/CSI/MUX_I2C_6_SCL: TP18.1, U26.15 (SC6)
/CSI/MUX_I2C_6_SDA: TP17.1, U26.14 (SD6)
/CSI/MUX_I2C_7_SCL: TP20.1, U26.17 (SC7)
/CSI/MUX_I2C_7_SDA: TP19.1, U26.16 (SD7)
/CSI/SCL_CAM0: J1#2.3, R54.2, U26.2 (SC0)
/CSI/SCL_CAM1: J6.3, R48.2, U26.4 (SC1)
/CSI/SCL_CAM2: J9.3, R26.2, U26.6 (SC2)
/CSI/SCL_CAM3: J12.3, R101.2, U26.8 (SC3)
/CSI/SDA_CAM0: J1#2.2, R63.2, U26.1 (SD0)
/CSI/SDA_CAM1: J6.2, R36.2, U26.3 (SD1)
/CSI/SDA_CAM2: J9.2, R55.2, U26.5 (SD2)
/CSI/SDA_CAM3: J12.2, R102.2, U26.7 (SD3)
/CSI/VSYNC_CAM0_3V3: J1#2.5, U31.1 (B_{2})
/CSI/VSYNC_CAM1_3V3: J6.5, U31.8 (B_{1})
/CSI/VSYNC_CAM2_3V3: J9.5, U32.1 (B_{2})
/CSI/VSYNC_CAM3_3V3: J12.5, U32.8 (B_{1})
/HDMI/5V_HDMI: C51.1, C99.1, D20.1 (K), J13.18 (+5V), R177.2, R179.1, U43.7 (VCC_{B})
/HDMI/HDMI_CEC_5V: J13.14 (CEC), TP5.1, U46.5, U46.6
/HDMI/HDMI_CLK_CONN_N: J13.12 (CK-), RN2.5 (R4.2), U45.1, U45.10
/HDMI/HDMI_CLK_CONN_P: J13.11 (CK+), RN2.6 (R3.2), U45.2, U45.9
/HDMI/HDMI_CLK_N: C92.2, R132.1, RN2.4 (R4.1)
/HDMI/HDMI_CLK_P: C52.2, R133.1, RN2.3 (R3.1)
/HDMI/HDMI_D0_CONN_N: J13.9 (D0-), RN2.7 (R2.2), U45.4, U45.7
/HDMI/HDMI_D0_CONN_P: J13.8 (D0+), RN2.8 (R1.2), U45.5, U45.6
/HDMI/HDMI_D0_N: C88.2, R134.1, RN2.2 (R2.1)
/HDMI/HDMI_D0_P: C50.2, R135.1, RN2.1 (R1.1)
/HDMI/HDMI_D1_CONN_N: J13.6 (D1-), RN1.5 (R4.2), U44.1, U44.10
/HDMI/HDMI_D1_CONN_P: J13.5 (D1+), RN1.6 (R3.2), U44.2, U44.9
/HDMI/HDMI_D1_N: C87.2, R136.1, RN1.4 (R4.1)
/HDMI/HDMI_D1_P: C49.2, R137.1, RN1.3 (R3.1)
/HDMI/HDMI_D2_CONN_N: J13.3 (D2-), RN1.7 (R2.2), U44.4, U44.7
/HDMI/HDMI_D2_CONN_P: J13.2 (D2+), RN1.8 (R1.2), U44.5, U44.6
/HDMI/HDMI_D2_N: C86.2, R138.1, RN1.2 (R2.1)
/HDMI/HDMI_D2_P: C45.2, R139.1, RN1.1 (R1.1)
/HDMI/HDMI_HPD_5V: J13.19 (HPD/HEAC-), R49.2, U46.1, U46.10
/HDMI/HDMI_HPD_5V_R: Q12.1 (G), R49.1, R178.1
/HDMI/HDMI_SCL_3V3: R140.2, R176.1, U43.4 (A_{2})
/HDMI/HDMI_SCL_5V: J13.15 (SCL), R179.2, U43.1 (B_{2}), U46.4, U46.7
/HDMI/HDMI_SDA_3V3: R141.2, R175.2, U43.5 (A_{1})
/HDMI/HDMI_SDA_5V: J13.16 (SDA), R177.1, U43.8 (B_{1}), U46.2, U46.9
/M.2/3V3_M2: C21.1, C22.1, C23.1, C24.1, J2#2.2 (3V3), J2#2.4 (3V3), J2#2.12 (3V3), J2#2.14 (3V3), J2#2.16 (3V3), J2#2.18 (3V3), J2#2.70 (3V3), J2#2.72 (3V3), J2#2.74 (3V3), R143.2
/M.2/32.7KHZ_OUT: R19.2, Y1.3 (OUT)
/M.2/C_PCIE0_TX0_N: C17.2, J2#2.47 (PET0_N)
/M.2/C_PCIE0_TX0_P: C13.2, J2#2.49 (PET0_P)
/M.2/C_PCIE0_TX1_N: C18.1, J2#2.35 (PET1_N)
/M.2/C_PCIE0_TX1_P: C14.1, J2#2.37 (PET1_P)
/M.2/C_PCIE0_TX2_N: C19.1, J2#2.23 (PET2_N)
/M.2/C_PCIE0_TX2_P: C15.1, J2#2.25 (PET2_P)
/M.2/C_PCIE0_TX3_N: C20.2, J2#2.11 (PET3_N)
/M.2/C_PCIE0_TX3_P: C16.1, J2#2.13 (PET3_P)
/M.2/M2_M_SMB_CLK: J2#2.40 (SMB_CLK), TP12.1
/M.2/M2_M_SMB_DATA: J2#2.42 (SMB_DATA), TP11.1
/M.2/M2_M_SUSCLK: J2#2.68 (SUSCLK), R19.1
/M.2/PCIE_WAKE_SEL0: J2#2.54 (~PEWAKE), R13.2
/M.2/~M2_M_ALERT: J2#2.44 (ALERT), TP10.1
/Peripherals/FAN_PWM_5V: J10.4, U33.1 (B_{2})
/Peripherals/FAN_TACH_5V: J10.3, U33.8 (B_{1})
/Peripherals/SHUTDOWN_REQ_MB: D8.2 (A), J8.2, R18.2
/SoM/DEBUG_RXD_1V8: J15.238 (UART2_RXD), U4.4 (A_{2})
/SoM/DEBUG_TXD_1V8: J15.236 (UART2_TXD), U4.5 (A_{1})
/SoM/PMIC_BBAT: D21.1 (K), J15.235 (PMIC_BBAT), R174.1
/SoM/SoM_5V_IN: C1.1, C2.1, C3.1, C4.1, C35.1, C36.1, C46.1, FB1.2, J15.251 (VDD_IN), J15.252 (VDD_IN), J15.253 (VDD_IN), J15.254 (VDD_IN), J15.255 (VDD_IN), J15.256 (VDD_IN), J15.257 (VDD_IN), J15.258 (VDD_IN), J15.259 (VDD_IN), J15.260 (VDD_IN)
/SoM/~FORCE_RECOVERY: BTN1.1, D15.2 (A2), J15.214 (~FORCE_RECOVERY)
/Supply/1V8_LDO: C107.1, R171.2, U42.5 (VOUT)
/Supply/3V3_EN: R160.2, U29.12 (EN)
/Supply/3V3_FB: R165.1, R166.1, U29.14 (FB)
/Supply/3V3_LDO: C106.1, R170.2, U41.1 (V_{OUT})
/Supply/3V3_OUT: C78.1, C81.1, C84.1, C90.1, L2.2, R165.2, R169.1
/Supply/3V3_SW: C104.1, L2.1, U29.6 (SW), U29.19 (SW), U29.20 (SW)
/Supply/5V0_EN: R82.1, U1.12 (EN)
/Supply/5V_FB: R163.2, R164.2, U1.14 (FB)
/Supply/5V_OUT: C80.1, C82.1, C85.1, C91.1, L1.2, R163.1, R168.2
/Supply/5V_SW: C102.1, L1.1, U1.6 (SW), U1.19 (SW), U1.20 (SW)
/Supply/A0: R62.1, U6.8 (A0)
/Supply/A1: R91.1, U6.9 (A1)
/USB3, Recovery/USBC1_ADDR: R113.1, R114.2, U17.22 (ADDR)
/USB3, Recovery/USBC1_CC1: J5#2.A5 (CC1), U17.2 (CC1), U21.1, U21.10
/USB3, Recovery/USBC1_CC2: J5#2.B5 (CC2), U17.1 (CC2), U21.5, U21.6
/USB3, Recovery/USBC1_CONN_TX1_N: C70.1, J5#2.A2 (TX1+), U20.2, U20.9
/USB3, Recovery/USBC1_CONN_TX1_P: C71.1, J5#2.A3 (TX1-), U20.1, U20.10
/USB3, Recovery/USBC1_CONN_TX2_N: C69.1, J5#2.B2 (TX2+), U19.4, U19.7
/USB3, Recovery/USBC1_CONN_TX2_P: C72.1, J5#2.B3 (TX2-), U19.5, U19.6
/USB3, Recovery/USBC1_DIR: R126.1, U17.11 (DIR)
/USB3, Recovery/USBC1_FAULT_N: R120.2, TP27.1, U17.24 (VCONN_FAULT_N)
/USB3, Recovery/USBC1_I2C_SDA: R111.2, R124.2, U17.25 (SDA/OUT1)
/USB3, Recovery/USBC1_ID: Q4.1 (G), R23.1, R24.1, R122.1, TP26.1, U17.27 (ID)
/USB3, Recovery/USBC1_INT: R110.2, U17.23 (INT_N/OUT3)
/USB3, Recovery/USBC1_ISC_SCL: R112.2, R125.2, U17.26 (SCL/OUT2)
/USB3, Recovery/USBC1_ISET: R130.1, U18.5 (ISET)
/USB3, Recovery/USBC1_I_MODE: R116.2, U17.3 (CURRENT_MODE)
/USB3, Recovery/USBC1_PORT: R115.1, U17.4 (PORT)
/USB3, Recovery/USBC1_RX1_N: J5#2.B10 (RX1-), U17.14 (RX1-), U20.5, U20.6
/USB3, Recovery/USBC1_RX1_P: J5#2.B11 (RX1+), U17.15 (RX1+), U20.4, U20.7
/USB3, Recovery/USBC1_RX2_N: J5#2.A10 (RX2-), U17.18 (RX2-), U19.1, U19.10
/USB3, Recovery/USBC1_RX2_P: J5#2.A11 (RX2+), U17.19 (RX2+), U19.2, U19.9
/USB3, Recovery/USBC1_TX1_N: C70.2, U17.16 (TX1-)
/USB3, Recovery/USBC1_TX1_P: C71.2, U17.17 (TX1+)
/USB3, Recovery/USBC1_TX2_N: C69.2, U17.20 (TX2-)
/USB3, Recovery/USBC1_TX2_P: C72.2, U17.21 (TX2+)
/USB3, Recovery/USBC1_VBUS: C74.2, C75.2, D5.1 (K), J5#2.A4 (VBUS), J5#2.A9 (VBUS), J5#2.B4 (VBUS), J5#2.B9 (VBUS), R60.1, R128.1, R131.1, U18.1 (OUT)
/USB3, Recovery/USBC1_VBUS_DET: R128.2, U17.5 (VBUS_DET)
/USB3, Recovery/USBSS1_C_RX_N: R103.2, U17.10 (RX-)
/USB3, Recovery/USBSS1_C_RX_P: R107.2, U17.9 (RX+)
/USB3, Recovery/USBSS1_C_TX_N: R108.2, U17.7 (TX-)
/USB3, Recovery/USBSS1_C_TX_P: R109.2, U17.6 (TX+)
/USB3, Recovery/~USBC1_EN_CC: R119.2, U17.29 (ENn_CC)
/USB3, Recovery/~USBC1_EN_MUX: R118.2, U17.12 (ENn_MUX)
/USB Debug, USB2/FTDI_3V3: C27.2, C29.2, C34.2, R46.2, R72.1, R73.2, U5.1 (V_{CCIO}), U5.8 (3V3_{OUT}), U5.10 (V_{CC}), U8.1 (V_{OUT})
/USB Debug, USB2/FTDI_CBUS0: TP15.1, U5.12 (CBUS0)
/USB Debug, USB2/FTDI_CBUS3: TP16.1, U5.14 (CBUS3)
/USB Debug, USB2/FTDI_LED_RX: D3.1 (K), U5.11 (CBUS1)
/USB Debug, USB2/FTDI_LED_TX: D2.1 (K), U5.5 (CBUS2)
/USB Debug, USB2/USBC3_CC1: J3.A5 (CC1), R99.1, U11.1, U11.10
/USB Debug, USB2/USBC3_CC2: J3.B5 (CC2), R100.1, U11.5, U11.6
/USB Debug, USB2/USBC3_D_N: C94.1, J3.A7 (D-), J3.B7 (D-), R117.1, U11.4, U11.7
/USB Debug, USB2/USBC3_D_P: C95.2, J3.A6 (D+), J3.B6 (D+), R127.1, U11.2, U11.9
/USB Debug, USB2/USBC3_VBUS: C32.2, C42.2, C64.2, D6.1 (K), J3.A4 (VBUS), J3.A9 (VBUS), J3.B4 (VBUS), J3.B9 (VBUS), R105.1, U8.4 (EN), U8.6 (V_{IN})
/USB Debug, USB2/USB_FTDI_N: R117.2, U5.7 (D-)
/USB Debug, USB2/USB_FTDI_P: R127.2, U5.6 (D+)
CAM0_FLG: R66.2, R84.2, U24.3 (FLG)
CAM0_PEN: R2.2, R92.2, R180.2, U24.4 (EN)
CAM1_FLG: R3.2, R93.2, U25.3 (FLG)
CAM1_PEN: R6.2, R40.2, R94.2, U25.4 (EN)
CAM2_FLG: R64.2, R95.2, U3.3 (FLG)
CAM2_PEN: R9.2, R10.2, R96.2, U3.4 (EN)
CAM3_FLG: R67.2, R97.2, U7.3 (FLG)
CAM3_PEN: R50.2, R51.2, R98.2, U7.4 (EN)
CSI0_CLK_N: J1#2.8, J15.10 (CSI0_CLK_N)
CSI0_CLK_P: J1#2.7, J15.12 (CSI0_CLK_P)
CSI0_D0_N: J1#2.14, J15.4 (CSI0_D0_N)
CSI0_D0_P: J1#2.13, J15.6 (CSI0_D0_P)
CSI0_D1_N: J1#2.11, J15.16 (CSI0_D1_N)
CSI0_D1_P: J1#2.10, J15.18 (CSI0_D1_P)
CSI1_CLK_N: J6.8, J15.9 (CSI1_CLK_N)
CSI1_CLK_P: J6.7, J15.11 (CSI1_CLK_P)
CSI1_D0_N: J6.14, J15.3 (CSI1_D0_N)
CSI1_D0_P: J6.13, J15.5 (CSI1_D0_P)
CSI1_D1_N: J6.11, J15.15 (CSI1_D1_N)
CSI1_D1_P: J6.10, J15.17 (CSI1_D1_P)
CSI2_CLK_N: J9.8, J15.28 (CSI2_CLK_N)
CSI2_CLK_P: J9.7, J15.30 (CSI2_CLK_P)
CSI2_D0_N: J9.14, J15.22 (CSI2_D0_N)
CSI2_D0_P: J9.13, J15.24 (CSI2_D0_P)
CSI2_D1_N: J9.11, J15.34 (CSI2_D1_N)
CSI2_D1_P: J9.10, J15.36 (CSI2_D1_P)
CSI3_CLK_N: J12.8, J15.27 (CSI3_CLK_N)
CSI3_CLK_P: J12.7, J15.29 (CSI3_CLK_P)
CSI3_D0_N: J12.14, J15.21 (CSI3_D0_N)
CSI3_D0_P: J12.13, J15.23 (CSI3_D0_P)
CSI3_D1_N: J12.11, J15.33 (CSI3_D1_N)
CSI3_D1_P: J12.10, J15.35 (CSI3_D1_P)
DEBUG_RXD: R56.2, U4.1 (B_{2})
DEBUG_TXD: R57.2, U4.8 (B_{1})
DP1_HDMI_AUX_N: J15.98 (DP1_AUX_N), R141.1
DP1_HDMI_AUX_P: J15.100 (DP1_AUX_P), R140.1
DP1_HPD: J15.96 (DP1_HPD), Q12.3 (D), R47.2, TP22.1
DP1_TXD0_HDMI_TX2_N: C86.1, J15.63 (DP1_TXD0_N)
DP1_TXD0_HDMI_TX2_P: C45.1, J15.65 (DP1_TXD0_P)
DP1_TXD1_HDMI_TX1_N: C87.1, J15.69 (DP1_TXD1_N)
DP1_TXD1_HDMI_TX1_P: C49.1, J15.71 (DP1_TXD1_P)
DP1_TXD2_HDMI_TX0_N: C88.1, J15.75 (DP1_TXD2_N)
DP1_TXD2_HDMI_TX0_P: C50.1, J15.77 (DP1_TXD2_P)
DP1_TXD3_HDMI_TXC_N: C92.1, J15.81 (DP1_TXD3_N)
DP1_TXD3_HDMI_TXC_P: C52.1, J15.83 (DP1_TXD3_P)
FAN_PWM: J15.230 (GPIO14/PWM), U33.4 (A_{2})
FAN_TACH: J15.208 (Fan_Tach/GPIO08), U33.5 (A_{1})
GND: BT1.2 (-), BTN1.2, BTN1.SH, BTN3.SH, C1.2, C2.2, C3.2, C4.2, C5.1, C6.2, C7.2, C8.1, C12.1, C21.2, C22.2, C23.2, C24.2, C25.1, C26.1, C27.1, C28.2, C29.1, C30.2, C31.2, C32.1, C34.1, C35.2, C36.2, C37.2, C38.2, C39.1, C40.2, C41.2, C42.1, C43.1, C44.2, C46.2, C47.1, C48.2, C51.2, C58.2, C59.1, C64.1, C65.2, C66.1, C67.1, C68.1, C73.1, C74.1, C75.1, C76.2, C77.1, C78.2, C79.1, C80.2, C81.2, C82.2, C83.2, C84.2, C85.2, C89.1, C90.2, C91.2, C93.2, C94.2, C95.1, C96.2, C97.2, C98.2, C99.2, C100.2, C101.2, C103.1, C105.2, C106.2, C107.2, D4.1 (K), D5.2 (A), D6.2 (A), D7.2 (A), D9.1 (K), D10.1 (K), D11.1 (K), D12.1 (K), D13.1 (K), D14.1 (K), D15.1 (A1), D16.1 (A1), D25.2 (A), D26.2 (A), D27.2 (A), D28.2 (A), H1.1, H1#2.1 (1_1), H2.1 (1_1), H2#2.1, H3.1 (1_1), H3#2.1, H4.1 (1_1), H4#2.1, H5.1 (1_1), H5#2.1, H6.1, H6#2.1 (1_1), H7.1, J1.3, J1.4, J1.MP (MountPin), J1#2.6, J1#2.9, J1#2.12, J1#2.15, J1#2.MP (MountPin), J2.3, J2.4, J2#2.1 (GND), J2#2.3 (GND), J2#2.9 (GND), J2#2.15 (GND), J2#2.21 (GND), J2#2.27 (GND), J2#2.33 (GND), J2#2.39 (GND), J2#2.45 (GND), J2#2.51 (GND), J2#2.57 (GND), J2#2.71 (GND), J2#2.73 (GND), J2#2.75 (GND), J2#2.MP1 (MP), J2#2.MP2 (MP), J3.A1 (GND), J3.A12 (GND), J3.B1 (GND), J3.B12 (GND), J3.S1 (SHIELD), J4.11, J4.12, J4.13, J4.14, J4.15, J4.16, J4.17, J4.18, J4.19, J4.20, J4.25, J4.26, J4.27, J4.28, J4.35, J4.41, J4.44, J4.47, J4.59, J4.60, J4.SH (Shield), J5#2.A1 (GND), J5#2.A12 (GND), J5#2.B1 (GND), J5#2.B12 (GND), J5#2.SH, J6.6, J6.9, J6.12, J6.15, J6.MP (MountPin), J7.5, J7.6, J7.7, J7.10, J7.MP (MountPin), J8.1, J8.5, J8.7, J8.10, J8.MP (MountPin), J9.6, J9.9, J9.12, J9.15, J9.MP (MountPin), J10.1, J10.MP (MountPin), J12.6, J12.9, J12.12, J12.15, J12.MP (MountPin), J13.1 (D2S), J13.4 (D1S), J13.7 (D0S), J13.10 (CKS), J13.13 (GND), J13.SH, J15.1 (GND), J15.2 (GND), J15.7 (GND), J15.8 (GND), J15.13 (GND), J15.14 (GND), J15.19 (GND), J15.20 (GND), J15.25 (GND), J15.26 (GND), J15.31 (GND), J15.32 (GND), J15.37 (GND), J15.38 (GND), J15.43 (GND), J15.44 (GND), J15.49 (GND), J15.50 (GND), J15.55 (GND), J15.56 (GND), J15.61 (GND), J15.62 (GND), J15.67 (GND), J15.68 (GND), J15.73 (GND), J15.74 (GND), J15.79 (GND), J15.80 (GND), J15.85 (GND), J15.86 (GND), J15.102 (GND), J15.107 (GND), J15.113 (GND), J15.119 (GND), J15.125 (GND), J15.129 (GND), J15.132 (GND), J15.135 (GND), J15.138 (GND), J15.141 (GND), J15.144 (GND), J15.146 (GND), J15.147 (GND), J15.152 (GND), J15.153 (GND), J15.158 (GND), J15.159 (GND), J15.164 (GND), J15.165 (GND), J15.170 (GND), J15.171 (GND), J15.176 (GND), J15.177 (GND), J15.200 (GND), J15.201 (GND), J15.231 (GND), J15.241 (GND), J15.242 (GND), J15.243 (GND), J15.244 (GND), J15.245 (GND), J15.246 (GND), J15.247 (GND), J15.248 (GND), J15.249 (GND), J15.250 (GND), J15.261 (MP), J15.262 (MP), Q1.1 (S2), Q1.4 (S1), Q2.2 (S), Q4.2 (S), Q5.2 (S), Q8.2 (S), Q9.1 (S2), Q9.4 (S1), Q12.2 (S), Q13.2 (S), R2.1, R6.1, R7.2, R8.2, R10.1, R16.1, R35.1, R51.1, R61.2, R62.2, R85.2, R86.2, R91.2, R99.2, R100.2, R114.1, R118.1, R119.1, R130.2, R153.2, R157.1, R159.2, R164.1, R166.2, R178.2, SW1.S4 (SH), U1.7 (PGND), U1.8 (PGND), U1.13 (AGND), U1.18 (PGND), U1.21 (PGND), U2.2 (GND_1), U2.3 (GND_2), U2.6 (GNDIO), U2.7 (GND_3), U3.2 (GND), U4.2 (GND), U5.3 (GND), U5.13 (GND), U5.17 (GND), U6.4 (GND), U7.2 (GND), U8.3 (GND), U8.5 (PG), U8.7 (GND), U9.2 (GND), U11.3, U11.8, U17.13 (GND), U17.28 (GND), U17.31 (GND), U18.2 (GND), U19.3, U19.8, U20.3, U20.8, U21.3, U21.8, U24.2 (GND), U25.2 (GND), U26.9 (GND), U26.18 (A2), U26.23 (A1), U26.25 (EP), U29.7 (PGND), U29.8 (PGND), U29.13 (AGND), U29.18 (PGND), U29.21 (PGND), U31.2 (GND), U32.2 (GND), U33.2 (GND), U41.3 (GND), U41.5 (PG), U41.7 (GND), U42.2 (GND), U43.2 (GND), U44.3, U44.8, U45.3, U45.8, U46.3, U46.8, Y1.2 (GND)
I2C1_SCL: J15.189 (I2C1_SCL), U2.13 (SCX)
I2C1_SDA: J15.191 (I2C1_SDA), U2.14 (SDX)
JETSON_EN: J8.6, SW1.1
JETSON_RST: R81.2, TP31.1
MB_JETSON_RX: J8.8, U9.8 (B_{1})
MB_JETSON_TX: J8.9, U9.1 (B_{2})
MB_SCL: J8.4, Q7.1 (E1), Q7.3 (C2), R71.1
MB_SDA: J8.3, Q10.1 (E1), Q10.3 (C2), R74.1
MCLK_CAM0: J1#2.4, J15.116 (CAM0_MCLK)
MCLK_CAM1: J6.4, J15.122 (CAM1_MCLK)
MCLK_CAM2: J9.4, J15.118 (GPIO01/CLK)
MCLK_CAM3: J12.4, J15.216 (GPIO11/CLK)
unnamed: BT1.1 (+), R174.2
unnamed: D1.2 (A), R39.2
unnamed: D1.1 (K), J2#2.10 (LED)
unnamed: D2.2 (A), R72.2
unnamed: D3.2 (A), R73.1
unnamed: D4.2 (A), R105.2
unnamed: D8.1 (K), R15.2
unnamed: D9.2 (A), R131.2
unnamed: D10.2 (A), R87.1
unnamed: D11.2 (A), R88.1
unnamed: D12.2 (A), R89.1
unnamed: D13.2 (A), R90.1
unnamed: D14.2 (A), R148.2
unnamed: BTN3.2, C103.2, D16.2 (A2), Q8.1 (G), R81.1, R153.1
unnamed: D20.2 (A), FB2.2
unnamed: J15.210 (CLK_32K_OUT), TP7.1
unnamed: J15.114 (CAM0_PWDN), R12.2
unnamed: J15.120 (CAM1_PWDN), R11.1
unnamed: J15.195 (I2S0_DIN), R93.1
unnamed: J15.193 (I2S0_DOUT), R92.1
unnamed: J15.197 (I2S0_FS), R94.1
unnamed: J15.199 (I2S0_SCLK), R84.1
unnamed: J15.222 (I2S1_DIN), R97.1
unnamed: J15.220 (I2S1_DOUT), R96.1
unnamed: J15.224 (I2S1_FS), R98.1
unnamed: J15.226 (I2S1_SCLK), R95.1
unnamed: J15.94 (HDMI_CEC), TP25.1
unnamed: J15.218 (GPIO12/PWM), R4.1
unnamed: J15.228 (GPIO13/PWM), R5.1
unnamed: Q1.6 (D1), Q7.5 (B2), R59.2, R68.2
unnamed: Q1.2 (G2), Q1.3 (D2), R65.2
unnamed: C28.1, Q1.5 (G1), R70.2
unnamed: Q2.3 (D), R132.2, R133.2, R134.2, R135.2, R136.2, R137.2, R138.2, R139.2
unnamed: Q4.3 (D), R129.2, U18.4 (EN)
unnamed: Q5.3 (D), Q6.1 (G), R172.2
unnamed: Q7.2 (B1), R59.1
unnamed: Q9.2 (G2), Q9.3 (D2), R76.2
unnamed: C30.1, Q9.5 (G1), R79.2
unnamed: Q10.2 (B1), R75.1
unnamed: Q9.6 (D1), Q10.5 (B2), R75.2, R77.2
unnamed: Q13.1 (G), R24.2, R60.2, R61.1
unnamed: R14.1, SW1.3
unnamed: R155.1, SW1.2
unnamed: C102.2, U1.1 (BST)
unnamed: R156.2, R157.2, U1.15 (MODE)
unnamed: R161.2, U1.9 (PG)
unnamed: C93.1, R156.1, R161.1, U1.17 (V_{CC})
unnamed: R16.2, U2.1 (SDO)
unnamed: R57.1, U5.2 (RXD)
unnamed: R56.1, U5.15 (TXD)
unnamed: C31.1, R46.1, U5.9 (~RESET)
unnamed: R25.2, U6.3 (ON)
unnamed: C26.2, U6.5 (TIMER)
unnamed: C104.2, U29.1 (BST)
unnamed: R158.1, R159.1, U29.15 (MODE)
unnamed: R162.2, U29.9 (PG)
unnamed: C77.2, R158.2, R162.1, U29.17 (V_{CC})
unnamed: R167.2, U42.3 (EN)
PCIE0_CLKREQ*: J2#2.52 (~CLKREQ), J15.180 (~PCIE0_CLKREQ), R38.2
PCIE0_CLK_N: J2#2.53 (REFCLK_N), J15.160 (PCIE0_CLK_N)
PCIE0_CLK_P: J2#2.55 (REFCLK_P), J15.162 (PCIE0_CLK_P)
PCIE0_RST*: J2#2.50 (~PERST), J15.181 (~PCIE0_RST), R37.2
PCIE0_RX0_N: J2#2.41 (PER0_N), J15.131 (PCIE0_RX0_N)
PCIE0_RX0_P: J2#2.43 (PER0_P), J15.133 (PCIE0_RX0_P)
PCIE0_RX1_N: J2#2.29 (PER1_N), J15.137 (PCIE0_RX1_N)
PCIE0_RX1_P: J2#2.31 (PER1_P), J15.139 (PCIE0_RX1_P)
PCIE0_RX2_N: J2#2.17 (PER2_N), J15.149 (PCIE0_RX2_N)
PCIE0_RX2_P: J2#2.19 (PER2_P), J15.151 (PCIE0_RX2_P)
PCIE0_RX3_N: J2#2.5 (PER3_N), J15.155 (PCIE0_RX3_N)
PCIE0_RX3_P: J2#2.7 (PER3_P), J15.157 (PCIE0_RX3_P)
PCIE0_TX0_N: C17.1, J15.134 (PCIE0_TX0_N)
PCIE0_TX0_P: C13.1, J15.136 (PCIE0_TX0_P)
PCIE0_TX1_N: C18.2, J15.140 (PCIE0_TX1_N)
PCIE0_TX1_P: C14.2, J15.142 (PCIE0_TX1_P)
PCIE0_TX2_N: C19.2, J15.148 (PCIE0_TX2_N)
PCIE0_TX2_P: C15.2, J15.150 (PCIE0_TX2_P)
PCIE0_TX3_N: C20.1, J15.154 (PCIE0_TX3_N)
PCIE0_TX3_P: C16.2, J15.156 (PCIE0_TX3_P)
PCIE_WAKE*: J15.179 (~PCIE_WAKE), R13.1
POWER_EN: J15.237 (POWER_EN), R155.2
PWR_SCL: Q7.4 (E2), Q7.6 (C1), R69.2, R70.1, R71.2, U6.6 (SCL)
PWR_SDA: Q10.4 (E2), Q10.6 (C1), R74.2, R78.2, R79.1, U6.7 (SDA)
SCL_CAM: J15.213 (CAM_I2C_SCL), R142.1
SDA_CAM: J15.215 (CAM_I2C_SDA), R53.2
SLEEP/~WAKE: J15.240 (SLEEP/~WAKE), TP29.1
SYS_SCL: J15.185 (I2C0_SCL), R125.1
SYS_SDA: J15.187 (I2C0_SDA), R124.1
UART1_RXD: J15.205 (UART1_RXD), U9.5 (A_{1})
UART1_TXD: J15.203 (UART1_TXD), U9.4 (A_{2})
USB0_D_N: J5#2.A7 (D-), J5#2.B7 (D-), J15.109 (USB0_D_N), U21.4, U21.7
USB0_D_P: J5#2.A6 (D+), J5#2.B6 (D+), J15.111 (USB0_D_P), U21.2, U21.9
USB1_D_N: J7.9, J15.115 (USB1_D_N)
USB1_D_P: J7.8, J15.117 (USB1_D_P)
USBC1_FLG: J15.128 (GPIO05), R123.2, U18.3 (FLG)
USBC1_PEN: J15.127 (GPIO04), R121.2, R122.2, R129.1
USBSS2_RX_N: J15.51 (USBSS2_RX_N), R103.1
USBSS2_RX_P: J15.53 (USBSS2_RX_P), R107.1
USBSS2_TX_N: J15.57 (USBSS2_TX_N), R108.1
USBSS2_TX_P: J15.59 (USBSS2_TX_P), R109.1
USB_FLASH_ID: J15.87 (USB_VBUS_EN0/GPIO00), Q13.3 (D), R23.2
VBATT: D7.1 (K), J1.1, J1.2, J2.1, J2.2, J4.1, J4.2, J4.3, J4.4, J4.5, J4.6, J4.7, J4.8, J4.9, J4.10, R1.2, R148.1, U6.1 (VCC)
VCC: C5.2, C6.1, C58.1, C59.2, C65.1, C76.1, C105.1, R1.1, R25.1, U1.2 (V_{IN}), U1.3 (V_{IN}), U1.4 (V_{IN}), U1.5 (V_{IN}), U6.2 (SENSE), U29.2 (V_{IN}), U29.3 (V_{IN}), U29.4 (V_{IN}), U29.5 (V_{IN}), U41.4 (EN), U41.6 (V_{IN})
VSYNC_CAM0: R12.1, U31.4 (A_{2})
VSYNC_CAM1: R11.2, U31.5 (A_{1})
VSYNC_CAM2: R4.2, U32.4 (A_{2})
VSYNC_CAM3: R5.2, U32.5 (A_{1})
~MOD_SLEEP: J15.178 (~MOD_SLEEP), TP30.1
~RESET: J15.239 (~SYS_RESET), Q5.1 (G), Q8.3 (D), R160.1, R167.1, R181.1
~SHUTDOWN_REQ: J15.233 (~SHUTDOWN_REQ), R15.1
~USBC0_INT: J15.211 (GPIO09/AUD_MCLK), R31.2
~USBC1_INT: J15.212 (GPIO10), R80.1, R110.1
