cmu-argus-2/Avionics-JetsonCarrier/(commit log)

2025-03-10 v2.0 Schematic updates
    [USB3-2.kicad_sch, csi.kicad_sch, hdmi.kicad_sch, jetson-orin-baseboard.kicad_pcb, jetson-orin-baseboard.kicad_sch, m-2.kicad_sch, peripherals.kicad_sch, som.kicad_sch]
2025-04-16 v2.0 Layout completed. Exported BOM and STEP files
    [csi.kicad_sch, hdmi.kicad_sch, imu.kicad_sch, jetson-orin-baseboard.kicad_pcb, jetson-orin-baseboard.kicad_sch, m-2.kicad_sch, peripherals.kicad_sch, som.kicad_sch]
2025-05-05 Fix connector name
    [csi.kicad_sch, jetson-orin-baseboard.kicad_pcb, som.kicad_sch]
2025-06-18 v2.1 Updates
    [csi.kicad_sch, hdmi.kicad_sch, imu.kicad_sch, jetson-orin-baseboard.kicad_pcb, jetson-orin-baseboard.kicad_sch, m-2.kicad_sch, peripherals.kicad_sch, som.kicad_sch]
2026-01-21 Local Stash
    [supply.kicad_sch]
2026-02-09 Local Stash 2
    [jetson-orin-baseboard.kicad_pcb]
2026-09-04 Add KiCad-Libraries as submodule
2026-09-05 Initial layout attempt
    [csi.kicad_sch, hdmi.kicad_sch, imu.kicad_sch, jetson-orin-baseboard.kicad_pcb, jetson-orin-baseboard.kicad_sch, m-2.kicad_sch, peripherals.kicad_sch, som.kicad_sch]
2026-09-06 Finish HDMI routing, replace usbc w/ usba
    [hdmi.kicad_sch, jetson-orin-baseboard.kicad_pcb, jetson-orin-baseboard.kicad_sch, peripherals.kicad_sch, som.kicad_sch, usb.kicad_sch, usb3.kicad_sch]
2026-09-07 Add CSI, USB, HDMI, PCIe
    [csi.kicad_sch, hdmi.kicad_sch, imu.kicad_sch, jetson-orin-baseboard.kicad_pcb, jetson-orin-baseboard.kicad_sch, m-2.kicad_sch, peripherals.kicad_sch, som.kicad_sch]
2026-09-08 Power routing, CSI length matching, cleanup
    [csi.kicad_sch, hdmi.kicad_sch, jetson-orin-baseboard.kicad_pcb, peripherals.kicad_sch, som.kicad_sch, usb3.kicad_sch]
2026-09-09 Add power sequencing logic, layout
    [jetson-orin-baseboard.kicad_pcb, peripherals.kicad_sch, supply.kicad_sch]
2026-09-12 Add bus protection, upgrade sequencer
    [jetson-orin-baseboard.kicad_pcb, peripherals.kicad_sch, supply.kicad_sch]
2026-09-12 Layout cleanup, silk
    [csi.kicad_sch, hdmi.kicad_sch, jetson-orin-baseboard.kicad_pcb, m-2.kicad_sch, peripherals.kicad_sch, som.kicad_sch, supply.kicad_sch, usb.kicad_sch]
2026-09-12 route all diff pairs, length tuning
    [csi.kicad_sch, hdmi.kicad_sch, jetson-orin-baseboard.kicad_pcb, m-2.kicad_sch, peripherals.kicad_sch, som.kicad_sch, supply.kicad_sch, usb.kicad_sch]
2026-09-13 DRC cleanup
    [csi.kicad_sch, jetson-orin-baseboard.kicad_pcb, supply.kicad_sch]
2026-09-13 DRC errors resolved, silk placement
    [jetson-orin-baseboard.kicad_pcb, peripherals.kicad_sch]
2026-09-13 Move switch up top
    [jetson-orin-baseboard.kicad_pcb, som.kicad_sch]
2026-09-13 More cleanup
    [jetson-orin-baseboard.kicad_pcb]
2026-09-13 Move buttons up top, shorten reset trace, DRC
    [jetson-orin-baseboard.kicad_pcb, som.kicad_sch]
2026-09-13 additional cleanup
    [jetson-orin-baseboard.kicad_pcb, usb.kicad_sch]
2026-09-18 Move parts under SoM to bottom for thinner module connector
    [csi.kicad_sch, jetson-orin-baseboard.kicad_pcb, peripherals.kicad_sch, som.kicad_sch]
2026-09-20 general cleanup
    [jetson-orin-baseboard.kicad_pcb]
2026-09-21 Replace current monitor w/ INA226 (addr = 0x42)
    [csi.kicad_sch, hdmi.kicad_sch, jetson-orin-baseboard.kicad_pcb, m-2.kicad_sch, peripherals.kicad_sch, som.kicad_sch, supply.kicad_sch, usb.kicad_sch]
2026-09-24 Clean up silk, BOM
    [USB3-2.kicad_sch, imu.kicad_sch, jetson-orin-baseboard.kicad_pcb, supply.kicad_sch]
2026-09-24 Final cleanup, production files
    [USB3-2.kicad_sch, hdmi.kicad_sch, imu.kicad_sch, jetson-orin-baseboard.kicad_pcb, som.kicad_sch, supply.kicad_sch, usb3.kicad_sch]
2026-10-01 Add 3D models
    [jetson-orin-baseboard.kicad_pcb, usb3.kicad_sch]
2026-10-01 Add updated full PCBA STEP
    [jetson-orin-baseboard.kicad_pcb]
2026-10-01 Final BOM changes, gerbers
    [csi.kicad_sch, hdmi.kicad_sch, jetson-orin-baseboard.kicad_pcb, m-2.kicad_sch, peripherals.kicad_sch, som.kicad_sch, supply.kicad_sch, usb.kicad_sch]
